Git-Junsang/Quantum-Grover/documents/reports/15_교체판_보드_콘솔.md

# 실험 15. 통신 계층 교체판 보드 콘솔

> [← 실험 14 Common500 소프트웨어 · FPGA 비교](14_Common500_SW_FPGA_비교.md) · [index](index.md) · [실험 16 세 판의 보드 Predicate500 →](16_세_판_보드_Predicate500.md)

---

| 확인한 것 | 근거의 축 |
|---|---|
| 통신 계층 교체판이 실물 보드에서 SoC 시뮬과 같은 결과를 내는가. 성능 인용에는 쓰지 않음 | 보드 콘솔 한 세션 (워크로드 하나) |

2026-09-16에 통신 계층을 교체해 생성한 비트스트림을 Arty A7-100T에 기록하고, 호스트
PC에서 UART를 통해 `bbht_console`을 제어했습니다.

| 항목 | 값 |
|---|---|
| 비트스트림 | sha256 `1b67a070…52adc61` |
| 앱 | `bbht_console.sram.hex` (UART 판, sha256 `51e1684c…2e7cf3`) |
| 적재 | Olimex ARM-USB-TINY-H JTAG로 SRAM에 |
| 호스트 | Windows 11, `bbht_cli.py --port COM6` (115200 8N1) |
| 워크로드 | M = 4, 시드 0 (SoC 시뮬과 같은 것) |

## 결과

selftest 7/7, RUN · STAT · ENUM 결과 줄 26개가 SoC 시뮬 트랜스크립트와 글자 그대로
일치합니다.

| 실행 | idx | trials | l | iters | cyc |
|---|--:|--:|--:|--:|--:|
| Normal (`BURST=0`) | 8685 | 21 | 119 | 119 | 41,310 |
| 체크포인트 첫째 | 8685 | 21 | 119 | 38 | 20,935 |
| 체크포인트 둘째 | 8685 | 21 | 119 | 38 | 17,847 |
| `ENUM` | 8685 → 2852 → 507 → 4724 | | | | 280,494 |

정책 엔진 통계(`policy_cyc` · `memo_hit` · `max_latency` 등)까지 시뮬과 같습니다.

근거는 [board_console](../../hardware_bram/models/hardware_bram_K3H3_E4_M2/vivado/vivado_bbht_grover_fpga/2026-09-17_board_console/evidence.md),
실물과 굽기·적재 묶음은
[bitstream/2026-09-17_comm_layer_rebuild](../../hardware_bram/models/hardware_bram_K3H3_E4_M2/bitstream/2026-09-17_comm_layer_rebuild/evidence.md)
입니다.

## 처음 검증된 경로

호스트 → 보드 수신 경로입니다. `read_line()`의 UART 판과 `bbht_cli.py`의 시리얼
트랜스포트는 SoC 시뮬에서 한 번도 돌지 않았습니다(스크립트 모드는 명령을 컴파일 시점
배열에서 읽습니다). 이 층에서만 나올 수 있는 문제가 실제로 하나 있었습니다.

- COM 포트를 열 때 DTR/RTS가 켜지면 SoC가 리셋됩니다. 앱이 JTAG로 올린 SRAM
  이미지뿐이라, 기본 설정으로 포트를 열면 그 뒤로 에코조차 오지 않고(`ERR HOST_TIMEOUT`)
  앱을 다시 적재해야 돌아옵니다. 한 핸들로 열어 둔 채로는 OpenOCD 종료 뒤에도 계속
  응답하고, 닫았다 다시 열면 멈추는 것으로 좁혔습니다. `SerialTransport`가 열기 전에
  둘을 내리도록 고쳤습니다.
- Windows에서 `--script` · `--log` 파일을 cp949로 열어 한글 주석에서 죽던 것을 UTF-8로
  고쳤습니다.
