Git-Junsang/Quantum-Grover/Quantum-Grover/hardware_bram/configurations/capacity3_lookahead3_pes4_singlerow_linear/vivado/vivado_bbht_grover_k3h3_e4/2026-10-08_ax7a200b_board_predicate500/evidence.md

# Stage 4 — 200T board Predicate500 (네 predicate × 500 × 두 mode, 4,000/4,000)

## 무엇인가

원격 board AX7A200B 에 이 configuration의 100T 예산 bitstream을 굽고 `bbht_console` 을 올린 뒤, 같은 원격 host에서
`software/host_fpga_develop/bbht_predicate500.py` 로 네 predicate × 500 workloads를 Restart mode · Checkpoint mode로 돌렸습니다
(2026-10-08 22:34~23:02 KST, `hardware_bram/sim/board_run.sh K3H3_E4 predicate500`). 다섯 configuration을 차례로 잰 뒤 board는 원래 설계로 되돌렸습니다.

## 확정 수치

| mode | 실행 | reference model 대비 | RTL 대비 cycle | wall-clock time sum |
|---|--:|:-:|:-:|--:|
| Restart mode | 2,000 | 2,000/2,000 | 2,000/2,000 | 621,202 µs |
| Checkpoint mode | 2,000 | 2,000/2,000 | 1,833/2,000 | 360,952 µs |

20 datasets의 FNV-1a 도 reference model과 같습니다. predicate별 표는 `result.txt` 입니다. Checkpoint mode executed iterations는
a Checkpoint-Capacity of 3 · 3-shot Lookahead 열과 맞댔습니다.

Checkpoint mode cycle 중 RTL 과 다른 실행은 대부분 ±3,279 cycles(memo table 청소 한 번)입니다. board는 네 predicate를 reset 없이
이어 돌고 RTL harness는 predicate마다 따로 돌아 청소가 일어나는 실행이 다릅니다(11장 11.5절). 합계 차이는
-8,192 cycles(-0.023%)입니다.

## 인용할 때

- board wall-clock time 축, 200T board입니다. 성능 세 축의 Board-Verified Build(100T, EQ 500)와 섞지 마십시오.
- 여섯 configuration을 맞댄 표는 [2026-10-08_board_predicate500_6models](../../../../../results/2026-10-08_board_predicate500_6models/evidence.md), RTL 은 [여섯 configuration RTL](../../../../../results/2026-10-08_predicate500_rtl_6models/evidence.md) 입니다.

## file

| file | 내용 |
|---|---|
| `predicate500.csv` | 실행 4,000 rows (reference model 대조 열 포함) |
| `result.txt` | host 도구 출력 (predicate · mode별 sum과 판정) |
| `crosscheck.txt` | RTL Predicate500 과의 cycle 대조 |
| `sha256.txt` | 굽은 bitstream과 console hex hash |
