Git-Junsang/Quantum-Grover/documents/Main_IP_Final_20260910.pptx

최종 구현 내용 · 성능 결과 · 서버 패키지 확인 위치

Main IP Final v1.3

BBHT/Grover FPGA Emulator

FINAL CONFIG

K3/H3
E4
M2

Q14 · P32 · AMP_W23/F22
Standalone FPGA + RVX SoC path

6.1401×

500-workload RTL cycle speedup vs Normal-E1

Main IP Final v1.3 | 1

## Slide 2

1. 구현한 범위

서버 패키지에서 바로 확인할 구현 단위

하나의 Main IP를 중심에 두고, 보드 단독 실행 경로와 RVX SoC 실행 경로를 분리했다.
서버에는 RTL/TB/SW/FW와 결과 파일을 같은 기준값으로 재현할 수 있게 배치했다.

Accelerator core
BBHT shot FSM
Checkpoint/policy
Grover iteration datapath
Measurement + result/status

Standalone board path
UART→APB bridge
Deterministic dataset generator
Arty A7-100T top
Host benchmark script

RVX SoC path
APB CSR control
AHB/DMA data path
Firmware benchmark
ORCA SW baseline

핵심 설계 원칙

01_RTL

02_TB

03_SW_FW

04_BUILD

05_EXPERIMENTS

07_BOARD

Main IP Final v1.3 | 2

## Slide 3

2. 기준 configuration

후속 수정 전 반드시 맞춰야 하는 값

Search scale

Q14 / N = 16,384

Parallelism

P = 32 lanes

Fixed-point

AMP_W = 23 / F22

Checkpoint

K = 3 slots

Look-ahead

H = 3 future window

Iteration datapath

E4 = 4-row/cycle

Measurement

M2 = hierarchical measurement

Board target

Arty A7-100T

Main IP Final v1.3 | 3

## Slide 4

3. 사이클 성능: 6-stage ablation

500 common workloads 기준, DUT CSR_CYCLE_COUNT 합산

Normal-E1 42.31M cycles → K3/H3-E4-M2 6.89M cycles, aggregate speedup 6.1401×

Normal-E1

42,308,335

1.0000×

baseline

K4/H4-E1

18,349,320

2.3057×

checkpoint/policy

K4/H4-E4

11,246,755

3.7618×

4-row iteration

K3/H3-E4

10,385,795

4.0737×

policy retune

K3/H3-E4-M1

8,500,620

4.9771×

measurement M1

K3/H3-E4-M2

6,890,470

6.1401×

hierarchical measurement

최종 결과

Main IP Final v1.3 | 5

## Slide 5

4. 단계별 해석

각 단계가 줄인 부분과 비용

단계별 cycle은 같은 workload 집합에서 비교해야 한다. final headline은 500 common workloads의 6-stage aggregate를 우선한다.

Stage

변경점

Cycle change(250case X, 500case)

Prev. speedup

K4/H4-E1

checkpoint/policy

42.31M → 18.35M

2.31×

K4/H4-E4

E4 datapath

18.35M → 11.25M

1.63×

K3/H3-E4

policy retune

11.25M → 10.39M

1.08×

K3/H3-E4-M1

measurement M1

10.39M → 8.50M

1.22×

K3/H3-E4-M2

measurement M2

8.50M → 6.89M

1.23×

Main IP Final v1.3 | 6

## Slide 6

5. 왜 K3/H3인가

E4 이후에는 policy/checkpoint overhead를 줄이는 쪽이 유리

K/H를 키우는 것이 항상 유리한 것이 아니라, E4로 Grover body가 짧아진 뒤에는 작은 K/H가 전체 사이클에서 더 낫다.

−69.9%

policy actions

16,266 → 4,898

−55.5%

policy cycles

76,774 → 34,184

−72.9%

policy stall

15,160 → 4,114

<- “K4/H4-E4 → K3/H3-E4 기준”

K4/H4-E4 → K3/H3-E4 직접 비교

6-case aggregate cycles: 301,404 → 288,164 (1.0459×)
physical iteration은 +4.7%였지만 policy work 감소가 total cycle을 이김.

K/H isolated E1 250-pair

K4/H4: 8,836,298 cycles
K3/H4: 8,818,101 cycles
K3/H3: 8,596,609 cycles

Main IP Final v1.3 | 7

## Slide 7

6. E4와 M2 의미

최종 Main IP에서 cycle을 줄인 datapath/measurement 변경

E4
Grover iteration을 4-row/cycle로 처리하는 datapath.
K4/H4-E1 대비 Grover body cycle을 줄인다.

Measurement single-seed anchor (target=256, result/trial/L 동일)

M2는 최종 K3/H3-E4 구성의 measurement 병목을 추가로 줄이기 위한 compile-time option이다.

M2
Measurement의 hierarchical path.
group-CDF / S_GROUP_SCAN을 활성화해 scan 비용을 줄인다.

E4 baseline

M1=0 / M2=0

11,100 cycles

E4-M1

M1=1 / M2=0

9,052 cycles

E4-M2

M1=1 / M2=1

7,045 cycles

Main IP Final v1.3 | 8

## Slide 8

7. 보드 결과와 합성 결과

서버 패키지에서 확인할 핵심 산출물

Final M2는 보드 실행 산출물과 implementation report가 같이 보존된 최종 standalone 결과다.

250-pair 기준 cycle 변화

Normal Mode | K4H4(9/2미팅전) | K3H3-E4-M2(9/11미팅전)
20,229,755 (Iteration : 14883) | 7,796,908 (Iteration : 4247) | 2,563,403 (Iteration : 4457)

Board output
K3/H3-E4-M2 clean 250 pairs
CSV + LOG 보존

Timing / resource
WNS +0.224 ns
LUT 34,399 / FF 28,847
BRAM 84.5 / DSP 128

System comparison(Real Time)
K4/H4 Normal 425,502 μs
K4/H4-E1 164,897 μs
Final M2 55,798 μs
ORCA SW 6,496,338,005 μs

Main IP Final v1.3 | 9

## Slide 9

8. 서버에서 볼 위치

코드 · 검증 · 결과 파일을 찾는 기준 경로

core / standalone / RVX adapter

standalone TB, publication TB, K/H isolated

host bench, firmware, dataset reference

standalone/Vivado, RVX, simulation scripts

board, resource, publication, K/H raw/summary

expected CSV, golden summaries

bitstream, ELF, board test 자료

SHA, file index, provenance

00_README/README_START_HERE.md · 01_RTL/core/ · 05_EXPERIMENTS/summary · 99_MANIFEST/SHA256SUMS.txt

01_RTL

02_TB

03_SW_FW

04_BUILD

05_EXPERIMENTS

06_REFERENCE_OUTPUTS

07_BOARD

99_MANIFEST

먼저 열 파일

Main IP Final v1.3 | 10
