Git-Junsang/Quantum-Grover/hardware_bram/configurations/final/vivado/vivado_bbht_grover_fpga/2026-10-07_ax7a200b_budget100t/summary.csv

model | config | build | device | vivado | clock_MHz | WNS | TNS | WHS | THS | timing_met | LUT | FF | BRAM_tile | DSP | Slices | LUT_avail | FF_avail | BRAM_avail | DSP_avail | mainip_LUT | mainip_FF | mainip_RAMB36 | mainip_RAMB18 | mainip_DSP | power_W
K3H3_E4_M2 | K3/H3-E4-M2 | ax7a200b_budget100t | xc7a200tfbg484-2 | 2026.1 | 100 | 0.052 | 0.0 | 0.03 | 0.0 | 1 | 45316 | 45210 | 116 | 132 | 15118 | 63400 | 126800 | 135 | 240 | 32234 | 28221 | 52.0 | 64.0 | 128 | 0.59
