Git-Junsang/Quantum-Grover/documents/study_references/README.md

# Quantum-Grover — 양자컴퓨터 기초이론 학습 해설서

> **중앙대학교 학부 인턴 프로젝트**
> 다중 술어 Grover 가속기를 만들기 위한 양자컴퓨팅 기초 이론 ~ 확정 설계 해설

---

## 0. 이 해설서를 읽기 전에

### 0.1 이 문서는 무엇인가요?

이 문서는 **Grover 알고리즘 FPGA 가속기 프로젝트를 처음 접하는 학부생이 양자컴퓨팅의 기초 이론부터 확정된 하드웨어 설계까지 스스로 따라갈 수 있도록** 만든 학습 해설서입니다. 단순히 공식을 나열하는 것이 아니라, **"큐비트가 무엇인지"부터 시작해 "왜 그로버 알고리즘이 $O(\sqrt{N})$ 번의 오라클 호출로 정답을 찾는지"**, 그리고 **"그 수식이 결국 어떤 회로가 되는지"** 를 처음부터 끝까지 따라갈 수 있게 설명합니다.

만들 물건은 이렇게 확정되어 있습니다. BRAM에 올린 데이터 배열 `value[i]` 중 **술어를 만족하는 인덱스**를 그로버로 찾는 **에뮬레이터 IP**입니다. 술어는 네 종류 — `value < thr_a` · `value > thr_a` · `value == thr_a` · `thr_a < value < thr_b` — 이고, 그 술어를 만족하는 칸이 몇 개인지는 데이터가 정하므로 이 IP는 처음부터 **다중 타겟**을 전제로 설계됩니다. 출력은 두 가지입니다: 조건을 만족하는 원소 **하나**를 돌려주거나, 반복 호출로 **전부 열거**하거나. 보드는 **Arty A7-100T**(`xc7a100tcsg324-1`), SoC는 **RVX**(ETRI RISC-V eXpress, `rvc_orca` RV32 코어), 큐비트는 **$n = 14$**($N = 16{,}384$)이고, 최종 구성은 보드에서 검증된 **K3/H3-E4-M2**(체크포인트 3벌 · 정책 지평 3 · 연산기 4벌 · 측정 최적화 2단)입니다. 이 숫자들의 정본은 [15.4절 설계 결정표](15_논문지도와_설계결정표.md#154-우리-프로젝트의-좌표--확정-설계-결정표)이며, 해설서 어느 장에 같은 값이 적혀 있든 어긋나면 15.4절이 이깁니다.

하드웨어를 설계하려면 먼저 알고리즘이 수학적으로 무엇을 하는지 정확히 알아야 합니다. 그래서 이 해설서는 그 수학적 모델 — 큐비트·중첩·게이트·측정·오라클·확률증폭 — 을 밑바닥부터 쌓아 올린 뒤(0~10장), 같은 개념이 메모리 지도·고정소수점 워드·FSM·버스 인터페이스로 내려앉는 과정을 따라갑니다(11~18장).

| 문서 | 위치 | 대상 | 성격 |
|---|---|---|---|
| **학습 해설서 (본 문서)** | `study_references/` | 사람·학부생 | 배경지식 + 알고리즘 해설 + 확정 설계, 읽고 배우는 **주교재** |
| 논문 해설본 | [../papers/papers_ko/](../papers/papers_ko/) | 사람·학부생 | 논문 6편의 한국어 해설, 원문 대조용 보조 자료 |
| 원문 논문·강의자료 | [../papers/](../papers/) | 모든 독자 | 원본 PDF (기초이론 3편 + FPGA·응용 논문 6편) |

### 0.2 독자에게 가정하는 것

- **알고 있다고 가정**: 복소수(크기·켤레·$e^{i\theta}$), 선형대수(벡터·행렬·행렬곱·전치), 고전 논리 게이트(AND·OR·NOT·XOR), 기초 프로그래밍, 빅오 표기법($O(n)$, $O(\log n)$).
- **처음이라고 가정하고 설명**: 큐비트·양자상태·중첩, 디랙(bra-ket) 표기법, 양자 게이트와 유니터리 행렬, 측정과 상태붕괴, 얽힘, 오라클·위상 킥백, 확률증폭, Grover·Deutsch-Jozsa 알고리즘. → 이 개념들을 **1장부터 차근차근** 설명합니다.
- **Part 5~8(11~18장)에서 추가로 가정**: FPGA 기초(LUT·FF·BRAM·DSP, RTL, 클럭). 이 프로젝트 사용자는 FPGA 경험이 있습니다. 이 배경이 없어도 1~10장(양자 이론)은 그대로 읽을 수 있고, 하드웨어 용어는 [15.7절 용어집](15_논문지도와_설계결정표.md#157-하드웨어-용어집)에 모아 두었습니다.

> 이 정도 수학 배경이 없거나 오래 잊었다면, 먼저 [부록 A. 수학 빠른 복습](A_수학_빠른복습.md) 을 보세요 — 이 해설서가 실제로 쓰는 복소수·선형대수만 추려 두었습니다. 더 깊이 원하면 3Blue1Brown의 선형대수 영상 시리즈와 복소수 기초를 권합니다. 원문 QCVC 에세이도 같은 배경을 가정합니다.

### 0.3 읽는 순서

```
처음 배우는 사람:      1장 → 2장 → ... → 9장  (순서대로)
선형대수에 익숙한 사람:   1~2장 빠르게, 3장부터 정독
그로버만 급히 볼 사람:    1·3·4·5·6.2·7장 훑고 → 9장 (모르는 개념은 앞 장 참조)
하드웨어까지 갈 사람:     9장까지 마치고 → 11 → 12 → 13 → 14 → 16 → 17 → 18
                        (FPGA 배경이 있으면 11.5·11.6절은 훑고 넘어가도 됩니다)
```

**12장을 13장 앞에 두는 것은 취향이 아닙니다.** 13장은 진폭 한 칸이 Q1.22 고정소수점이라는 것, 반올림이 어느 지점에서 일어난다는 것, 넘치면 포화한다는 것을 전부 12장의 결정으로 **전제하고** 씁니다. 12장을 건너뛰면 13장의 시프트 위치와 워드 폭이 근거 없는 숫자로 보입니다.

15장은 순서에 넣지 않았습니다. 참조용이라 11~14장을 읽은 뒤 아무 때나 펼치면 되고, 확정된 수치가 필요할 때마다 [15.4절](15_논문지도와_설계결정표.md#154-우리-프로젝트의-좌표--확정-설계-결정표)로 돌아오게 됩니다. 다만 논문을 **인용하기 전에는** 반드시 [15.6절 정오표](15_논문지도와_설계결정표.md#156-인용-시-주의--논문의-오류와-모호점)를 먼저 보세요.

각 장은 시작 부분에 **"이 장을 읽기 위한 준비"** 로 필요한 배경 지식을 링크합니다. 개념은 앞 장에서 뒤 장으로 단조롭게 쌓이도록 배치했습니다.

### 0.4 이 문서의 표기 약속

본 해설서는 이해를 돕기 위해 몇 가지 장치를 씁니다.

- **💡 비유 박스**: 추상적인 양자 개념을 일상적인 비유로 풀어줍니다.
- **🔍 계산 따라가기**: 실제 벡터·행렬 계산을 **한 줄 한 줄** 따라갑니다.
- **❓ 왜 이런가?**: 정의와 규칙의 이유·동기를 설명합니다.
- **⚠️ 흔한 오해 / 함정**: 처음 배울 때 헷갈리기 쉬운 지점을 짚습니다.
- **🔑 핵심**: 꼭 기억할 것.
- **✏️ 연습**: 스스로 확인해 볼 문제 (정답은 [10장 치트시트](10_용어정리와_치트시트.md) 또는 본문에).
- 수식은 LaTeX(`$...$`, `$$...$$`)로, 상태는 $|0\rangle$, $|\psi\rangle$ 처럼 켓(ket)으로 표기합니다.

### 0.5 이 해설서의 주제가 아닌 것

무엇을 다루지 않는지도 미리 못 박아 두겠습니다. 이 오해를 안은 채로 읽으면 뒤 장의 숫자를 전부 잘못 해석하게 됩니다.

**고전 선형 스캔과의 속도 경쟁이 아닙니다.** 그로버의 $\sqrt{N}$ 이득은 **실기 양자컴퓨터**에서 성립하는 이야기입니다. 우리가 만드는 것은 진폭 배열을 메모리에 펼쳐 놓고 흉내 내는 에뮬레이터이고, 반복 한 바퀴마다 $N$ 칸을 빠짐없이 훑어야 하므로 총비용이 $O(N\sqrt{N/M})$ 입니다 — 같은 데이터를 한 번 훑고 끝나는 고전 선형 스캔($O(N)$)보다 **느립니다.** 이 문서는 그 사실을 감추지 않습니다. 이 IP의 값어치는 속도 우위가 아니라, 양자 알고리즘의 동작을 **결정적이고 재현 가능하게 재현하고 검증하는 전용 하드웨어**라는 데 있습니다.

**정당한 비교 대상은 Qiskit AerSimulator와 NumPy 상태벡터 시뮬레이터입니다.** 같은 일(상태벡터 에뮬레이션)을 소프트웨어로 하는 물건과 견주는 것이 옳은 비교이고, [18장](18_골든모델_검증.md)의 3단 골든 모델에서 그 소프트웨어가 실제로 판정 기준 노릇을 합니다.

**최솟값 탐색은 주제가 아니라 확장입니다.** 임계값을 계단처럼 낮춰 가며 최솟값에 수렴시키는 Dürr–Høyer 루프는 하드웨어에 넣지 않고 호스트 펌웨어의 `while` 한 줄로 처리하기로 했습니다. 그래서 해설서에서도 [14.9절](14_다중정답과_최솟값탐색.md#149-확장--임계값을-낮추면-최솟값-탐색) 한 절 분량입니다.

덧붙여, 초전도·이온트랩 같은 양자 하드웨어의 물리도 범위 밖입니다 — 진폭이라는 숫자만 다루면 충분하다는 것이 [1.7절](01_큐비트와_양자상태.md#17-물리적-실체는-잊어도-된다)의 결론입니다.

---

## Part 0. 왜 양자컴퓨터인가

| 장 | 파일 | 무엇을 배우나 |
|----|---|---|
| 0 | [양자컴퓨팅 시작하기 — 튜링에서 도이치까지](00_양자컴퓨팅_시작하기.md) | 컴퓨터의 기원, 왜 양자컴퓨터인가, 고전 vs 양자, 이 프로젝트가 Grover를 다루는 이유 |

---

## Part 1. 양자컴퓨팅의 언어 (기초)

| 장 | 파일 | 무엇을 배우나 |
|----|---|---|
| 1 | [큐비트와 양자상태](01_큐비트와_양자상태.md) | 비트 vs 큐비트, 상태벡터, 계산 기저 $\|0\rangle\|1\rangle$, 진폭·중첩, 정규화 |
| 2 | [디랙 표기법과 선형대수](02_디랙표기법과_선형대수.md) | 켓·브라, 내적 $\langle\phi\|\psi\rangle$, 켤레전치(dagger), $\|+\rangle\|-\rangle$ 기저 |
| 3 | [단일 큐비트 게이트](03_단일큐비트_게이트.md) | $X\|H\|Y\|Z$ 게이트, 유니터리 행렬, 회로 표기, 게이트 합성=행렬곱 |
| 4 | [양자 측정](04_양자측정.md) | 계산 기저 측정, Born 규칙($\|\alpha\|^2$), 상태붕괴, 측정 불가 정보, 전역위상 |

---

## Part 2. 여러 큐비트와 회로

| 장 | 파일 | 무엇을 배우나 |
|----|---|---|
| 5 | [다중 큐비트와 얽힘](05_다중큐비트와_얽힘.md) | 텐서곱, $n$큐비트 상태 $2^n$차원, CNOT, 벨 상태·얽힘, 곱 상태 |
| 6 | [양자회로 모델과 범용성](06_양자회로_모델과_범용성.md) | 회로 3단계, Hadamard로 균등중첩 만들기, 병렬성, 범용 게이트·Toffoli, 회로의 순효과는 하나의 유니터리 |

---

## Part 3. 양자 알고리즘 (프로젝트 핵심)

| 장 | 파일 | 무엇을 배우나 |
|----|---|---|
| 7 | [오라클과 위상 킥백](07_오라클과_위상킥백.md) | 오라클 $U_f$, 블랙박스, 위상 킥백(phase kickback), 조건부 부호 반전 |
| 8 | [도이치-조자 알고리즘](08_도이치_조자_알고리즘.md) | Balanced vs Constant, $H^{\otimes n}$ 수학, 간섭, 한 번에 판별 |
| 9 | [**그로버 알고리즘**](09_그로버_알고리즘.md) | 확률증폭, 평균 중심 반사, 확산연산자, 기하학적 회전, 반복 횟수 $\frac{\pi}{4}\sqrt{N}$, 진폭이 실수뿐인 이유, 어느 개념이 어느 장으로 가는가 |

---

## Part 4. 참조

| 장 | 파일 | 무엇을 배우나 |
|----|---|---|
| 10 | [용어정리와 치트시트](10_용어정리와_치트시트.md) | 핵심 게이트 행렬·공식 요약, 용어집, 연습문제 정답, 원문 대조표 |
| 부록 A | [수학 빠른 복습](A_수학_빠른복습.md) | 이 해설서가 쓰는 복소수(켤레·절댓값·$e^{i\theta}$)·선형대수(벡터·행렬곱·dagger) 최소 정리 |

---

> 여기서부터(Part 5~8)가 이 프로젝트가 **실제로 만드는 물건**입니다. 여섯 편의 논문(`papers/` 2·3·4번 폴더)을 설계 질문별로 **가로질러** 읽으면서, 확정된 설계 결정을 하나씩 세워 나갑니다. 04·05·06은 이 프로젝트 지도교수 연구실(중앙대) 논문입니다.

## Part 5. 이론에서 하드웨어로 — 뼈대

| 장 | 파일 | 무엇을 배우나 |
|----|---|---|
| 11 | [상태벡터 에뮬레이터 — 메모리 지도와 자원 예산](11_상태벡터_에뮬레이터.md) | 켓 → 세 개의 배열(`amp`·`data`·`mask`), 큐비트 하나 = 메모리 두 배, 진폭을 어디에 둘 것인가, memory-bound의 두 얼굴, 병렬도 $P=32$ 와 뱅킹, 사이클 비용 모델, 에뮬레이터가 숨기는 것 |
| 12 | [진폭을 숫자로 — 고정소수점과 Q1.22](12_고정소수점과_정밀도.md) | 왜 부동소수점을 안 쓰는가, Q포맷 명명 규약, 폭을 정할 때 재는 대상이 셋이라는 것, round-half-to-even, 대칭 포화·재정규화 없음, $f_{\min}$ 공식과 그 전제, 소수부를 공식이 아니라 재서 정한 과정 |

---

## Part 6. 데이터패스 — 한 샷 안에서 벌어지는 일

| 장 | 파일 | 무엇을 배우나 |
|----|---|---|
| 13 | [오라클과 확산 — 곱셈기 없는 산술](13_오라클_확산_측정_데이터패스.md) | 한 반복 안의 FSM, 제곱근기 없이 $1/\sqrt N$ 만들기, 술어 4종이 감산기 하나를 공유하는 방법, 2의 보수 negate, $2\cdot\text{mean} - \text{amp}$ 가 회로가 되는 순간, 2패스의 필연성, 32레인 누산 순서, 곱셈기가 있는 곳과 없는 곳 |
| 14 | [다중 정답 — Born 측정과 열거](14_다중정답과_최솟값탐색.md) | 정답이 여럿이어도 오라클에는 공짜인 이유, 오라클은 조건을 판정하는 회로라는 것, 진폭 동률로 argmax가 무너지는 지점, Born 샘플링을 회로로, 그룹·행·레인 계층 측정(M1·M2), 마스크로 중복 없이 열거, 역주행 등 두 함정 |

---

## Part 7. 설계 좌표

| 장 | 파일 | 무엇을 배우나 |
|----|---|---|
| 15 | [논문 지도와 설계 결정표](15_논문지도와_설계결정표.md) | 6편 계보도, **여덟 개의 대립축**, 확정 설계 결정표(**숫자의 정본**), 플랫폼과 자원 예산, **인용 시 주의할 오류 목록**, 하드웨어 용어집 |

---

## Part 8. 샷 바깥 — 제어·시스템·검증

| 장 | 파일 | 무엇을 배우나 |
|----|---|---|
| 16 | [몇 번 돌릴지 모를 때 — BBHT 샷 루프와 체크포인트](16_반복제어와_재개캐시.md) | 왜 $M$ 을 모르는 채 시작하는가(속도가 아니라 실기 충실도), BBHT($m\leftarrow1$·$\lambda=6/5$), 평균 샷이 스무 번을 넘는 이유, 바깥 FSM과 고전 검증, **체크포인트 세 벌과 지평 3 정책**, 그 정당성, 무효화는 하드웨어가 한다 |
| 17 | [RVX SoC에 붙이기 — APB CSR · AHB DMA · UART](17_RVX_SoC_통합.md) | 가속기는 혼자 서지 않는다, RVX(`rvc_orca`·`munoc`)가 무엇인가, APB와 AHB를 같이 쓰는 이유, CSR 맵, AHB 마스터로 데이터 적재, 호스트 UART 프로토콜, 하드웨어와 펌웨어의 경계 |
| 18 | [무엇을 어떻게 증명하나 — 3단 골든 모델과 bit-exact](18_골든모델_검증.md) | 왜 검증이 설계의 일부인가, float64 → 비트정확 고정소수점 모델 → RTL의 3단 사다리, bit-exact가 성립하기 위한 조건, 9.4절 손계산이 첫 테스트 벡터, Born 샘플러와 체크포인트를 어떻게 검증하나, 잰 수치와 그 조건, 툴체인과 디렉터리 |

---

## 원문 출처

이 해설서는 프로젝트 `documents/papers/1. 양자컴퓨터 기초이론/` 의 세 자료를 학부생용으로 재구성·통합한 것입니다.

1. **Quantum Computing for the Very Curious** — Andy Matuschak & Michael Nielsen (quantum.country). 큐비트·게이트·측정·CNOT·얽힘·범용성의 기초. → 주로 1~6장.
2. **[양자컴퓨터 기초 이론] 5. 그로버 알고리즘과 도이치 알고리즘** — hgmin1159.github.io. 오라클·확률증폭·Grover·Deutsch-Jozsa 개요. → 7~9장.
3. **양자 컴퓨팅 입문 (2) - Grover's Algorithm** — infossm.github.io (Samsung SW Membership). Grover의 엄밀한 유도(위상 킥백·확산변환·기하학적 회전·반복 횟수). → 9장.

추가 참고 문헌: Sutor, R. (2019). *Dancing With Qubits*; Bernhardt, C. (2019). *Quantum Computing for Everyone*; Nielsen & Chuang, *Quantum Computation and Quantum Information*; Grover, L. K. (1996), *A fast quantum mechanical algorithm for database search*.

### Part 5~8의 원문 — 논문 6편 (`papers/` 2·3·4번 폴더)

Part 5~8은 아래 여섯 편을 설계 질문별로 가로질러 다룹니다. 각 편의 한국어 해설본은 [`../papers/papers_ko/`](../papers/papers_ko/)에 있습니다(원문 대조용).

- **[04] Developing a Grover's Emulator on Standalone FPGAs** — Choi & W. Lee (중앙대), AIMS Math. 9(11), 2024. Grover 전용 최적화 4종 + RISC-V SoC. → 11·13장(설계도).
- **[05] Precision-aware Fixed-point Emulation of Grover's** — Choi 외, W. Lee 교신 (중앙대), Quantum Inf. Process. 25:214, 2026. 절단오차 이론·$f_{\min}$ 공식. → 12장.
- **[06] Standalone FPGA-Based QAOA Emulator** — Choi 외, W. Lee (중앙대), arXiv:2502.11316, 2025. 같은 골격의 QAOA 판. → 11·13장(곱셈기 대비).
- **[07] Towards Complete and Scalable Emulation (HPRC)** — El-Araby 외 (U. Kansas), IEEE TC 72(8), 2023. 외부 DDR로 32큐비트, C2Q 초기화. → 11·12장(대조군).
- **[08] Generalized Grover's Algorithm for Multiple Phase Inversion States** — Byrnes, Forster, Tessler, PRL 120, 060501, 2018. 확산 일반화. → [11.10절](11_상태벡터_에뮬레이터.md#1110-에뮬레이터가-숨기는-것)(실기에서는 이득이지만 에뮬레이터에서는 손해가 되는 일반화) · [14.0절](14_다중정답과_최솟값탐색.md#140-기호-충돌-주의)(기호 충돌 주의).
- **[09] Quantum Minimum Searching for AUD in Wireless IoT** — Habibie 외 (INSA Lyon), IEEE IoT J. 11(12), 2024. 최솟값 탐색(DHA)의 응용 사례. → [14.9절](14_다중정답과_최솟값탐색.md#149-확장--임계값을-낮추면-최솟값-탐색) · [15장](15_논문지도와_설계결정표.md)(**확장 참고 사례**로 강등 — 남는 것은 "오라클은 조건을 판정한다"는 관점과 응용 사례 하나입니다).

여섯 편의 계보 바깥에서 설계 결정 하나를 통째로 떠받치는 논문이 한 편 더 있습니다.

- **[BBHT] Tight bounds on quantum searching** — Boyer, Brassard, Høyer, Tapp (1998). $M$ 을 모르는 채 그로버를 돌리는 표준 절차($m\leftarrow1$, $\lambda=6/5$, 실패하면 1.2배)와 성공확률 하한의 **원전**. → [16.2절](16_반복제어와_재개캐시.md#162-bbht--무작위-j와-12배-확대). 09번 논문의 Algorithm 1·2도 이 절차를 옮겨 온 것이므로, **반복 스케줄을 인용할 때는 09번이 아니라 1998년 원전을 인용하십시오.** 원문 PDF는 `papers/` 에 없습니다.

---

## 다이어그램 재생성

본문 다이어그램은 `diagrams/*.svg` 이며 소스는 `diagrams/src/*.mmd`(mermaid)입니다. 손으로 그린 SVG는 `src/` 에 대응하는 `.mmd` 가 없으며 스크립트가 건드리지 않습니다. 수정 후 재생성:

```bash
cd study_references
python3 render_diagrams.py          # src/*.mmd → diagrams/*.svg
python3 render_diagrams.py --force   # 캐시 무시 재렌더
```

---

*Last updated: 2026-09-14 · 범위: 양자컴퓨팅 기초 ~ Grover 알고리즘 ~ 다중 술어 Grover 가속기 확정 설계(Part 5~8) · 설계 기준: 보드에서 검증된 K3/H3-E4-M2 · 대상: 학부생 입문자*
