Git-Junsang/Quantum-Grover/documents/design_references/16_검증_체계.md

# 16장. 검증 체계

> [← 15장 동작 과정과 사이클 구성](15_동작_과정과_사이클_구성.md) · [index](index.md) · [17장 보드 운용 →](17_보드_운용.md)

---

검증 환경은 포트 계약 검사부터 실제 보드 시험까지 여섯 단계로 구성됩니다. 단계가
높아질수록 실행 시간과 준비 비용이 늘어나지만 실제 시스템에 더 가까운 조건을 검증합니다.

---

## 16.1 검증 단계

검증 여섯 층

| 층 | 무엇 | 도구 | 시간 |
| :-: | --- | --- | --- |
| 0 | 포트 계약 대조 | `check_ports.py` | 즉시 |
| 1 | 통신 계층·최상단 회귀 | verilator | 초~분 |
| 2 | 궤적 벤치 250쌍 / 500 워크로드 | verilator + 실제 드라이버  | 분~수십 분 |
| 3 | SoC 전체 RTL 시뮬 | Questa + 실제 RISC-V 코어  | 수 분~수 시간 |
| 4 | 합성·구현 | Vivado | 수십 분 |
| 5 | 보드 | Arty A7-100T + 호스트 UART | — |

여기에 가로지르는 축이 하나 더 있습니다. 소프트웨어 기준모델([4장](04_소프트웨어_기준모델과_정답_벡터.md))
은 RTL과 독립적으로 같은 궤적을 계산해 2층과 5층의 기준값을 제공합니다.

통신 계층이나 Main IP 를 고치면 이 순서로 올라갑니다. 3~5층을 다시 통과하기 전에는 보드
정본(기준선)을 바꾸는 논의를 하지 않습니다(인수인계 §4.2). 0~2층은 저장소 안에서 전부 돌고,
3층부터는 RVX 플랫폼과 Vivado 가 필요합니다.

---

## 16.2 0층: 포트 계약

포트 배선이 계약과 일치하는지 자동으로 확인합니다.
[`port_contract.tsv`](../../spec/port_contract.tsv)가 기준이고(2026-09-01 인수인계 docx 에서 뽑아
굳힌 것, docx 의 sha256 을 헤더에 남겼습니다. docx 는 지금 git 기록에만 있습니다),
`check_ports.py`가 wrapper 19신호 + core 61신호를 네 갈래(`stub` · `real` · `dram` · `nocheckpoint`)로
대조합니다.

이름 오타, 방향 뒤집힘, 폭 한 비트 차이, `signed` 누락, 미연결을 전부 잡습니다.

```bash
make -C hardware_bram/sim ports ports-real
```

---

## 16.3 1층: 계약의 동작

| 묶음 | 대상 | 무엇을 |
| --- | --- | --- |
| T1~T9  | [`tb_bbht_rvx.v`](../../hardware_bram/testbench/tb_bbht_rvx.v) | CSR 읽기·쓰기, DMA 적재, 결과 FIFO, start 거절 조건 |
| D1~D11 | [`tb_driver.cpp`](../../hardware_bram/testbench/tb_driver.cpp) | 실제 드라이버 C 코드와 RTL을 같이 돌려 둘의 해석이 같은지 |
| H1~H15 | [`tb_bbht_bram_top.v`](../../hardware_bram/testbench/tb_bbht_bram_top.v) | 최상단에 APB로 호스트 순서를 흉내 내고 Q14 전체 적재, NORMAL/CKPT 궤적 비교, 열거까지 |

`CORE=stub`이면 Main IP 자리에 자리 채우개를 넣어 통신 계층만 보고, `CORE=real`이면
어댑터를 거쳐 실제 Main IP에 연결합니다.

두 통신 계층 구현(보드 정본과 현재 버전)이 같은 테스트벤치에서 T1~T9 · D1~D11을 모두
통과했고, D5의 단일 탐색 사이클이 63,963으로 같았습니다.

H 묶음이 술어 네 개를 전부 씁니다: H5 `LT256`, C4 `GT16128`, H11 `RANGE 1000~1300`,
`CKPT_ENUM LT4`. 보드에서는 2026-10-04 에 네 술어를 500 워크로드씩 돌렸습니다
([실험 16](../reports/16_세_판_보드_Predicate500.md)). 이 층은 그보다 먼저, 그리고 열거까지 네 술어를 보는 자리입니다.

검증 범위의 한계: 워크로드 수가 적어 탐색 궤적의 통계적 정합성이나 정책 엔진의 소유권
결함처럼 특정 조합에서만 발생하는 문제는 확인하기 어렵습니다.

---

## 16.4 2층: 궤적 벤치

같은 워크로드를 수백 개 연달아 돌려 궤적과 사이클을 통째로 비교합니다. 자극은 실제
드라이버(`bbht_grover_driver.c`)를 그대로 컴파일해 넣으므로 보드 앱이 하는 순서와
같습니다.

| 벤치 | 워크로드 | 결과 |
| --- | --- | --- |
| [bench250](../../hardware_bram/models/hardware_bram_K3H3_E4_M2/results/2026-09-10_bench250_final_core/evidence.md) | M = 1/4/16/64/256 × 시드 50 | 궤적 250/250, 사이클 230/250 |
| [bench500](../../hardware_bram/models/hardware_bram_K3H3_E4_M2/results/2026-09-10_bench500_final_core/evidence.md) | 같은 축 × 시드 100 | 보드 M2와 5축500/500, 사이클 합 오차 0 |

`bench500`은 500개 워크로드를 한 프로세스에서 리셋 없이 연속 실행합니다. 보드 앱이 타겟수 바깥
루프 · 시드 안쪽 루프로 도는 순서를 그대로 맞춘 것이고, 이것이 6단계 ablation 캠페인
(워크로드마다 새로 시작)과의 유일한 실질 차이입니다. 그 차이가 낳는 것이
[11장 11.5절](11_체크포인트와_정책_엔진.md)의 3,279 사이클입니다.

### 이 층이 지키는 궤적 불변식

같은 시드에서 Normal과 체크포인트가 `trial_count` · `L_BBHT`를 같게 내야 합니다.
체크포인트는 진폭을 어떻게 계산하느냐만 바꾸지 탐색 궤적을 바꾸면 안 되기 때문입니다.
500/500 통과했고 `plan_fifo_mismatch`는 0입니다.

검증 범위의 한계: 테스트벤치가 통신 계층에 직접 접근하므로 실제 CPU와 NoC는 포함되지
않습니다.

---

## 16.5 3층: SoC 전체 RTL 시뮬

RVX 플랫폼 `bbht_grover_upgrade` 전체(ORCA RISC-V 코어 · micro NoC · APB/AHB NI · 우리
통신 계층 · Main IP)를 Questa로 실행합니다. 이 단계부터 실제 CPU가 NoC를 거쳐 가속기에
접근합니다.

### ① 벤치 앱

보드에 구운 것과 sha256이 같은 `bbht_paper_bench.elf`를 그대로 돌려 261쌍을 냈습니다.
verilator `bench500`과 5축 전부 일치하고, 보드 M2와도 `cycle_count`까지 261/261
같습니다([soc_rtl_paper_bench](../../hardware_bram/models/hardware_bram_K3H3_E4_M2/results/2026-09-16_soc_rtl_paper_bench/evidence.md)).

`CYCLE_COUNT`는 Main IP가 가속기 클럭으로 세는 값이라, 이것이 같다는 것은 통신 계층이
탐색의 시작과 끝을 테스트벤치와 똑같은 시점에 잡는다는 뜻입니다.

### ② 콘솔 명령 왕복

`bbht_console` 스크립트 21줄을 SoC 위에서 실행하고, 응답을 호스트 CLI의 재생
트랜스포트(`bbht_cli.py --port replay:`)에 입력해 파싱한 뒤 기준값과 대조했습니다.
어긋남 0건입니다([soc_rtl_console](../../hardware_bram/models/hardware_bram_K3H3_E4_M2/results/2026-09-16_soc_rtl_console/evidence.md)).

| 검사 | 결과  |
| --- | ----- |
| 명령 21줄의 에코 순서와 종결자 | 21/21 |
| `ID` 응답 7값 대 CSR 정본 | 7/7 |
| `RUN`/`STAT` 3회 대 같은 순서 verilator | 60/60 |
| `ENUM` 순서와 종료 사이클 | 일치  |

기준값은 [`tb_console_seq.cpp`](../../hardware_bram/testbench/tb_console_seq.cpp)가
같은 순서로 동일한 RTL에 접근해 생성합니다(`make console-seq`). 대조기는
[`soc_console_check.py`](../../hardware_bram/sim/soc_console_check.py)입니다.

이 단계의 주의 사항은 [2장 2.3절](02_개발_환경과_툴체인.md)에 정리했습니다. 스크립트 모드가
빌드에 들어갔는지 로그로 확인해야 합니다.

검증 범위의 한계: 물리 UART는 포함되지 않습니다. 시뮬레이션의 printf 모듈이 115200 baud로 받아 해독하므로
프레이밍은 돌았지만 FTDI · 보율 오차 · 핀맵은 보드에서만 봅니다. 그리고 호스트 → 보드
방향 바이트가 여기서는 한 번도 돌지 않습니다: 스크립트 모드는 명령을 컴파일 시점
배열에서 읽기 때문입니다.

---

## 16.6 4층: 합성과 구현

무엇을 읽을 수 있고 없는지는 [19장](19_합성_구현_비트스트림.md)에 있습니다. 요지만
적으면, 이 층에서 읽을 수 있는 것은 "통신 계층을 바꾸고도 같은 칩에 같은 여유로
들어간다" 까지입니다. 성능 수치를 여기서 인용하면 안 됩니다: 이 묶음에는 실행 결과가
없습니다.

---

## 16.7 5층: 보드

보드 실측 실험 전체([실험 보고서 index 「보드 실측 묶음」](../reports/index.md#보드-실측-묶음))가 이 층입니다.

---

## 16.8 자동 정합성 검사

사람이 두 곳을 따로 고치다 어긋나는 것을 막는 장치가 셋 있습니다.

| 검사 | 무엇을 | 명령 |
| --- | --- | --- |
| CSR 정본  | JSON 하나에서 헤더 넷을 생성하고, 생성 대상이 아닌 두 곳까지 대조. 반대로 RTL 안에 CSR 값을 다시 박는 것도 막음 | `python3 spec/gen_csr.py --check` |
| 포트 계약 | wrapper 19 + core 61을 세 갈래로 대조 | `make -C hardware_bram/sim ports ports-real` |
| 문서 | 죽은 링크 · 없는 앵커 · 없는 그림 · 고아 그림 · 렌더 안 된`.mmd` · 되살아난 폐기 스펙 · 본문 mermaid fence | `python3 documents/check_docs.py` |

문서 검사기로 확인할 수 없는 다음 항목은 별도로 검토해야 합니다.

- 인용한 주장이 대상 절에 실제로 있는가
- 뒤 장에서 정의되는 용어를 앞 장이 설명 없이 쓰지 않는가
- 폐기된 주장이 표현만 바꿔 살아 있지 않은가
- 실측 수치에 조건이 붙어 있는가

---

## 16.9 네 술어와 다른 두 판

2026-09-25 까지 보드에서 실측 규모로 돈 술어는 `EQ` 하나였습니다. 네 술어 × 500 워크로드(Predicate500,
[18장](18_Predicate500_자동_테스트.md))를 세 판(최종 구성 · nocheckpoint · DRAM)의 RTL 과 SoC RTL 시뮬에 걸어 SW 기준모델과
맞댔습니다. 비교 축은 `rc` · `result_index` · 술어 검증 · `trial_count` · `L_BBHT` ·
`actual_iter` 여섯입니다.

| 트리 · 층 | 결과 | 근거 |
|---|---|---|
| 체크포인트 판 RTL (Normal + CKPT) | 4,000/4,000. EQ 1,000 실행은 기존 bench500 과 사이클까지 같음 | [predicate500_rtl](../../hardware_bram/models/hardware_bram_K3H3_E4_M2/results/2026-09-25_predicate500_rtl/evidence.md) |
| 체크포인트 판 SoC RTL 시뮬 | 콘솔 16/16, 보드가 만든 데이터셋 해시 4/4. 사이클 15/16 같고 1건은 리셋 뒤 memo 청소 +3,279 | [soc_rtl_predicate500](../../hardware_bram/models/hardware_bram_K3H3_E4_M2/results/2026-09-25_soc_rtl_predicate500/evidence.md) |
| 체크포인트 없는 판 RTL | NORMAL 2,000/2,000. 체크포인트 판(M1=M2=0) NORMAL 과 사이클 · STATUS 까지 2,000/2,000 | [20장](20_체크포인트_없는_BRAM_판.md) |
| 체크포인트 없는 판 SoC RTL 시뮬 | 16/16, 해시 8/8, 사이클 16/16 | 같은 장 |
| DRAM 갈래 RTL + AXI 모델 | 2,000/2,000 (기본 지연 · 백프레셔 두 벌), 프로토콜 위반 0 | [21장](21_DRAM_갈래.md) |
| DRAM 갈래 SoC RTL 시뮬 (NoC · DDR 모델) | 16/16, 해시 8/8. 사이클은 AXI 모델의 약 1.4배 | 같은 장 |
| 세 판 보드 (2026-10-04) | 체크포인트 판 4,000 · 체크포인트 없는 판 2,000 · DRAM 갈래 2,000 이 네 축 전부 일치 | [실험 16](../reports/16_세_판_보드_Predicate500.md) |

펌웨어의 데이터셋 생성기를 호스트 gcc 로 컴파일해 SW 생성기와 20개 데이터셋의 해시 · 정답
수를 맞대는 검사도 있습니다(`make -C hardware_bram/sim console-gen`).

---

## 16.10 권장 검증 순서

```bash
# 0~1층 (몇 초)
make -C hardware_bram/sim ports lint regress driver

# 1층 전체: 어댑터 + Main IP까지 (몇 분)
make -C hardware_bram/sim real
make -C hardware_bram/sim top

# 2층 (20분쯤)
make -C hardware_bram/sim bench250

# 3층: RVX 플랫폼이 필요합니다
source /opt/rvx/rvx_setup.sh
hardware_bram/models/hardware_bram_K3H3_E4_M2/rvx/install_to_platform.sh
cd $RVX_MINI_HOME/platform/bbht_grover_upgrade && make syn && make sim_rtl

# 정합성 검사
python3 spec/gen_csr.py --check
python3 documents/check_docs.py
```

6단계 ablation과 K/H 단독 실험은 태그에서 꺼내 돌립니다
([2장 2.2절](02_개발_환경과_툴체인.md)).

---

## 16.11 남은 검증 항목

교체판의 실경과 시간, 500 워크로드 규모의 보드 실측, 보드에서의 `LT` · `GT` · `RANGE`, 체크포인트
없는 판과 DRAM 갈래의 보드 실행은 2026-10-04 묶음([실험 16](../reports/16_세_판_보드_Predicate500.md))으로 채웠습니다.

| 무엇 | 왜 남았나 |
|---|---|
| 2026-10-04 체크포인트 사이클 중 3,279 가 아닌 차이 | 청소가 다른 대기와 겹친 것으로 보이나 하나씩 확인하지 않았습니다 |
| SoC 경로의 M = 16 나머지 39시드와 M = 64 · 256 | 시뮬 시간 제한. 같은 구성의 verilator `bench500` 은 500/500 통과했습니다 |
| 3,279 사이클 차이 473건 전부의 재현 | 한 워크로드로 원인을 확인했습니다. 나머지 21건이 제각각인 이유도 미확인입니다 |
| 두 빌드의 비트스트림 해시 비교 | Vivado 판이 달라 원리상 불가능합니다 |
| SPI 플래시 부팅 | 보드 RESET 이나 포트 재열기 뒤에는 앱을 다시 적재해야 합니다 |
| ORCA ① naive 의 2,000개 실측 | 끝까지 돌리면 수년이 걸립니다. 단가 추정으로 대신하고 두 워크로드로 식을 확인했습니다([실험 19 「검증」](../reports/19_ORCA_서버_SW_기준선.md#검증)) |

Predicate500 바깥의 조건을 보드에서 볼 때는 콘솔 명령만 있으면 됩니다. 예를 들어
`GEN PRED=RANGE TARGETS=16` 뒤에 `LOAD` 와 `RUN` 을 치면 비트스트림이나 앱을 다시 올리지
않아도 됩니다.
