Git-Junsang/Quantum-Grover/documents/reports/01_골든모델_캠페인.md

# 실험 01. 골든 모델 캠페인: 기능 정합성

> [← index](index.md) · [실험 02 진폭 정밀도: Q14 와 소수부 22비트 →](02_진폭_정밀도.md)

---

| 정한 것 | 근거의 축 |
|---|---|
| 패딩 게이트, 술어 비교기 하나, 짝맞춤 불변식으로 검증 | Python 골든 모델 671,600회 |

2026-08 에 당시 RTL(v0.7g, Q14/P32/DATA16/Q1.22) 규칙을 옮긴 Python 골든 모델로 돌린
캠페인입니다. FPGA 실측이 아니고, 전체 RTL 을 671,600회 돌렸다는 뜻도 아닙니다. 체크포인트는
슬롯 하나짜리 옛 구조(`BBHT_BURST`)였습니다.

| 축 | 값 |
|---|---|
| 프로파일 | Q14 (당시 확장 후보 Q16 도 함께. Q16 은 뒤에 폐기) |
| `DATA_COUNT` | N 의 25 · 50 · 75 · 100% |
| M | 0, 1, 2의 거듭제곱, D/N 의 25 · 50 · 75 · 90 · 100% |
| 술어 | EQ · GT · LT · RANGE |
| 패딩 | SAFE, POISON (패딩 자리에 조건을 만족하는 값을 일부러 넣음) |
| 타겟 배치 | HEAD, BANK_STRIDED, RANDOM |
| 탐색 | Manual(최적 j 한 번), BBHT Normal, BBHT Burst |
| 시드 반복 | Manual 30, BBHT 100 |
| 규모 | 8,760 조건 · 671,600 실행 · BBHT attempt 6,397,040 |

| 항목 | 결과 |
|---|---:|
| 타겟 마스크 오류 (요청 M 대 popcount) | 0 / 671,600 |
| 패딩 오판정 | 0 / 671,600 |
| SAFE / POISON 불일치 | 0 / 287,040쌍 |
| 네 술어 불일치 (같은 마스크를 네 경로로 만든 비교) | 0 / 503,700 |
| Normal / Burst 결과 · 종료 · 진폭 해시 불일치 | 0 / 292,000쌍 |
| M = 0 정상 비성공 | 12,880 / 12,880 |
| M > 0 BBHT 최종 성공 | 572,800 / 572,800 |
| M > 0 Manual 1회 성공 | 84,884 / 85,920 (98.79%) |

이 캠페인에서 굳은 것은 셋입니다.

- 패딩 보호는 특정 sentinel 값에 기대지 않고 `index < DATA_COUNT` 게이트로 합니다. POISON 이
  SAFE 와 모두 같았습니다.
- 네 술어는 같은 비교기 하나로 오라클과 재검증에 씁니다. 같은 마스크면 결과 · 진폭 · 반복이 모두
  같았습니다([9장 9.2절](../design_references/09_연산_경로와_E4.md#92-산술-조각)).
- 체크포인트의 정합성은 짝맞춤 불변식으로 봅니다. 같은 시드에서 Normal 과 체크포인트는 `j` 순서,
  논리 반복, 결과가 같고 물리 반복만 줄어야 합니다. 최종 인덱스만으로 PASS 를 선언하지 않습니다.
  BBHT 가 후보를 술어로 자가 검증하므로 진폭이 깨져도 답은 맞을 수 있고, 실제로 [실험 10](10_다중엔진과_PASS2_융합.md)의 공유
  슬롯 실험이 그랬습니다.

Manual 의 비성공 1,036회는 모두 확률적 1회 측정입니다. BBHT 100% 는 한 번의 `j` 가 늘 성공했다는
뜻이 아니라 재시도 뒤의 최종 성공률입니다. M = 0 에서 BBHT 가 예산까지 도는 것(Q14 평균 attempt
32.32, 논리 반복 614.53)은 오류가 아니라 M 을 모르는 탐색의 비용입니다.

같은 무렵 전달 RTL 8케이스(Normal / Burst × `j` = 1 · 4 · 8 · 6)를 골든 모델이 인덱스 · Born 전체
가중치(`2^44`) · `L_BBHT` · 물리 반복까지 그대로 재현했습니다. 이 8케이스는 지금도 유효한
bit-exact 회귀 기준입니다.
