Git-Junsang/Quantum-Grover/documents/reports/04_열거_방식_비교.md

# 실험 04. 열거 두 방식 비교

> [← 실험 03 난수 시드 커버리지](03_난수_시드_커버리지.md) · [index](index.md) · [실험 05 체크포인트 정책 알고리즘 선정 →](05_체크포인트_정책_선정.md)

---

| 정한 것 | 근거의 축 |
|---|---|
| 열거는 found-mask 방식, Main IP 안 | 골든 모델 두 방식 대조 |

열거에서 이미 찾은 타겟을 빼는 방식을 둘 두고 골든 모델로 나란히 돌렸습니다
([3장 3.5절](../design_references/03_Grover와_BBHT_알고리즘.md#35-열거-정답을-전부-찾기)).
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
