Git-Junsang/Quantum-Grover/software/orca_grover_result/2026-10-11_predicate500/host_repeats.csv

model | repeat | total_us | total_cycles
normal | 1 | 551665 | 2910263200
normal | 2 | 554544 | 2924251460
normal | 3 | 551989 | 2911514044
normal | 4 | 552540 | 2914056648
normal | 5 | 552470 | 2913953211
normal | 6 | 559398 | 2949490807
normal | 7 | 555293 | 2928665701
normal | 8 | 553564 | 2919265154
normal | 9 | 556049 | 2931739235
normal | 10 | 552039 | 2911484479
k3h3 | 1 | 296362 | 1560657272
k3h3 | 2 | 296742 | 1562405594
k3h3 | 3 | 296042 | 1559299802
k3h3 | 4 | 298042 | 1569446321
k3h3 | 5 | 296099 | 1559398710
k3h3 | 6 | 296505 | 1561750434
k3h3 | 7 | 296871 | 1563054990
k3h3 | 8 | 296564 | 1561611728
k3h3 | 9 | 296344 | 1560827416
k3h3 | 10 | 297414 | 1566226126
