Git-Junsang/Quantum-Grover/hardware_bram/configurations/capacity3_lookahead3_pes4_dualrow_linear/vivado/vivado_bbht_grover_k3h3_e4_m1/2026-10-08_ax7a200b_board_500run/summary.csv

model | config | mode | n | total_actual_iter | total_cycles | total_elapsed_us | bench500_logic_match | bench500_cycle_match
K3H3_E4_M1 | K3/H3-E4-M1 | normal | 500 | 31424 | 13429380 | 136532 | 500/500 | 500/500
K3H3_E4_M1 | K3/H3-E4-M1 | checkpoint | 500 | 9582 | 6933385 | 71551 | 500/500 | 500/500
