Git-Junsang/Quantum-Grover/hardware_bram/models/hardware_bram_K4H4_E4/vivado/vivado_bbht_grover_k4h4_e4/2026-10-08_ax7a200b_board_500run/summary.csv

model | config | mode | n | total_actual_iter | total_cycles | total_elapsed_us | bench500_logic_match | bench500_cycle_match
K4H4_E4 | K4/H4-E4 | normal | 500 | 31424 | 15324548 | 155476 | 500/500 | 500/500
K4H4_E4 | K4/H4-E4 | checkpoint | 500 | 9058 | 9161217 | 93841 | 500/500 | 500/500
