Git-Junsang/Quantum-Grover/Quantum-Grover/hardware_bram/configurations/final_200mhz/vivado/vivado_bbht_grover_200mhz/2026-10-13_ax7a200b_board_500run/summary.csv

model | config | mode | n | total_actual_iter | total_cycles | total_elapsed_us | rtl_logic_match | rtl_cycle_match
K3H3_E4_M2_200MHz | K3/H3-E4-M2 200MHz | normal | 500 | 31424 | 12372608 | 64103 | 500/500 | 500/500
K3H3_E4_M2_200MHz | K3/H3-E4-M2 200MHz | checkpoint | 500 | 9582 | 5868798 | 31576 | 500/500 | 500/500
