Git-Junsang/Quantum-Grover/software/golden_data/2026-09-25_predicate500/predicate500_datasets.csv

predicate | threshold_a | threshold_b | target_count | bg_seed | pos_seed | gen_command | dataset_fnv1a | dataset_sha256 | first_targets
LT | -16384 | 0 | 1 | 0x5eed1234 | 0x17a02026 | GEN PRED=LT A=-16384 TARGETS=1 SEED=0x5EED1234 POS=0x17A02026 | 0xdf60e448 | cc83bc494f96de3a4d0f08c892c2762182a463ae297c6d0f8c203cf96e8e6621 | 6004
LT | -16384 | 0 | 4 | 0x5eed1234 | 0x17a02026 | GEN PRED=LT A=-16384 TARGETS=4 SEED=0x5EED1234 POS=0x17A02026 | 0x6015d0aa | 6b9fb3c750de90e9214a178ecef39a6904604b46e41c53bf5ad3902fa4a34689 | 2687 6004 13764 14622
LT | -16384 | 0 | 16 | 0x5eed1234 | 0x17a02026 | GEN PRED=LT A=-16384 TARGETS=16 SEED=0x5EED1234 POS=0x17A02026 | 0xcdc69ebc | a9d377f95619c04d6424838e711b404d1198d35307ffc4f2ac966ddfe53b6a0c | 438 2687 2815 2828 5470 5518 6004 6463
LT | -16384 | 0 | 64 | 0x5eed1234 | 0x17a02026 | GEN PRED=LT A=-16384 TARGETS=64 SEED=0x5EED1234 POS=0x17A02026 | 0x8e060871 | 06b3e4d59fb9c8e603b5f14202a7d96546b91614270544746f98cb187e209078 | 187 438 1089 1173 1951 1985 2162 2687
LT | -16384 | 0 | 256 | 0x5eed1234 | 0x17a02026 | GEN PRED=LT A=-16384 TARGETS=256 SEED=0x5EED1234 POS=0x17A02026 | 0xa569173a | 11cd53a4c6126a03625913e119dcebe50e2f68e1c18e83462909f8dac45dd254 | 17 75 187 329 438 476 483 534
GT | 16383 | 0 | 1 | 0x5eed1234 | 0x67a02026 | GEN PRED=GT A=16383 TARGETS=1 SEED=0x5EED1234 POS=0x67A02026 | 0x57f636a0 | 062e3020cb60ae9f20a869d1a084b2e24325cb87c8a227ee1da9d992d7f3e3cc | 12148
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
RANGE | -4096 | 4096 | 256 | 0x5eed1234 | 0x3a4e2026 | GEN PRED=RANGE A=-4096 B=4096 TARGETS=256 SEED=0x5EED1234 POS=0x3A4E2026 | 0x0d48036a | c7ffaed3822691194faf0d6ca400e1fbac196b87deed6f36ba9cf519c023671b | 114 160 239 318 480 533 561 591
