Git-Junsang/Quantum-Grover/hardware_bram/configurations/capacity0_pes1_singlerow_linear/vivado/vivado_bbht_grover_normal_e1/2026-10-08_arty100t_build/summary.csv

model | config | build | device | vivado | clock_MHz | WNS | TNS | WHS | THS | timing_met | LUT | FF | BRAM_tile | DSP | Slices | LUT_avail | FF_avail | BRAM_avail | DSP_avail | mainip_LUT | mainip_FF | mainip_RAMB36 | mainip_RAMB18 | mainip_DSP | power_W
Normal_E1 | Normal-E1 | arty100t_build | xc7a100tcsg324-1 | 2026.1 | 100 | 0.094 | 0.0 | 0.021 | 0.0 | 1 | 20185 | 25564 | 66 | 68 | 10187 | 63400 | 126800 | 135 | 240 | 8601 | 8631 | 2.0 | 64.0 | 64 | 0.427
