Git-Junsang/Quantum-Grover/hardware_bram/configurations/capacity3_lookahead3_pes1_singlerow_linear/vivado/vivado_bbht_grover_k3h3_e1/2026-10-07_arty100t_build/summary.csv

model | config | build | device | vivado | clock_MHz | WNS | TNS | WHS | THS | timing_met | LUT | FF | BRAM_tile | DSP | Slices | LUT_avail | FF_avail | BRAM_avail | DSP_avail | mainip_LUT | mainip_FF | mainip_RAMB36 | mainip_RAMB18 | mainip_DSP | power_W
K3H3_E1 | K3/H3-E1 | arty100t_build | xc7a100tcsg324-1 | 2026.1 | 100 | 0.267 | 0.0 | 0.01 | 0.0 | 1 | 25049 | 30339 | 87 | 68 | 11838 | 63400 | 126800 | 135 | 240 | 13404 | 13398 | 39.0 | 32.0 | 64 | 0.436
