Git-Junsang/Quantum-Grover/Quantum-Grover/hardware_bram/configurations/capacity3_lookahead3_pes4_dualrow_linear/vivado/vivado_bbht_grover_k3h3_e4_m1/2026-10-07_arty100t_build/summary.csv

model | config | build | device | vivado | clock_MHz | WNS | TNS | WHS | THS | timing_met | LUT | FF | BRAM_tile | DSP | Slices | LUT_avail | FF_avail | BRAM_avail | DSP_avail | mainip_LUT | mainip_FF | mainip_RAMB36 | mainip_RAMB18 | mainip_DSP | power_W
K3H3_E4_M1 | K3/H3-E4-M1 | arty100t_build | xc7a100tcsg324-1 | 2026.1 | 100 | 0.056 | 0.0 | 0.016 | 0.0 | 1 | 45347 | 45167 | 116 | 132 | 15029 | 63400 | 126800 | 135 | 240 | 32419 | 28178 | 52.0 | 64.0 | 128 | 0.519
