Git-Junsang/Quantum-Grover/Quantum-Grover/hardware_bram/configurations/capacity4_lookahead4_pes1_singlerow_linear/vivado/vivado_bbht_grover_k4h4_e1/2026-10-07_arty100t_build/build_info.txt

빌드 일시   2026-10-07 22:38~22:50 (KST)
플랫폼      bbht_grover_k4h4_e1
타깃        arty-100t / xc7a100tcsg324-1
구조        K4/H4-E1 (어댑터 기본값. CHECKPOINT_ENABLE=1 CKPT_K=4 POLICY_H_FUTURE=4 INTRA_ENGINES=1 MEAS_M1_ENABLE=0 MEAS_M2_ENABLE=0)
클럭 목표   가속기 100 MHz / 시스템 50 MHz
Vivado      v2026.1
RVX         /opt/rvx (로컬 전체 설치)
작업방      $RVX_MINI_HOME/platform/bbht_grover_k4h4_e1/imp_arty-100t_2026-10-07
소스        저장소 hardware_bram/src/ (커밋 6db279e 시점. f1d3767 은 설치 스크립트만 바꿔 src 가 같음)
            user/rtl 파일 중 저장소 원본과 대조한 15개 일치
절차        make imp_fpga TARGET_IMP_CLASS=arty-100t -> make imp (set_param general.maxThreads 2)
굽기        하지 않음 (이 서버에 100T 보드가 없음)
