Git-Junsang/Quantum-Grover/hardware_bram/configurations/capacity4_lookahead4_pes4_singlerow_linear/vivado/vivado_bbht_grover_k4h4_e4/2026-10-07_arty100t_build/summary.csv

model | config | build | device | vivado | clock_MHz | WNS | TNS | WHS | THS | timing_met | LUT | FF | BRAM_tile | DSP | Slices | LUT_avail | FF_avail | BRAM_avail | DSP_avail | mainip_LUT | mainip_FF | mainip_RAMB36 | mainip_RAMB18 | mainip_DSP | power_W
K4H4_E4 | K4/H4-E4 | arty100t_build | xc7a100tcsg324-1 | 2026.1 | 100 | 0.193 | 0.0 | 0.008 | 0.0 | 1 | 42495 | 42809 | 115 | 68 | 15071 | 63400 | 126800 | 135 | 240 | 29080 | 25820 | 51.0 | 64.0 | 64 | 0.489
