Git-Junsang/Quantum-Grover/software/testbench_data/2026-09-08_common500/2026-09-08_common500.md

# 2026-09-08 Common500 입력

2026-09-08 Board-Verified Build 500 runs와 같은 입력입니다. `EQ`(12345) 5 datasets(1 · 4 · 16 · 64 · 256 solutions)와 공식 seed roster
100쌍입니다.

| file | 쓰는 곳 |
|---|---|
| `datasets/dataset_target_{1,4,16,64,256}.bin` | RTL bench250/500 자극(`reference_model_develop/tb_stimulus/dump_bench_workload.py`), SoC simulation 대조(`hardware_bram/sim/soc_console_check.py`), C++ · Python benchmark, Common500 비교 실험 |
| `official_board_seed_roster.h` | 위와 같은 곳, Predicate500 자극 · expected result 생성기, ORCA app의 workload header |

dataset 다섯 개는 board benchmark app의 `hardware_bram/firmware/bbht_paper_bench/tools/reference_dataset/` 과 sha256 이 같습니다.
