Git-Junsang/Quantum-Grover/Quantum-Grover/software/orca_grover_result/2026-10-11_predicate500/2026-10-11_predicate500.md

# software baseline — ORCA board · server · FPGA, Predicate500 2,000개

## 무엇인가

accelerator를 쓰지 않는 같은 C code(`software/orca_grover_develop/`, model ① naive · ② 최적화 + a Checkpoint-Capacity of 3 and 3-shot Lookahead · ③ 최적화 Restart mode)를
두 곳에서 돌려 FPGA accelerator와 workload마다 맞댄 묶음입니다.

1. **ORCA board**: 200T board(AX7A200B)의 ORCA core(RV32IM, 50 MHz). 2026-10-11 benchmark.
2. **server**: 같은 source를 이 server의 x86 core 하나에서. RVX header 셋만 바꿔 끼웠습니다. 2026-10-11~12 benchmark.
3. **FPGA**: 같은 board의 final configuration accelerator, 2026-10-08 benchmark
   ([ax7a200b_board_predicate500](../../../hardware_bram/configurations/final/vivado/vivado_bbht_grover_fpga/2026-10-08_ax7a200b_board_predicate500/evidence.md)).
   ③ · ①은 FPGA `normal` mode, ②는 `ckpt` mode와 짝입니다.

workload는 셋 모두 네 predicate(LT · GT · EQ · RANGE) × 다섯 가지 number of solutions(1 · 4 · 16 · 64 · 256) × 100 seeds = 2,000개이고
seed가 같습니다. integer 연산만 쓰므로 결과 index · shot 수 · requested iterations · executed iterations가 세 곳에서 같아야 하고, 실제로
같습니다(verification 절).

## 확정 수치

네 predicate 2,000개의 sum입니다. 시간은 search 시작부터 결과까지(아래 조건 절).

| 실행 환경 | model | executed iterations | 시간 (µs) | cycle | cycle 출처 |
|---|---|--:|--:|--:|---|
| ORCA board | ③ 최적화 Restart mode | 125,106 | 9,512,428,962 (2시간 38분) | 475,621,448,100 | µs × 50 환산 |
| ORCA board | ② 최적화 + a Checkpoint-Capacity of 3 and 3-shot Lookahead | 37,659 | 3,511,780,574 (58.5분) | 175,589,028,700 | µs × 50 환산 |
| ORCA board | ① naive | 125,106 | **추정** 144,453,615,873,017 (약 4.58년) | 7,222,680,793,650,850 | µs × 50 환산 |
| server | ③ 최적화 Restart mode | 125,106 | 551,684 | 2,911,588,241 | perf core cycle benchmark |
| server | ② 최적화 + a Checkpoint-Capacity of 3 and 3-shot Lookahead | 37,659 | 296,748 | 1,565,215,866 | perf core cycle benchmark |
| server | ① naive | 125,106 | 12,802,056,514 (3시간 33분) | 67,272,196,979,632 | perf core cycle benchmark |
| FPGA | final configuration Restart mode | 125,106 | 478,949 (`wall_us`) | 46,886,677 | accelerator `cycle_count` (100 MHz) |
| FPGA | final configuration Checkpoint mode | 37,659 | 221,021 (`wall_us`) | 21,083,867 | accelerator `cycle_count` (100 MHz) |

server ③ · ②는 10번 돌린 실행의 workload별 median의 sum입니다. 10번의 합계는 ③ 551,665~559,398 µs,
② 296,042~298,042 µs였습니다(`host_repeats.csv`). server cycle을 시간으로 나누면 5.26~5.28 GHz로,
P-core 최대 clock(5.3 GHz)과 맞습니다.

### speedup — 시간 축

같은 mode끼리 맞댄 값입니다.

| 비교 | 전체 | 1 solution | 4 solutions | 16 solutions | 64 solutions | 256 solutions |
|---|--:|--:|--:|--:|--:|--:|
| ORCA ③ ÷ FPGA Restart mode | 19,861 | 21,708 | 20,080 | 18,089 | 15,494 | 12,227 |
| ORCA ② ÷ FPGA Checkpoint mode | 15,889 | 19,330 | 16,357 | 13,304 | 10,434 | 8,103 |
| server ③ ÷ FPGA Restart mode | 1.152 | 1.247 | 1.162 | 1.060 | 0.928 | 0.769 |
| server ② ÷ FPGA Checkpoint mode | 1.343 | 1.531 | 1.414 | 1.216 | 0.995 | 0.794 |

| 같은 환경 안에서 | ORCA board | server | FPGA |
|---|--:|--:|--:|
| Restart mode ÷ Checkpoint mode (ORCA · server는 ③ ÷ ②) | 2.709 | 1.859 | 2.167 |
| naive ÷ 최적화 (① ÷ ③) | 15,186 (추정 ÷ benchmark) | 23,205 | — |

| 같은 code, ORCA ÷ server | ③ | ② | ① |
|---|--:|--:|--:|
| 시간 speedup | 17,243 | 11,834 | 11,284 (추정 ÷ benchmark) |

### speedup — cycle 축

| 비교 | speedup |
|---|--:|
| ORCA ③ cycle ÷ FPGA Restart mode cycle | 10,144 |
| ORCA ② cycle ÷ FPGA Checkpoint mode cycle | 8,328 |
| server ③ cycle ÷ FPGA Restart mode cycle | 62.1 |
| server ② cycle ÷ FPGA Checkpoint mode cycle | 74.2 |

cycle 한 번의 길이가 셋 모두 다릅니다(ORCA 20 ns, accelerator 10 ns, server 약 0.19 ns). cycle speedup은
"같은 일에 든 clock 수"로만 읽으십시오.

## 조건

| 항목 | ORCA board | server | FPGA (2026-10-08) |
|---|---|---|---|
| hardware | AX7A200B `xc7a200tfbg484-2`, 100T 예산 implementation | Intel Core i5-14600K, P-core 하나에 고정 (③ · ② cpu 4, ① cpu 6) | 같은 board |
| clock | ORCA 50 MHz | benchmark 5.26~5.28 GHz (turbo) | accelerator 100 MHz, ORCA 50 MHz |
| compile | RVX release, `riscv64-unknown-elf-gcc -O2 -march=rv32im` | `gcc 13.3.0 -O2` (x86-64 기본, `-march` 없음). 나머지 code 생성 option은 RVX와 같음 | — |
| RVX platform | ③ `bbht_grover_upgrade` (final configuration bitstream, SRAM 128 KB, accelerator 미사용) · ② ① `orca_sw` (accelerator 없음, SRAM 256 KB) | — | `bbht_grover_upgrade` |
| 시간 구간 | `bbht_search()` 호출 앞뒤, RVX 실시간 clock(1 MHz) | 같은 구간, `CLOCK_MONOTONIC_RAW` µs | `wall_us`: 같은 board 실시간 clock으로 `COMMAND` 직전 ~ DONE |
| cycle | 시간 × 50 (환산) | 같은 구간의 user space core cycle (perf_event) | accelerator `cycle_count` |
| oracle | 미리 만든 solution 목록. 준비 시간 제외 | 같음 | iteration마다 data 16,384개 비교 |
| benchmark 횟수 | 1회 | ③ · ② 10회 (median), ① 1회 | 1회 |

- `orca_sw` platform 정의는 `software/orca_grover_develop/rvx/orca_sw.xml` 입니다. 200T implementation은 WNS +6.688 ns · WHS +0.042 ns,
  100T 예산으로 Available이 100T와 같고, 64 BRAM tiles를 씁니다. bitstream은 저장소에 두지 않고 hash만
  `sha256.txt` 에 남겼습니다.
- ③은 accelerator가 들어 있는 final configuration bitstream에서, ② · ①은 `orca_sw` 에서 쟀습니다. ② · ①은 정적 memory가
  128 KB를 넘기 때문입니다. 두 platform에서 ③의 SMOKE · CALIBRATE 시간이 같아 platform 차이는 시간에 영향이 없습니다(verification 절).
- server 실행 file의 머리줄 `SW_TIMING_SOURCE,RVX_REAL_CLOCK` · `SW_TIMING_CORE_CLK_HZ,50000000` 은 `main.c` 의
  고정 문자열이라 server에서도 그대로 찍힙니다. server 조건은 이 표가 source of truth입니다.

## verification

`validation.txt` 기준입니다.

- **BBHT trajectory**: ORCA ③ · ②, server ①, server ③ · ② 각 10회가 모두 FPGA와 seed_j · seed_meas · result_index ·
  trial_count · L_BBHT · actual_iter에서 2,000/2,000 같습니다. ②의 executed iterations 37,659는 FPGA Checkpoint mode의
  executed iterations와 workload마다 같습니다.
- **platform 사이**: 같은 model이면 ORCA와 server의 시간 열을 뺀 모든 열(종료 사유, saturation 수 포함)이 2,000/2,000
  같습니다. server ①은 ORCA ③과 BBHT trajectory가 같습니다(①도 Restart mode).
- **platform 차이 없음**: ③을 final configuration bitstream과 `orca_sw` bitstream에서 각각 돌린 값입니다.
  SMOKE 762,498 µs = 762,498 µs, CALIBRATE iteration 20회 1,283,366 µs = 1,283,366 µs, measurement 1회 54,178 µs 대 54,177 µs(1 µs tick 차이).
- **① 추정식**: 추정 = requested iterations × iteration 1회 시간 + shot 수 × measurement 1회 시간. ORCA 단가는 iteration 1,154,636,860.5 µs,
  measurement 55,027 µs입니다(`orca/naive_calib.log`). ORCA SUBSET 두 workload(GT · RANGE, 256 solutions, seed 0)를 끝까지
  돌린 benchmark와 +0.0029% 차이, server ① FULL benchmark와 server 단가 추정은 +0.81% 차이입니다.
- board · server 실행 모두 `SW_SUMMARY,pass=2000,total=2000` 입니다.

## 인용할 때

- **성능 세 축의 Board-Verified Build와 섞지 마십시오.** Board-Verified Build는 2026-09-07 build · 100T board · EQ 500입니다
  ([1장 1.5절](../../../documents/design_references/01_project_overview.md#15-성능-지표와-인용-기준)). 이 묶음은 200T board ·
  네 predicate 2,000개라 1.5절의 ORCA 116,426×와 speedup을 맞대지 않습니다. 그 116,426×는 옛 baseline
  (`orca_sw_baseline`, iteration 1회에 array를 두 번 훑음, EQ 500, checkpoint 없음) 대 final configuration의 Checkpoint mode이고, 이 묶음은 같은
  mode끼리 맞댄 값입니다.
- **ORCA ÷ FPGA의 만 단위 speedup은 algorithm 우위가 아닙니다.** 16,384 states의 state vector를 32-bit core 하나로 훑는 것과
  32 lanes로 훑는 것의 차이에 clock 2×가 곱해진 값이고, oracle 준비가 software 쪽에서 빠져 software가 조금 유리합니다.
- **server 한 core는 FPGA와 시간이 비슷합니다.** 전체로 ③은 FPGA Restart mode의 1.15×, ②는 FPGA Checkpoint mode의 1.34×이고,
  64 · 256 solutions에서는 server가 FPGA wall-clock time보다 빠릅니다. clock이 약 53× 높은 범용 core라는 점과 같이 적으십시오.
  가속 주장을 할 때는 이 비교를 빼지 마십시오.
- **server 시간은 code 배치에 ±15~20% 흔들립니다.** 시간용과 cycle용 실행 file을 따로 build했을 때(그 차이는
  `main.c` 가 넣는 header뿐) 같은 계산이 ③ 0.644 / 0.553 초, ② 0.242 / 0.297 초로 달랐습니다. 이 묶음의 값은
  시간과 cycle을 한 실행 file · 한 실행에서 같이 잰 것입니다.
- **ORCA ①은 추정값입니다.** benchmark와 같은 열에 둘 때는 추정임을 표시하십시오.
- cycle 축과 시간 축을 섞어 speedup을 만들지 마십시오. 고전 선형 scan과는 비교하지 않습니다.

## file

| file | 내용 |
|---|---|
| `summary.csv` | 실행 환경 × model × 묶음(전체, number of solutions별)의 shot 수 · requested iterations · executed iterations · 시간 · cycle sum |
| `per_run.csv` | 2,000 workloads마다 BBHT trajectory와 여덟 실행의 시간 · cycle (server ③ · ②는 10회 median, ORCA ①은 추정) |
| `host_repeats.csv` | server ③ · ② 10회 각각의 합계 |
| `validation.txt` | 형식 · BBHT trajectory · platform 사이 대조와 ① 추정식 확인 |
| `sha256.txt` | bitstream 두 개, benchmark마다 올린 app hex, source |
| `orca/` | board UART 원본. `normal_full` · `k3h3_full` · `naive_calib` · `naive_subset`, platform 대조용 `normal_smoke(_m2)` · `normal_calib(_m2)` · `k3h3_smoke` |
| `host/` | server 실행 원본. `normal_full_1..10` · `k3h3_full_1..10` · `naive_full` · `naive_calib_1..3` |

## 다시 재는 법

```bash
# 비교표 다시 만들기 (이 폴더에서)
python3 ../../../software/orca_grover_develop/tools/compare.py \
  --fpga ../../configurations/final/vivado/vivado_bbht_grover_fpga/2026-10-08_ax7a200b_board_predicate500/predicate500.csv \
  --out . --orca-normal orca/normal_full.log --orca-k3h3 orca/k3h3_full.log \
  --orca-naive-calib orca/naive_calib.log --orca-naive-subset orca/naive_subset.log \
  --host-normal host/normal_full_{1..10}.log --host-k3h3 host/k3h3_full_{1..10}.log \
  --host-naive host/naive_full.log --host-naive-calib host/naive_calib_{1..3}.log

# 서버 (예: ③ FULL)
software/orca_grover_develop/host_build/build_host.sh orca_bbht_opt_normal normal_full PROFILE=1
taskset -c 4 /tmp/orca_host_bin/normal_full > normal_full_1.log

# ORCA 보드: 플랫폼 설치 · 200T 구현 · 앱 빌드 · 측정 (자세한 순서는 각 스크립트 머리말)
#   rvx/orca_sw.xml 을 $RVX_MINI_HOME/platform/orca_sw/ 에 두고 /fpga-syn-rvx start orca_sw --budget-100t
software/orca_grover_develop/tools/build_app.sh <imp폴더> orca_bbht_opt_k3h3 PROFILE=1
software/orca_grover_develop/tools/board_run.sh start k3h3_full <bit> <imp폴더> orca_bbht_opt_k3h3 10800
software/orca_grover_develop/tools/board_run.sh fetch k3h3_full
.claude/skills/fpga-flash/scripts/sdsl_fpga.sh restore --pcie      # 끝나면 반드시
```

board 점유 시간은 ③ FULL 2시간 39분, ② FULL 59분, ① CALIBRATE 39분, ① SUBSET(두 workload) 58분이었습니다.
