Git-Junsang/Quantum-Grover/Quantum-Grover/hardware_bram/configurations/final/results/2026-09-09_repro_package_v1.0/not_bundled.md

# Excluded / not bundled

- Full 711-file Final Master evidence archive: preservation material, not needed for routine reproduction; current source, scripts, expected tables, reports, board references, firmware and ORCA sources are extracted here.
- 2,500 frozen publication simulation logs and K/H individual frozen logs: regenerated by the runner.
- Historical K4/H8, K4/H6, old Main-IP freezes and old timing-fix branches: belong in Final Master Archive, not this execution package.
- Third-party PDFs and third-party Quantum-Grover source: not needed to run the reproduction.
- ETRI/RVX framework source: external dependency, not redistributed here.
- Vivado `.jou`, `.log`, `.dcp` generated artifacts: regenerated by R4/R5.
