Git-Junsang/Quantum-Grover/hardware_bram/models/hardware_bram_K3H3_E4_M2/vivado/vivado_bbht_grover_fpga/2026-09-08_orca_1core_baseline/validation.txt

ROWS=500
MALFORMED=0
PARSE_BAD=0
UNIQUE_KEYS=500
DUPLICATE_KEYS=0
EXPECTED_ROWS=500
SEMANTIC_BAD=0
SUCCESS_BAD=0
TIMER_BAD=0
M2_ROWS=500
PAIRED_ROWS=500
PAIR_SEMANTIC_BAD=0
