Git-Junsang/Quantum-Grover/hardware_bram/results/2026-10-08_board_predicate500_6models/evidence.md

# 여섯 모델 200T 보드 Predicate500 — 네 술어 × 500 × 두 모드, 기준모델과 24,000/24,000

## 무엇인가

6단계 ablation 의 여섯 빌드를 원격 보드 AX7A200B 한 장에 차례로 굽고, `bbht_console` 과 호스트 도구
`software/host_fpga_develop/bbht_predicate500.py` 로 네 술어(LT · GT · EQ · RANGE) × 500 워크로드를 Normal · 체크포인트로
돌렸습니다(2026-10-08, 최종 모델 19:16~19:45, 나머지 다섯 21:10~23:30 KST). EQ 만 잰
[2026-10-08_board500_6models](../2026-10-08_board500_6models/evidence.md) 를 네 술어로 넓힌 것입니다.

## 확정 수치

| 모델 | 기준모델 대비 | Normal 사이클 (RTL 대비) | 체크포인트 사이클 (RTL 대비) | Normal 실경과 합 (us) | 체크포인트 실경과 합 (us) |
|---|:-:|:-:|:-:|--:|--:|
| `K4H4_E1` | 4,000/4,000 | 2,000/2,000 | 1,842/2,000 | 1,695,140 | 655,650 |
| `K3H3_E1` | 4,000/4,000 | 2,000/2,000 | 1,853/2,000 | 1,695,152 | 658,677 |
| `K4H4_E4` | 4,000/4,000 | 2,000/2,000 | 1,828/2,000 | 621,189 | 375,555 |
| `K3H3_E4` | 4,000/4,000 | 2,000/2,000 | 1,833/2,000 | 621,202 | 360,952 |
| `K3H3_E4_M1` | 4,000/4,000 | 2,000/2,000 | 1,832/2,000 | 545,998 | 286,397 |
| `K3H3_E4_M2` | 4,000/4,000 | 2,000/2,000 | 1,831/2,000 | 478,949 | 221,021 |

- **여섯 모델 모두 결과 인덱스 · 궤적 · 물리 반복 · 술어 판정이 기준모델과 실행마다 같습니다**(합 24,000/24,000).
  K4/H4 모델의 체크포인트 물리 반복은 기준모델의 K4/H4 정책으로 낸 열과 맞댔습니다.
- **Normal 사이클은 여섯 모두 RTL 과 2,000/2,000 같습니다.**
- 체크포인트 사이클은 1,828~1,853/2,000 이 RTL 과 같습니다. 어긋난 실행의 대부분은 memo 청소 한 번의 값만큼으로,
  K3/H3 은 ±3,279, **K4/H4 는 ±4,372 사이클**입니다. 보드는 네 술어를 리셋 없이 이어 돌고 RTL 하네스는 술어마다
  따로 돌아 청소가 일어나는 실행이 다른 것이고, 합계 차이는 모델마다 0.1% 미만입니다.

## 6단계 사다리 — 네 술어 합, 보드 실경과 시간 축

| 단계 | 빌드 · 모드 | 실경과 (us) | Normal-E1 대비 | 직전 단계 대비 |
|---|---|---:|---:|---:|
| Normal-E1 | `K4H4_E1` mode0 | 1,695,140 | 1.000x | — |
| K4/H4-E1 | `K4H4_E1` mode1 | 655,650 | 2.585x | -61.32% |
| K4/H4-E4 | `K4H4_E4` mode1 | 375,555 | 4.514x | -42.72% |
| K3/H3-E4 | `K3H3_E4` mode1 | 360,952 | 4.696x | -3.89% |
| K3/H3-E4-M1 | `K3H3_E4_M1` mode1 | 286,397 | 5.919x | -20.66% |
| K3/H3-E4-M2 | `K3H3_E4_M2` mode1 | 221,021 | 7.670x | -22.83% |

술어별로 보면 Normal-E1 대비 최종 구성의 배수는 술어가 바뀌어도 거의 같습니다.

| 술어 | Normal-E1 (us) | K3/H3-E4-M2 (us) | 배수 |
|---|---:|---:|---:|
| LT | 419,836 | 55,292 | 7.593x |
| GT | 443,960 | 57,055 | 7.781x |
| EQ | 425,622 | 55,919 | 7.611x |
| RANGE | 405,722 | 52,755 | 7.691x |

## 읽는 법

- EQ 한 술어의 사다리([board500_6models](../2026-10-08_board500_6models/evidence.md), 7.659x)와 네 술어 합의 사다리가
  같은 모양입니다. 구현 방식별 이득이 특정 술어에 기대지 않는다는 근거입니다.
- 최종 모델의 네 술어 합은 100T 보드의 2026-10-04 측정(Normal 478,975 · 체크포인트 221,032 us)과 거의 같고,
  Normal-E4 (`K4H4_E4` · `K3H3_E4` mode0, 621,189 · 621,202 us)는 100T 보드의 2026-10-04 체크포인트 없는 판(621,210 us)과 거의 같습니다.

## 인용할 때

- **보드 실경과 시간 축, 200T 보드**입니다. 성능 세 축의 정본(2026-09-07 빌드, 100T, EQ 500)과 섞어 배수를 만들지 마십시오.
- 합계를 인용할 때는 네 술어 2,000 실행의 합인지, EQ 500 의 합인지 함께 적으십시오.
- RTL 은 [2026-10-08_predicate500_rtl_6models](../2026-10-08_predicate500_rtl_6models/evidence.md) 입니다.

## 파일

| 파일 | 내용 |
|---|---|
| `summary.csv` | 모델 × 술어 × 모드: 기준모델 일치 · RTL 사이클 일치 · 사이클 합 · 실경과 합 |

실행별 원본은 각 모델의 `vivado/vivado_<프로젝트>/2026-10-08_ax7a200b_board_predicate500/` 에 있습니다.
