Git-Junsang/Quantum-Grover/hardware_bram/results/2026-10-08_board500_6models/evidence.md

# 여섯 모델 200T 보드 500런 — 같은 보드에서 구현 방식별 실경과 시간

## 무엇인가

6단계 ablation 의 여섯 빌드(현행 `hardware_bram/src/` 에 모델 어댑터만 달리 물림)를 원격 보드
AX7A200B 한 장에 2026-10-08 18:28~18:49 KST 에 차례로 굽고, 같은 앱 `bbht_paper_bench` 로 같은 500 워크로드
(M = 1/4/16/64/256 × 시드 100, EQ)를 Normal · 체크포인트 두 모드로 잰 결과입니다. 비트스트림은 200T 에서
100T 자원 예산을 걸어 구현했습니다([2026-10-07_impl_6models](../2026-10-07_impl_6models/evidence.md)).

**여섯 모델 모두 보드와 RTL bench500 이 논리 넷과 사이클까지 1,000/1,000 같습니다**
([2026-10-07_bench500_6models](../2026-10-07_bench500_6models/evidence.md)). 앱 자체 판정도 여섯 모두 PASS 입니다.

## 확정 수치 — 빌드별

| 모델 | mode0 사이클 | mode0 실경과 (us) | mode1 사이클 | mode1 실경과 (us) | Normal-E1 대비 (mode1) |
|---|---:|---:|---:|---:|---:|
| `K4H4_E1` | 42,308,335 | 425,322 | 16,249,048 | 164,725 | 2.582x |
| `K3H3_E1` | 42,308,335 | 425,310 | 16,386,112 | 166,103 | 2.561x |
| `K4H4_E4` | 15,324,548 | 155,476 | 9,161,217 | 93,841 | 4.532x |
| `K3H3_E4` | 15,324,548 | 155,483 | 8,812,672 | 90,350 | 4.707x |
| `K3H3_E4_M1` | 13,429,380 | 136,532 | 6,933,385 | 71,551 | 5.944x |
| `K3H3_E4_M2` | 11,785,382 | 120,077 | 5,328,877 | 55,529 | 7.659x |

## 6단계 사다리 — 보드 실경과 시간 축

| 단계 | 빌드 · 모드 | 실경과 (us) | Normal-E1 대비 | 직전 단계 대비 |
|---|---|---:|---:|---:|
| Normal-E1 | `K4H4_E1` mode0 | 425,322 | 1.000x | — |
| K4/H4-E1 | `K4H4_E1` mode1 | 164,725 | 2.582x | -61.27% |
| K4/H4-E4 | `K4H4_E4` mode1 | 93,841 | 4.532x | -43.03% |
| K3/H3-E4 | `K3H3_E4` mode1 | 90,350 | 4.707x | -3.72% |
| K3/H3-E4-M1 | `K3H3_E4_M1` mode1 | 71,551 | 5.944x | -20.81% |
| K3/H3-E4-M2 | `K3H3_E4_M2` mode1 | 55,529 | 7.659x | -22.39% |

Normal-E1 은 6단계 ablation 과 같게 `K4H4_E1` 빌드의 mode0 입니다. 체크포인트 하드웨어를 뺀 `Normal_E1` 빌드는
자원 근거로만 썼고 보드에서 돌리지 않았습니다. 그 빌드는 bench500 에서 물리 반복 · 샷마다 2사이클씩,
합계 0.18% 빠릅니다([Normal_E1 bench500](../../models/hardware_bram_Normal_E1/results/2026-10-08_bench500/evidence.md)).

## 읽는 법

- 같은 보드 · 같은 앱 · 같은 워크로드라 **구현 방식만 다른 비교**입니다. 논문의 "동일 하드웨어에서 구현
  방식별 비교" 가 이 표입니다.
- 200T 의 Normal-E1 → K3/H3-E4-M2 배수는 100T 정본(425,502 → 55,798 us, 7.626x)과 거의 같습니다. 같은
  사이클에 실행마다 붙는 고정 시간만 조금 다릅니다.
- E1 에서는 K3/H3 가 K4/H4 보다 조금 느립니다. bench500 사이클도 같은 방향이라 측정 오차가 아닙니다.
  K/H 축소의 이득은 E4 에서 나옵니다.
- 최종 모델은 세 번 쟀습니다(18:28, 18:47, 18:49). 사이클은 세 번 모두 bench500 과 같고, 실경과는
  체크포인트 55,535 · 55,531 · 55,529 us, Normal 120,083 · 120,074 · 120,077 us 로 6 us 안입니다.
  이 표의 M2 는 18:49 측정입니다.

## 인용할 때

- **보드 실경과 시간 축, 200T 보드**입니다. 성능 세 축의 정본(2026-09-07 빌드, 100T)과 섞어 배수를 만들지
  마십시오. 이 묶음은 2026-10-04 묶음처럼 같은 보드 위 판 사이 비교의 인용처입니다.
- RTL 사이클 축은 bench500 묶음, 자원은 impl 묶음(Arty 100T)에서 인용합니다.
- ORCA 1코어 대비 배수는 아직 200T 에서 재지 않았습니다.

## 파일

| 파일 | 내용 |
|---|---|
| `summary.csv` | 모델 × 모드 총계 (사이클 · 실경과 · bench500 일치) |
| `by_target.csv` | 모델 × 모드 × 타겟 수 |

실행별 원본과 UART 로그는 각 모델의 `vivado/vivado_<프로젝트>/2026-10-08_ax7a200b_board_500run/` 에 있습니다.
