Git-Junsang/Quantum-Grover/_workspace/2026-10-29-001-c0b0/.artifacts/18_reference_model_verification/02_diagnosis.md

# 18_reference_model_verification.md 진단

## 장르·레지스터와 보존 조건

학부생용 기술 해설서(report). 본문은 친근한 존댓말(합니다/입니다, 일부 해요체 설명), 수식 풀이·표·요약은 압축형입니다. 문장 격식을 올리지 않습니다. 영어 용어와 영어 토큰은 번역·삭제·교체·대소문자 변경하지 않습니다. glossary 기준은 `documents/design_references/22_appendix_glossary_and_retired_specs.md` §22.2입니다. 수치·수식·code·제목·link·직접 인용·기존 콜아웃/이모지·문단 구조는 보존합니다. 실제 주장, 부정/긍정, 인과, 조건, 확신도도 보존합니다. 보고서용 서식 축약·영어 순화 규칙은 적용하지 않습니다. 본문에 사실을 추가하거나 현행 설계와 대조해 기술 내용을 고치지 않습니다.

## 정량 근거

입력의 정량 블록을 확인했습니다. risk_band는 low이고, 장문 파일의 heavy 권고는 문서 길이에서 나옵니다. 영어 기술 term 반복은 장르상 필수이므로 lexical_diversity의 낮은 값만으로 수정하지 않습니다. 아래 수치는 탐지 보조이며 개별 문맥과 함께 판단합니다.

## 겨냥 순서의 지배 패턴

1. **D-14·D-5 — 시험·설계를 사람처럼 서술하는 표현**: "규칙이 여기서 처음 일합니다", "종료 규칙이 일해야", "FSM이 매달리지 않고", "이 발판 위", "circuit은 … 조용히 틀립니다", "끝까지 정직하게 계산" 등이 직접적인 동작 설명을 흐립니다. 조건과 보장 수준을 보존하고 구체적인 서술로 정리합니다.

2. **A-18·A-7 — 장문·have 직역**: 정량 relative_clause_nesting=7, have_make_literal_count=1. 도입의 두 근거, 18.2절 ladder, 18.4절 예제, 18.7절 checkpoint 경로, 18.8절 비교 조건의 문장을 검토합니다. "오류를 갖고" 등 소유 직역과 여러 층의 수식을 겹친 문장만 국소 수정합니다.

3. **D-8·C-8 — 핵심 강조·부정 대구의 반복**: "이 목록에서 얻을 교훈은 목록 그 자체가 아니라 태도", "주는 것은 속도가 아니라", "묻는 것은", "근사적으로 같은 정도가 아니라" 등이 반복됩니다. equivalence와 distribution, algorithm과 circuit, bit-exact와 오차 허용 구분처럼 기술적으로 필요한 대조는 반드시 보존합니다.

4. **D-2·F-1 — 과한 중요성·평가 표현**: "공짜가 아닙니다", "영원히 일치하지 않고", "이보다 좋은 출발점은 없습니다", "실행된 적 없는 code가 옳을 probability는 낮습니다" 등 단정·평가의 수사만 줄입니다. 원문 사실이나 기준을 새로 해석하지 않습니다.

5. **J-2·J-3·C-11 — 대시·따옴표·쉼표로 끊긴 설명**: 연속된 대시 부연과 수사형 따옴표를 확인합니다. 표·목록의 교육적 구조와 기존 콜아웃·강조를 보존하고 산문에서 불필요한 쉼표·감싸는 표현만 정리합니다.

## 비적용·잔존 처리

교육적 질문·표·연습문제·단계 목록·기존 비유는 그 자체로 결함이 아닙니다. 자연스러운 문장은 그대로 두고 확인된 구간만 보수적으로 다듬습니다. 수치/기술 주장에 의문이 있어도 이번 윤문에서는 보존합니다.
