Git-Junsang/Quantum-Grover/Quantum-Grover/hardware_bram/results/2026-10-29_engine_sweep/evidence.md

# iteration engines × square engines sweep과 200T resource 판정

기록일: 2026-10-29, Asia/Seoul. 실험 보고서는 [실험 38](../../../documents/reports/38_iteration_square_engine_sweep_200t.md)입니다.

측정 축은 **Normal(Restart) mode의 RTL cycle**입니다. Checkpoint mode의 checkpoint 재사용과 policy stall이 들어가지 않으므로,
Checkpoint mode 총 cycle(예: 실험 26의 Triple-Row Build 4,566,996 cycles)과 비교하는 값이 아닙니다. 200T 판정은
synthesis 결과가 아니라 기존 build의 모듈 단가와 RTL memory 구조로 낸 대략 계산입니다. timing은 판정에 들어가지 않습니다.

## 층화 표본 확인

[`subset_check/`](subset_check/comparison.json)에서 `BENCH_PER_M=4`(target count 1 · 4 · 16 · 64 · 256마다 seed 0~3,
20 workloads)로 iteration engines 4 / square engines 2와 20 / 11 두 구성을 실행했습니다. 정책 설정은 두 구성 모두
[실험 37](../2026-10-29_generalized_e20_m11/evidence.md)의 full Common500 실행과 같습니다.

| 구성 | 같은 20 workloads의 행 일치 | shot당 cycle로 낸 Common500 Normal 합계 | 실측 500 workloads | 차이 |
|---|---|---:|---:|---:|
| iteration 4 · square 2 | Normal 20/20, Checkpoint 20/20 byte 동일 | 11,790,834 | 11,785,382 | +0.046% |
| iteration 20 · square 11 | Normal 20/20, Checkpoint 20/20 byte 동일 | 3,070,602 | 3,065,150 | +0.178% |

workload를 건너뛰어도 남은 workload의 결과와 cycle은 바뀌지 않습니다. 기존 `BENCH_LIMIT` 경로는 수정 뒤에도 iteration
engines 4 / square engines 2의 2 workloads가 500 workloads 실행의 첫 4행과 같았습니다.
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
