Git-Junsang/Quantum-Grover/hardware_bram/results/2026-10-26_kh_sweep_method1/kh_heatmap.png

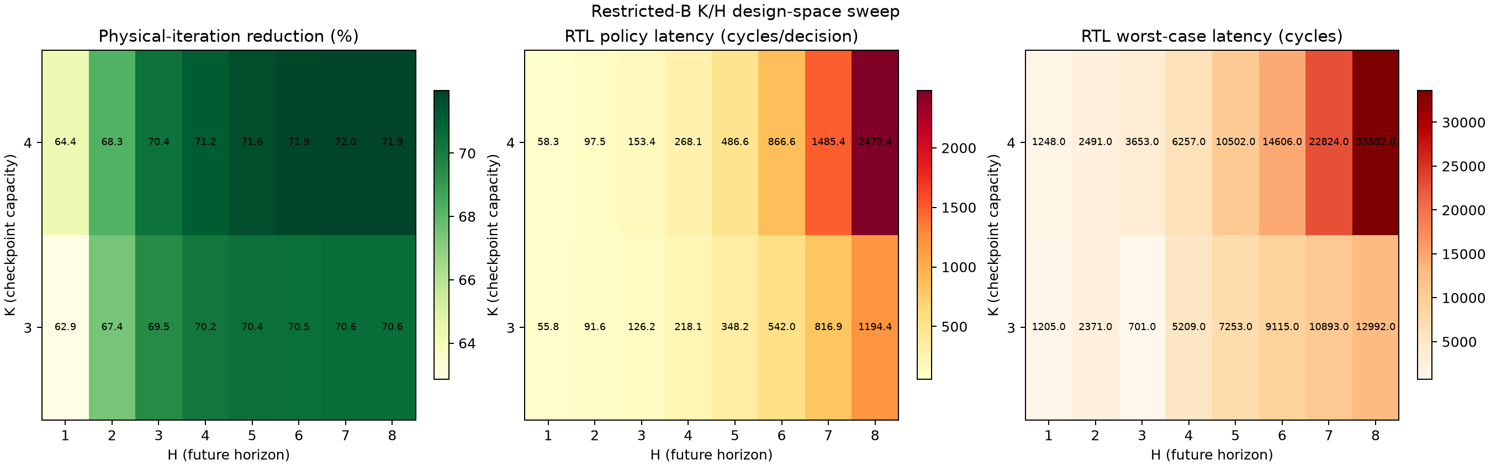
hardware_bram/results/2026-10-26_kh_sweep_method1/kh_heatmap.png
