Git-Junsang/Quantum-Grover/hardware_bram/results/2026-10-27_200t_kh_smoke/heatmap_e4_b4_p6.png

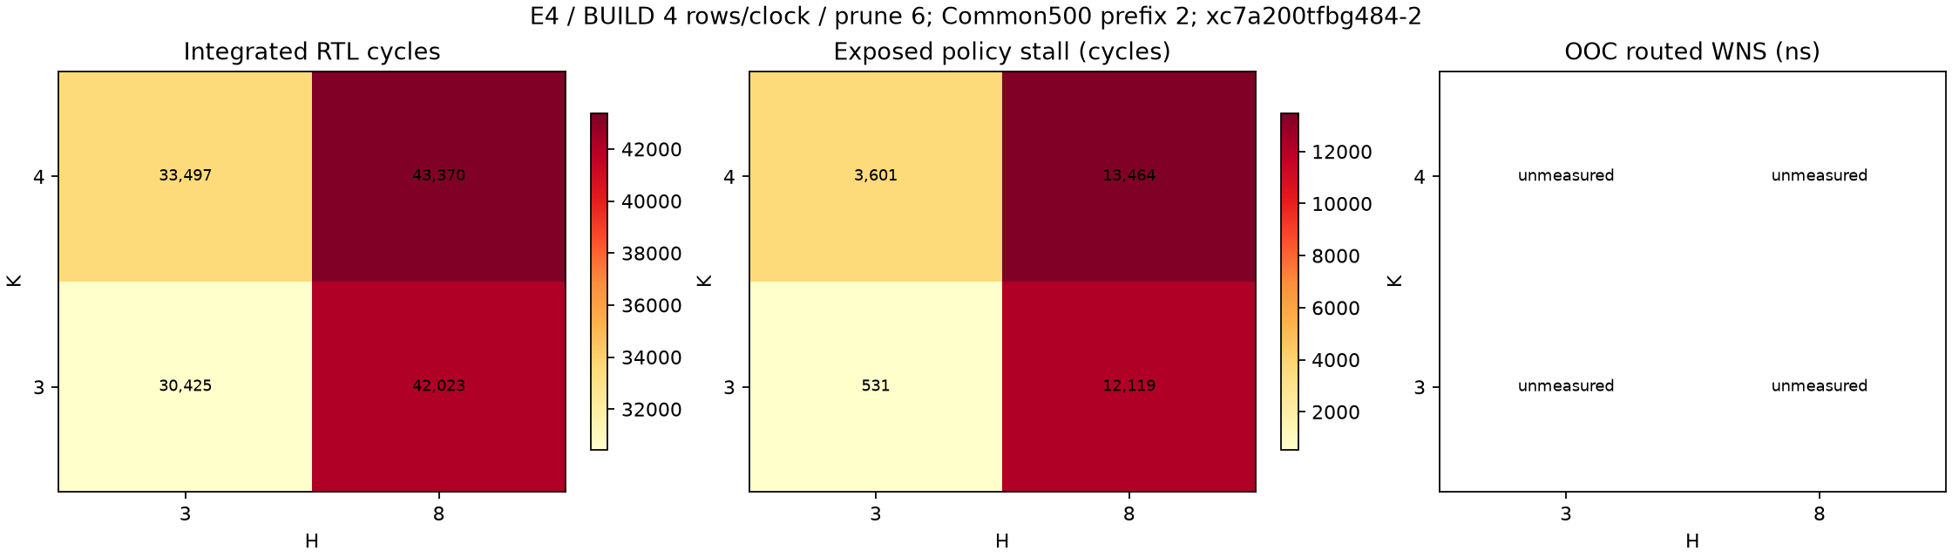
hardware_bram/results/2026-10-27_200t_kh_smoke/heatmap_e4_b4_p6.png
