Git-Junsang/Quantum-Grover/hardware_bram/results/2026-10-27_policy_unpipeline_v3/heatmap_e4_b3_p6.png

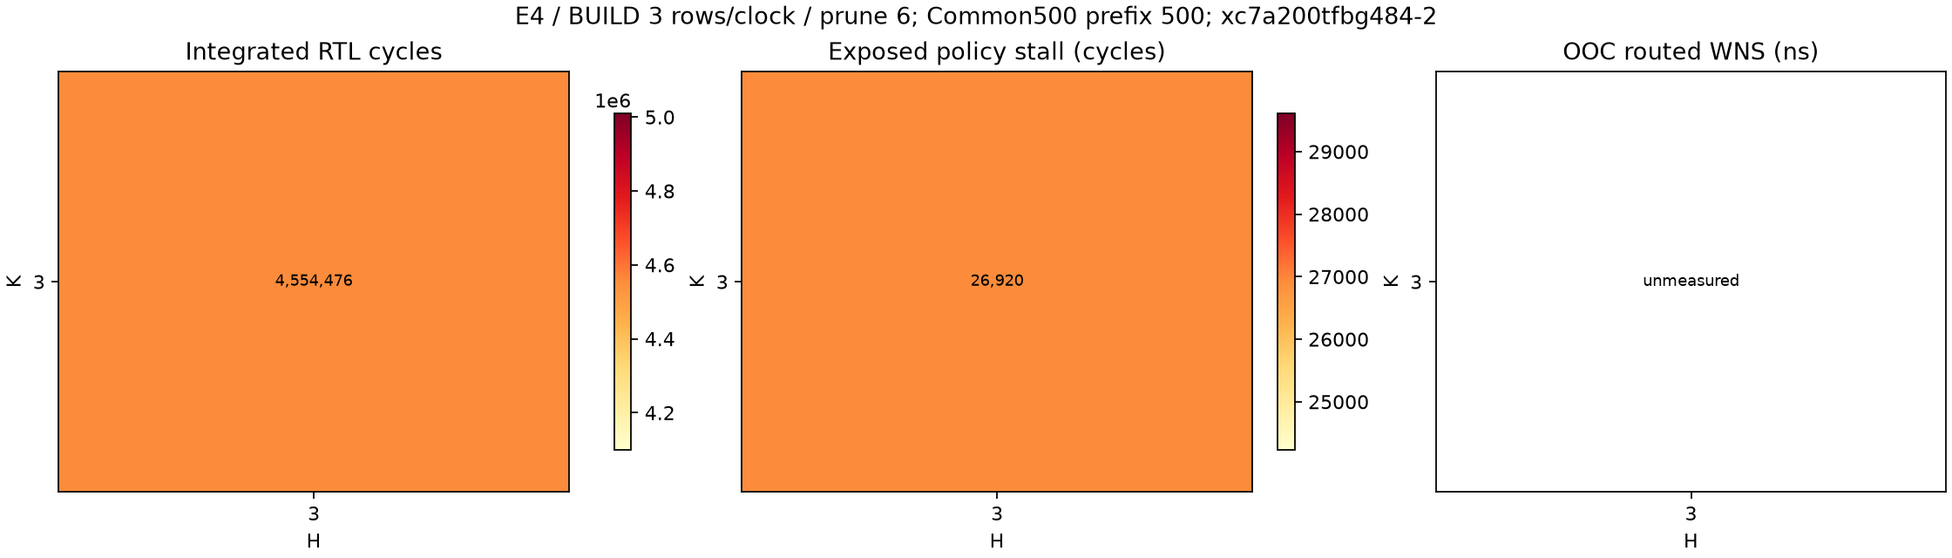
hardware_bram/results/2026-10-27_policy_unpipeline_v3/heatmap_e4_b3_p6.png
