Git-Junsang/Quantum-Grover/hardware_bram/results/2026-10-28_policy_unpipeline_timingfix/heatmap_e4_b3_p6.png

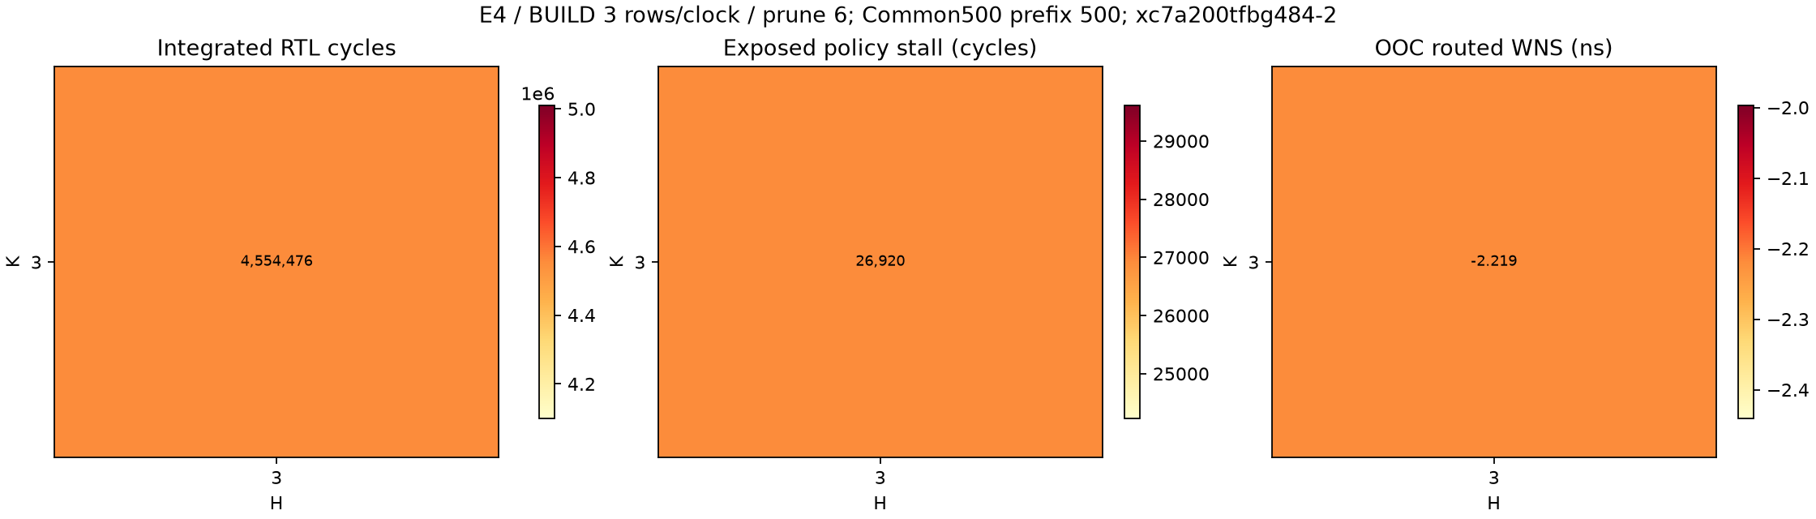
hardware_bram/results/2026-10-28_policy_unpipeline_timingfix/heatmap_e4_b3_p6.png
