Git-Junsang/Quantum-Grover/hardware_bram/results/2026-10-29_checkpoint_sweep/workloads100/e7m4/anchor_kh.png

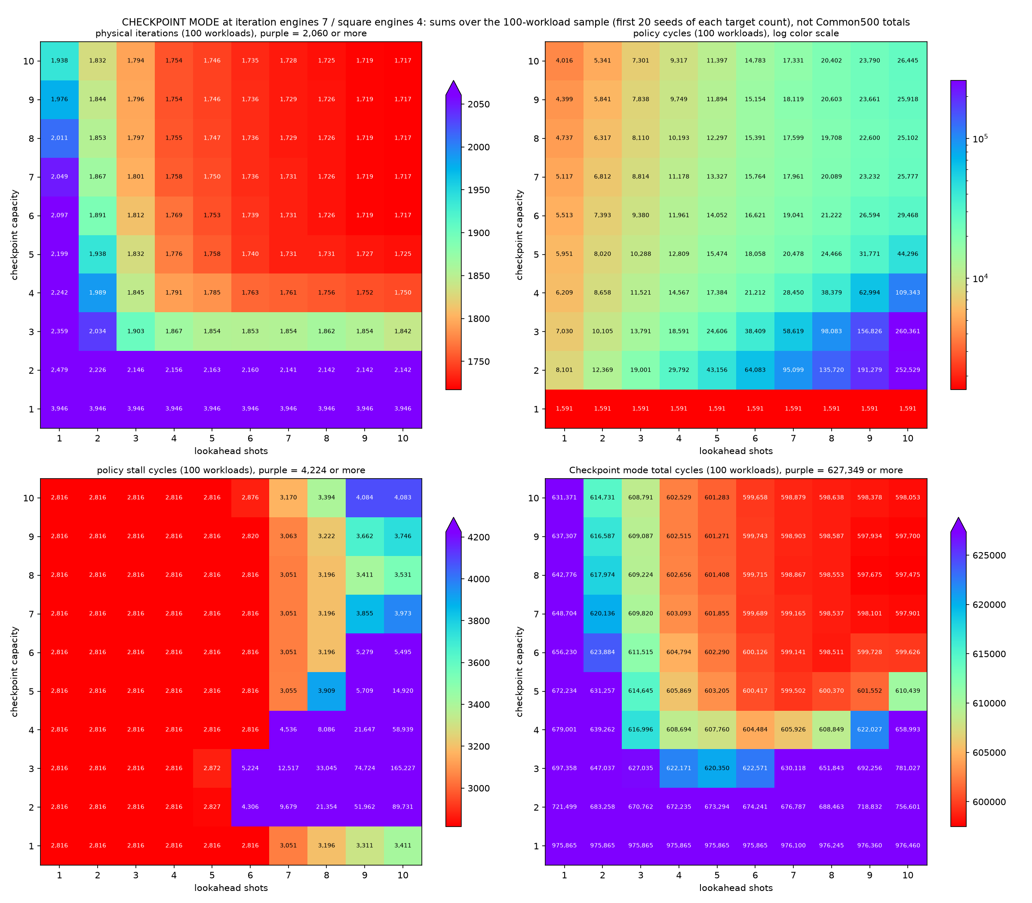
hardware_bram/results/2026-10-29_checkpoint_sweep/workloads100/e7m4/anchor_kh.png
