Git-Junsang/Quantum-Grover/hardware_bram/results/2026-10-29_engine_sweep/normal_mode_heatmap.png

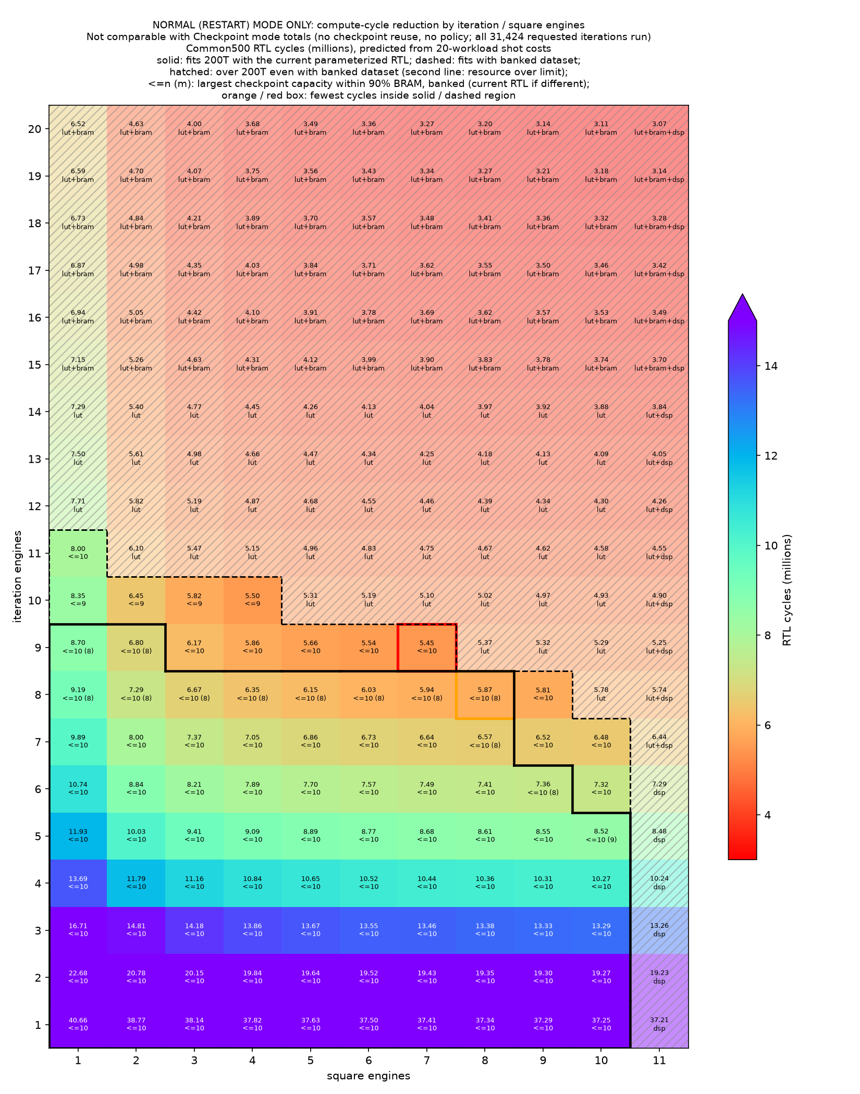
hardware_bram/results/2026-10-29_engine_sweep/normal_mode_heatmap.png
