Git-Junsang/Quantum-Grover/hardware_bram/results/2026-10-29_generalized_common500/kh40_final/policy_bottlenecks.png

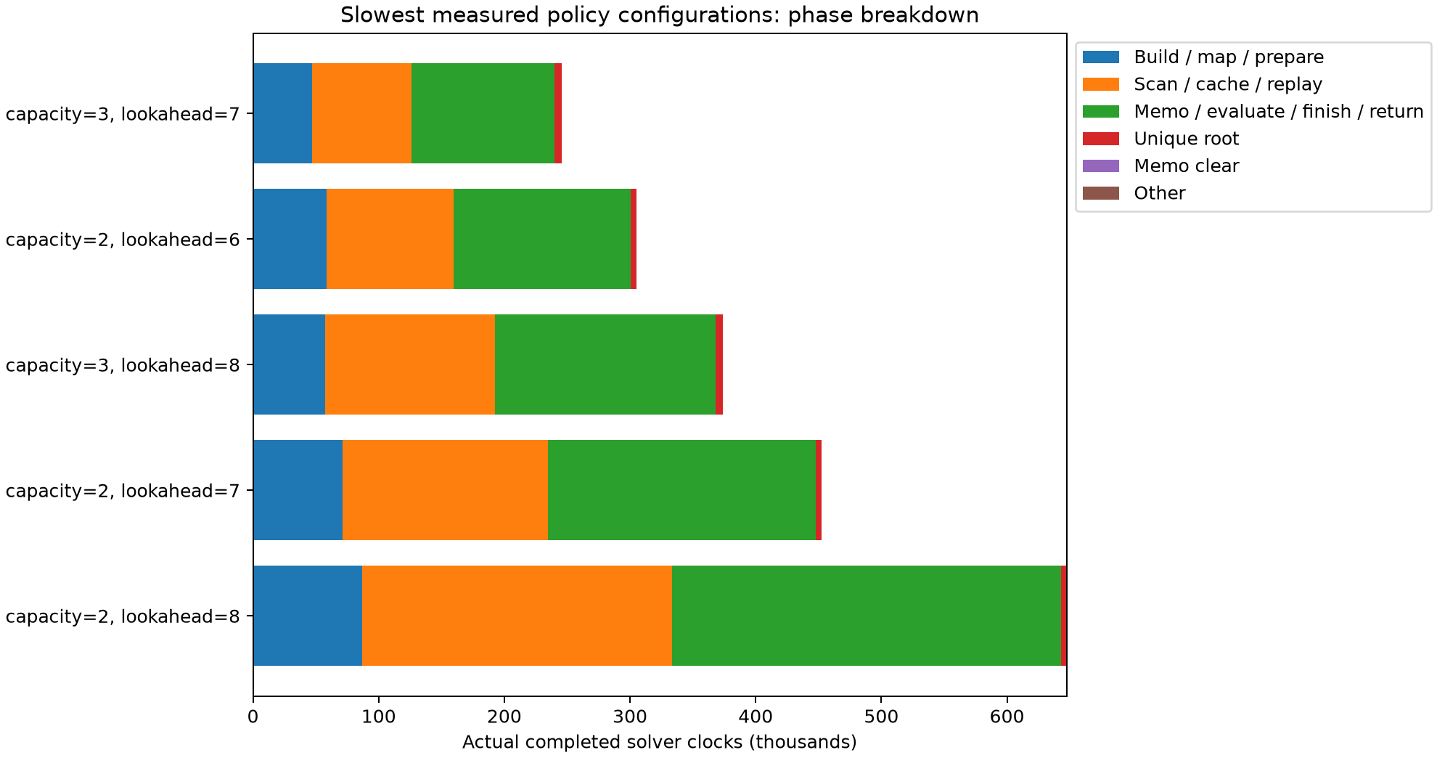
hardware_bram/results/2026-10-29_generalized_common500/kh40_final/policy_bottlenecks.png
