Git-Junsang/Quantum-Grover/hardware_bram/results/2026-10-29_policy_cache_capacity/candidate_cache_heatmap.png

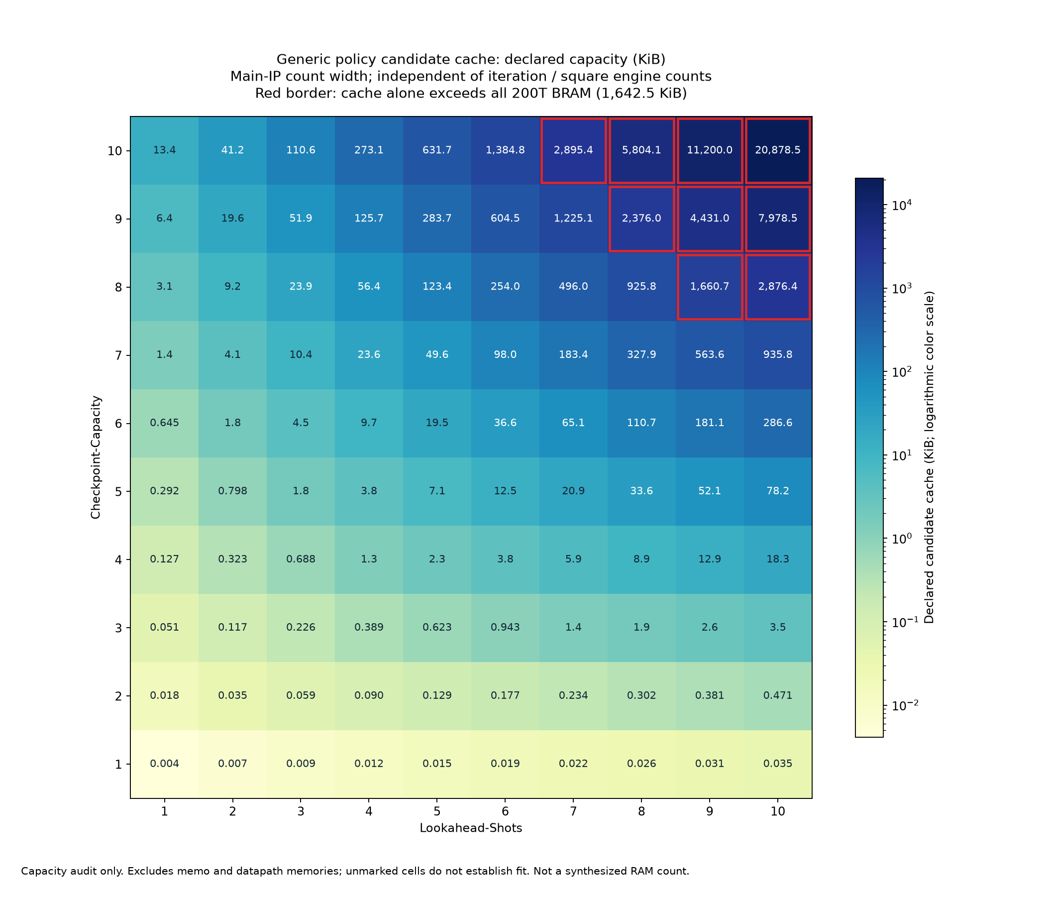
hardware_bram/results/2026-10-29_policy_cache_capacity/candidate_cache_heatmap.png
