Git-Junsang/Quantum-Grover/documents/papers/1. 양자컴퓨터 기초이론/양자컴퓨터 기초이론 2. 그로버 알고리즘.pdf

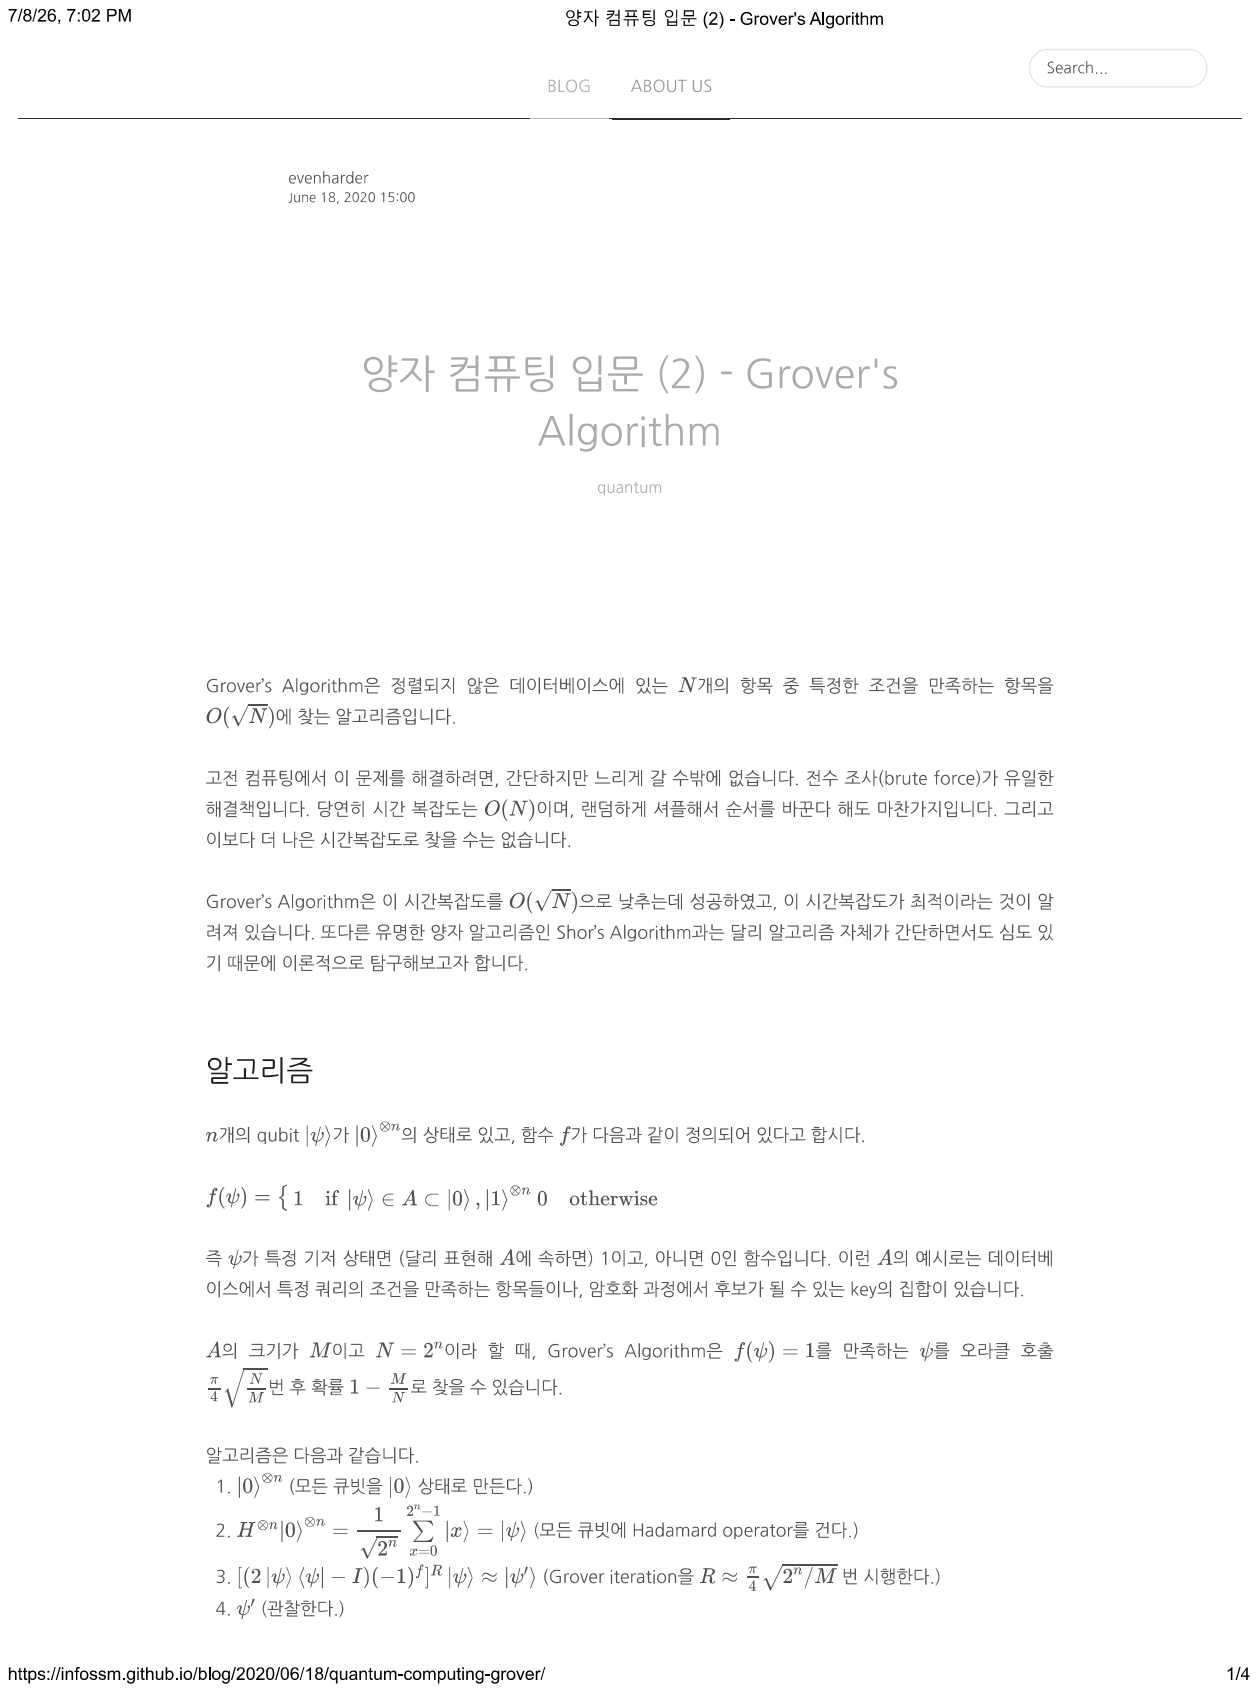
[picture p14: page 1]

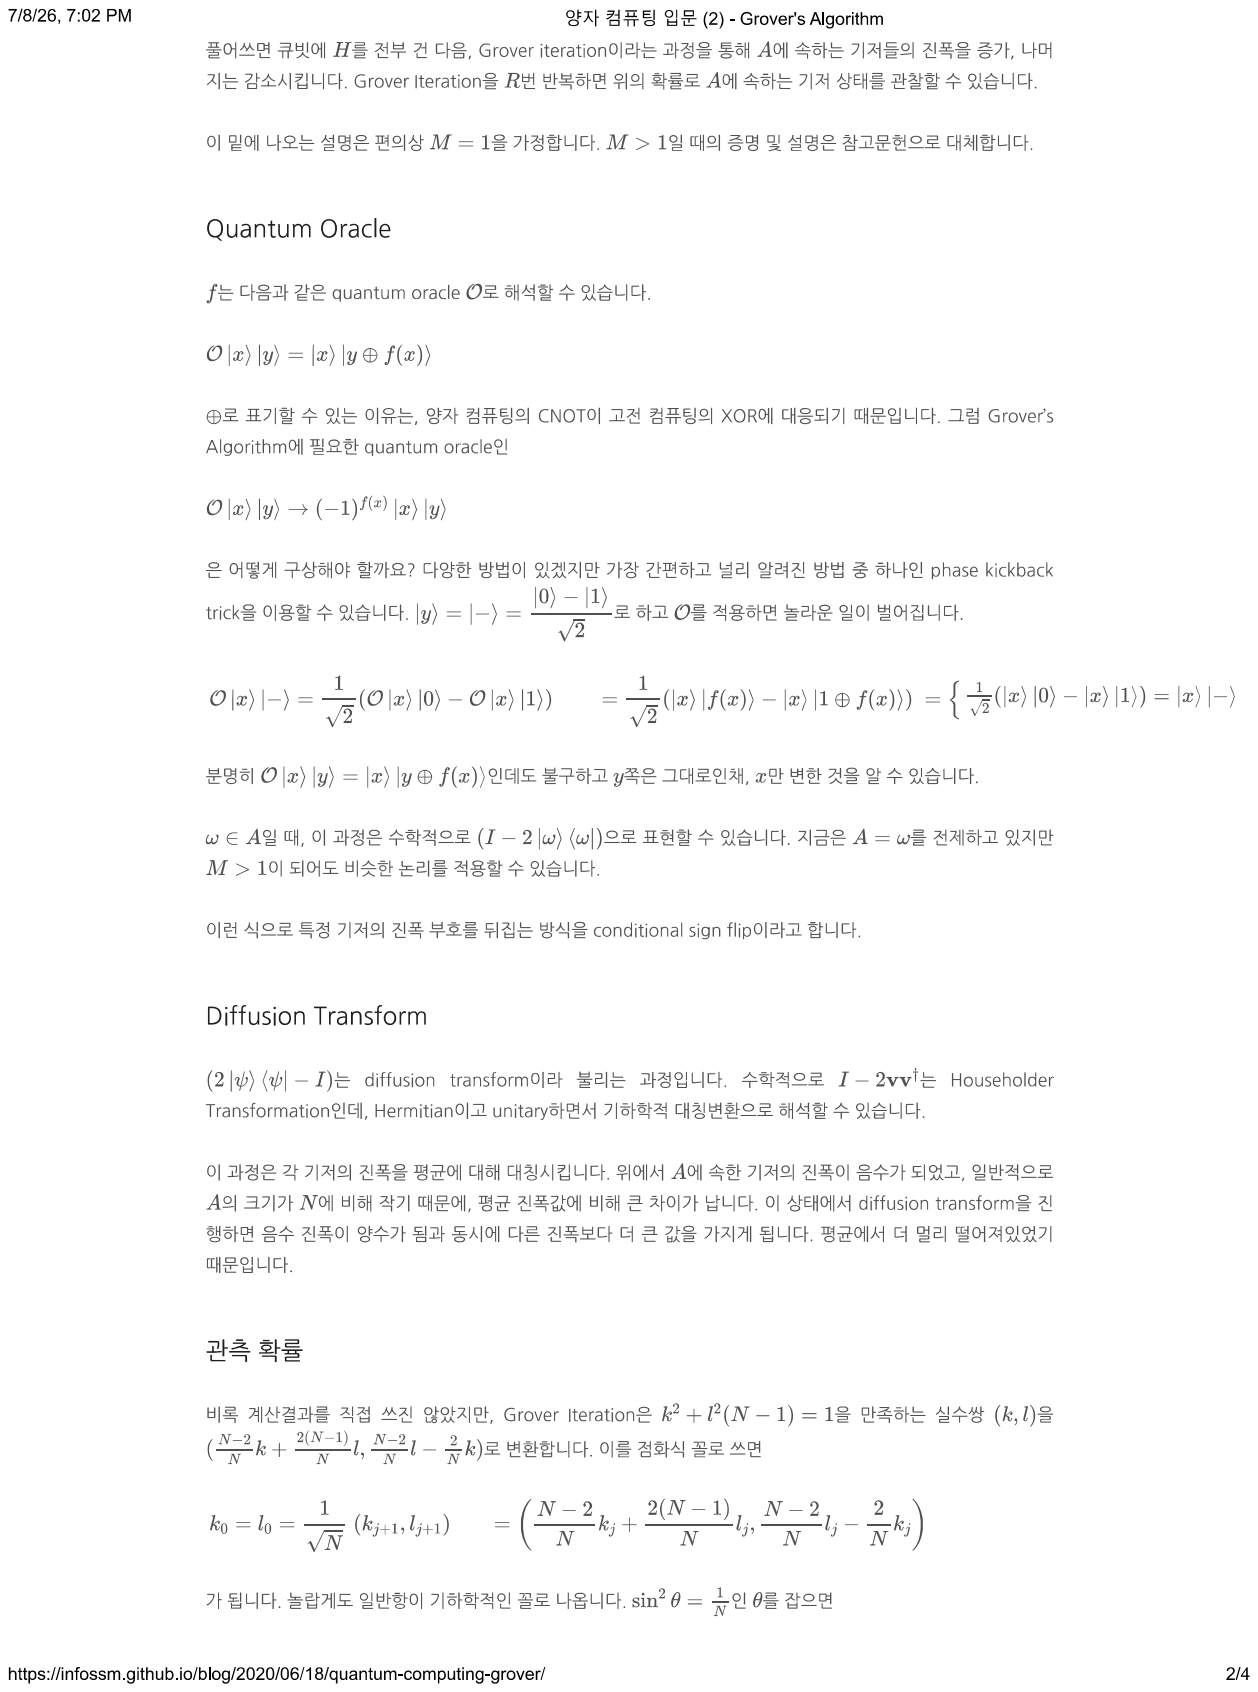
[picture p15: page 2]

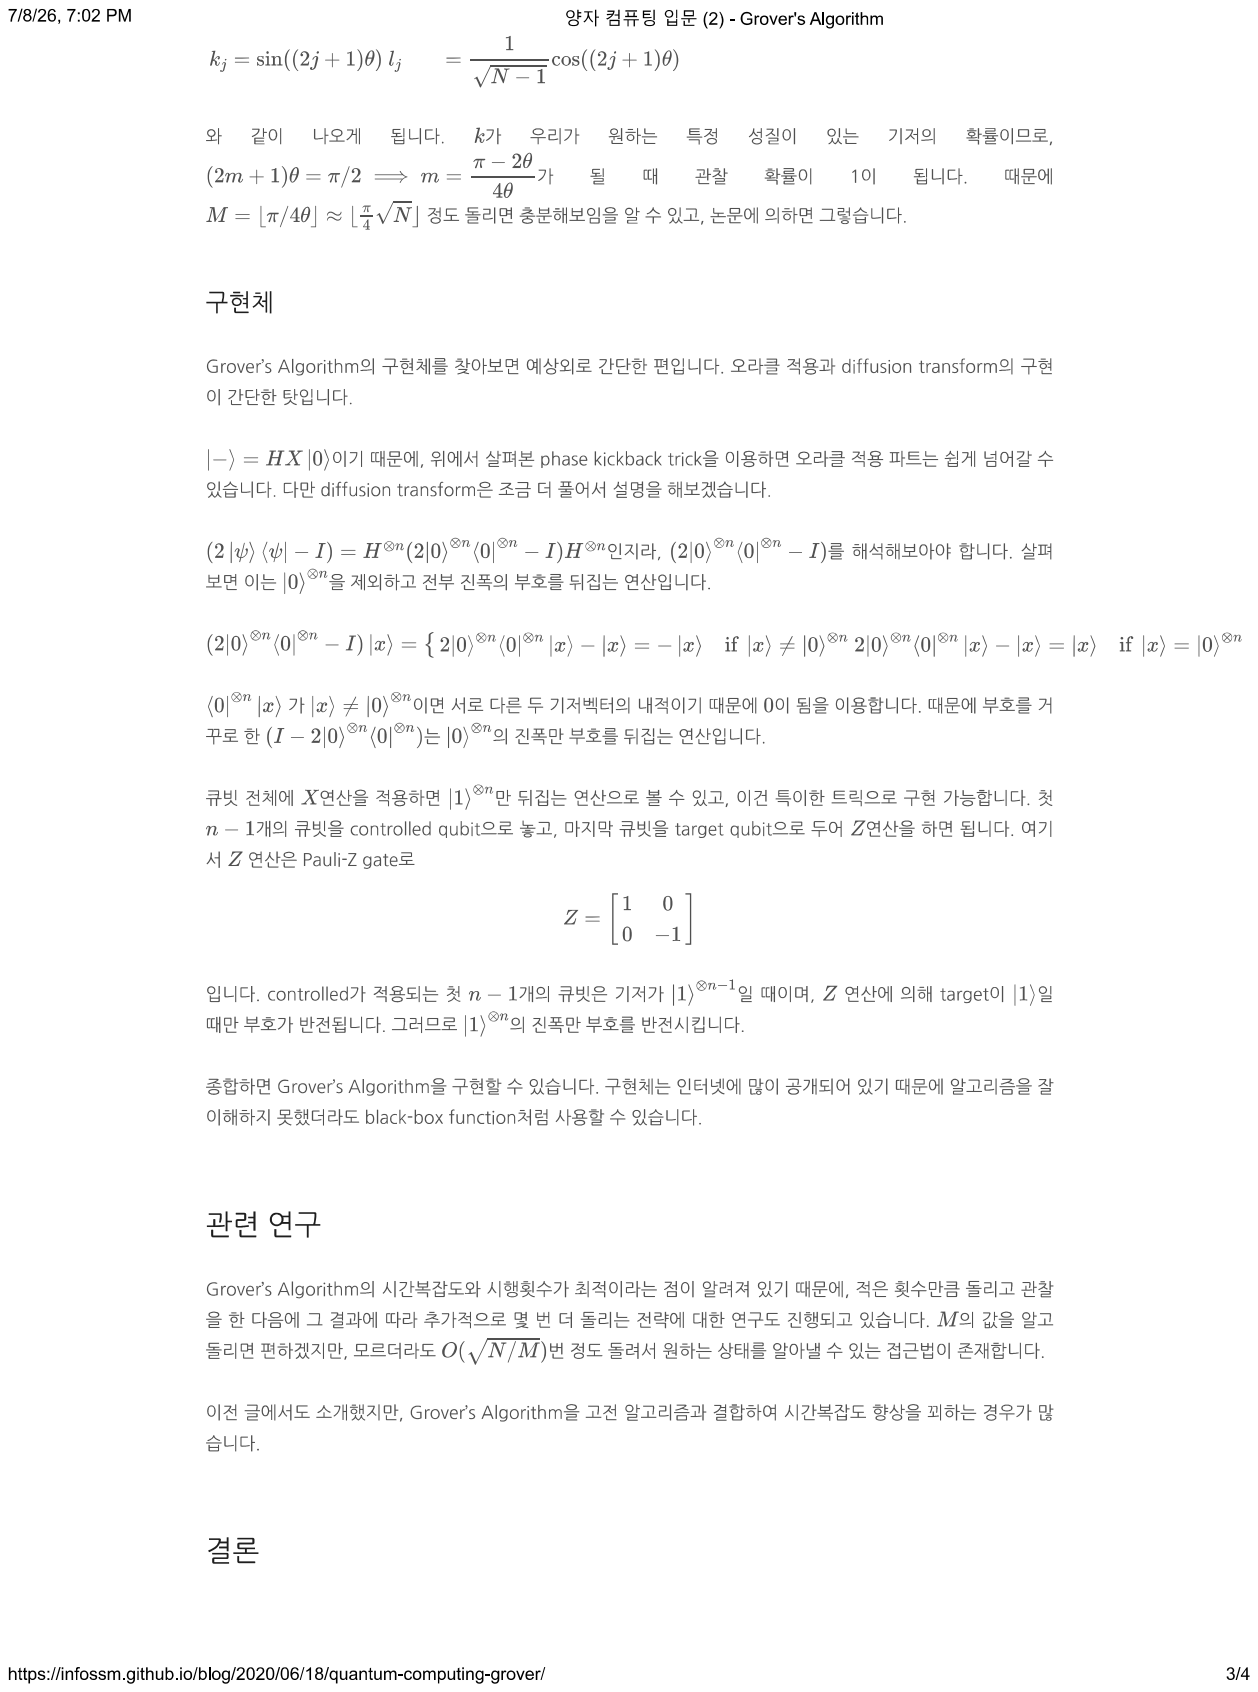
[picture p16: page 3]

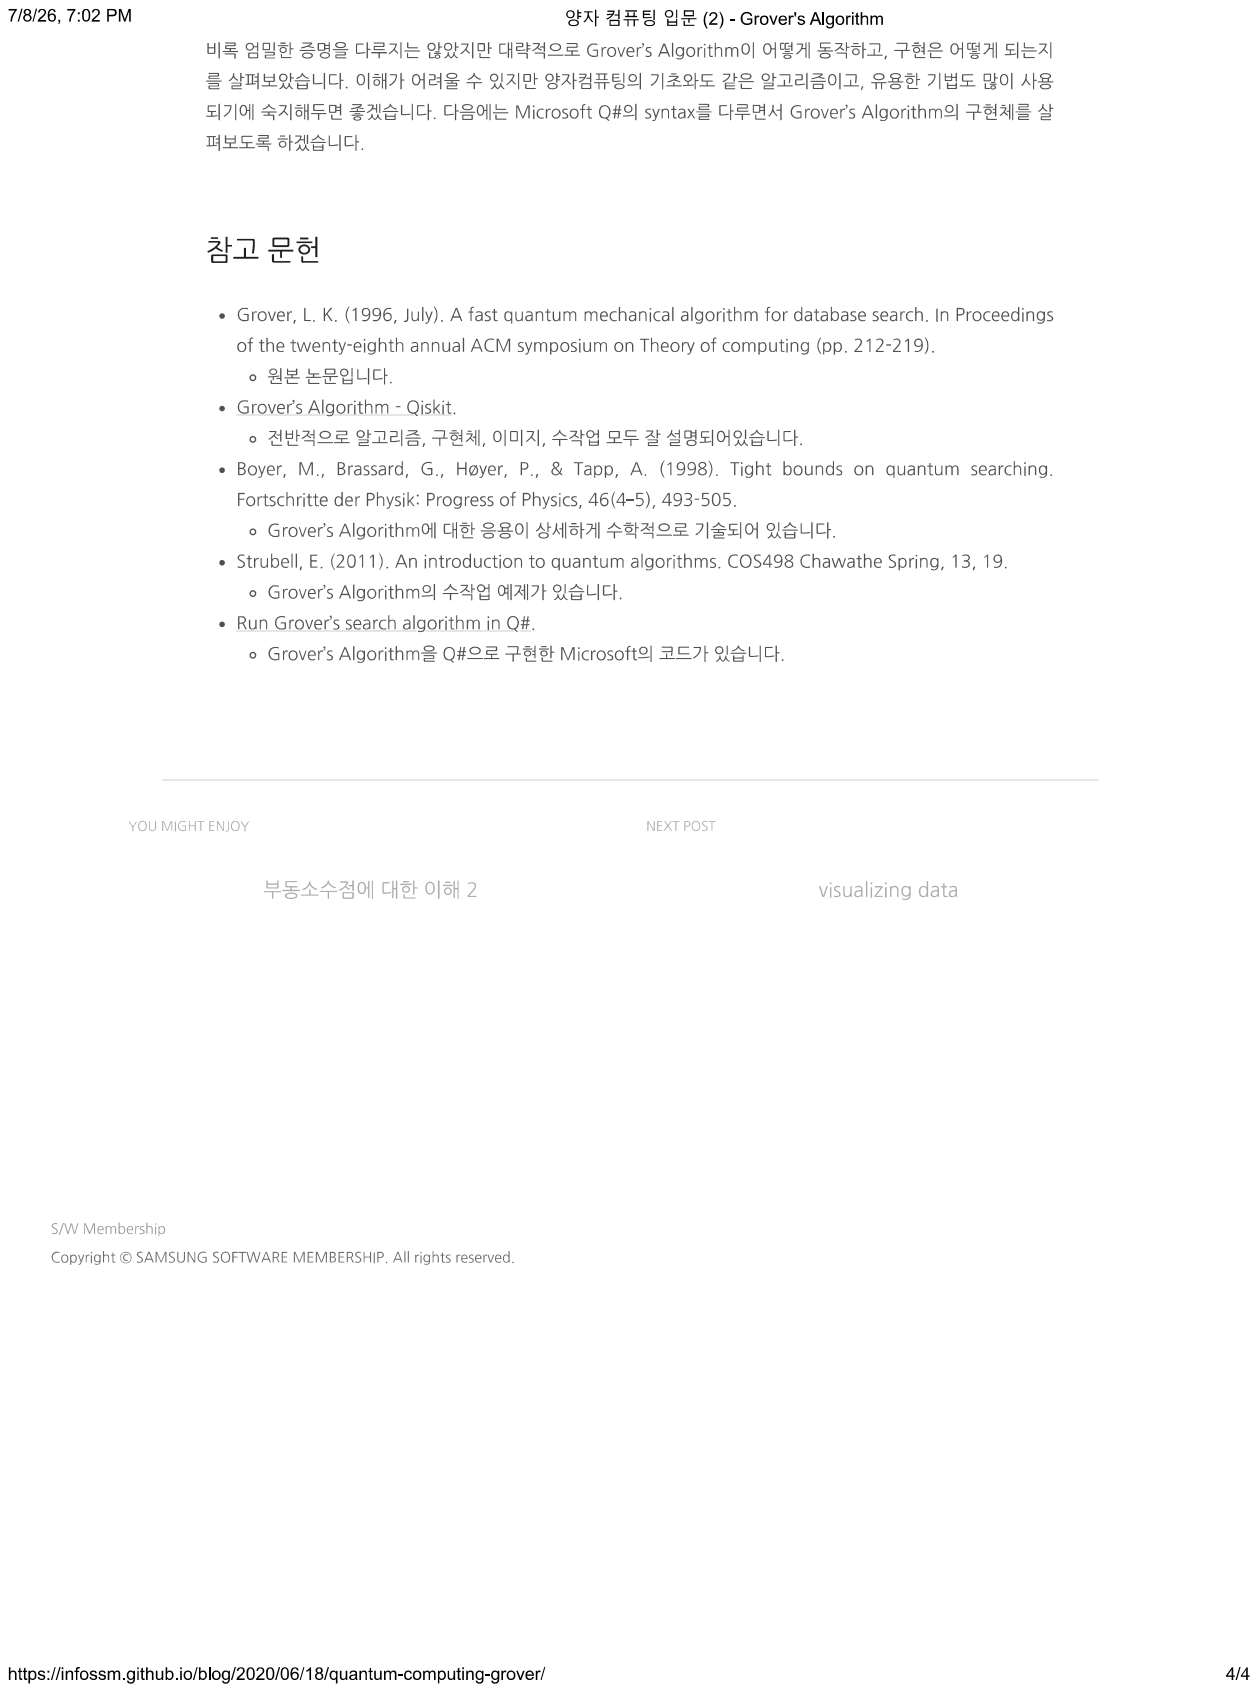
[picture p17: page 4]
