Git-Junsang/Quantum-Grover/Quantum-Grover/hardware_bram/configurations/final_200mhz/src/grover_measurement.v

//==============================================================================
// grover_measurement.v -- BBHT/Grover Main IP + E4 Measurement M2
//
// File-level consolidation is preserved; module hierarchy is unchanged.
// v0.7f retains the v0.7e Born-square DSP-input and 32-lane square
// reduction tree for routed 100-MHz timing closure. Exact Born arithmetic,
// rejection/CDF semantics, lane ordering, and PRNG order are preserved.
// Consolidated from: grover_born_square32.v, grover_born_reject64.v, grover_born_sampler.v, grover_verify.v, grover_measure_verify.v
//==============================================================================


//------------------------------------------------------------------------------
// BEGIN preserved module source: grover_born_square32.v
//------------------------------------------------------------------------------
//==============================================================================
// grover_born_square32.v -- BBHT/Grover Main IP v0.7e
//
// 32-lane exact Born-square pipeline with routed-timing closure.
//
// Routed v0.7d timing showed two independent critical paths inside this block:
//   (1) amp_mem BRAM -> 23x23 DSP square -> sq1/PREG
//       ~10.4 ns data path
//   (2) sq1/PREG -> full 32-lane reduction tree -> row_sum register
//       ~11.2 ns data path, design WNS ~ -1.199 ns
//
// v0.7e adds TWO latency-only timing boundaries:
//   Stage A : amp_mem data -> amp0 input REG
//   Stage B : amp0 -> 23x23 DSP square -> sq1 REG/PREG
//   Stage C : reduction 32->16->8 -> part2 REG
//   Stage D : reduction 8->4->2->1 -> row_sum REG
//
// The reduction tree uses only the exact mathematically-required width at each
// level (47/48/49/50/51 bits). No truncation, rounding, normalization, lane
// reordering, or probability change is introduced.
//
// out_sq/out_row/out_valid are delayed with the same transaction so the external
// sampler contract stays unchanged. Throughput remains one row per clock after
// pipeline fill. The sampler FSM does NOT need a fixed-cycle edit because it
// already waits on sq_valid for both BUILD completion and selected-row reread.
//==============================================================================
`timescale 1ns/1ps
`include "grover_param.vh"

module grover_born_square32 (
    input  wire                                  clk,
    input  wire                                  rstn,
    input  wire                                  in_valid,
    input  wire [`GP_ROW_W-1:0]                  in_row,
    input  wire [`GP_P*`GP_AMP_W-1:0]            in_amp,
    output wire                                  out_valid,
    output wire [`GP_ROW_W-1:0]                  out_row,
    output wire [`GP_P*`GP_SQUARE_W-1:0]         out_sq,
    output wire [`GP_ROW_SUM_W-1:0]              out_row_sum
);
    localparam integer P   = `GP_P;          // 32
    localparam integer AW  = `GP_AMP_W;      // 23
    localparam integer SQW = `GP_SQUARE_W;   // 46
    localparam integer RSW = `GP_ROW_SUM_W;  // 51

    // Exact reduction widths:
    //   32 leaves x 46b
    //   32->16 : 47b
    //   16-> 8 : 48b   <-- timing cut/register here
    //    8-> 4 : 49b
    //    4-> 2 : 50b
    //    2-> 1 : 51b
    localparam integer L1W = SQW + 1;
    localparam integer L2W = SQW + 2;
    localparam integer L3W = SQW + 3;
    localparam integer L4W = SQW + 4;
    localparam integer L5W = SQW + 5;

    // Pipeline valid/tag chain.
    reg v0, v1, v2, v3;
    reg [`GP_ROW_W-1:0] row0, row1, row2, row3;

    // Stage A: explicit registered DSP input transaction.
    // Vivado may legally absorb these lane registers into DSP48E1 AREG/BREG;
    // that is desirable and still preserves this clock boundary.
    reg [P*AW-1:0] amp0;

    // Stage B: exact per-lane squares. Vivado previously mapped this registered
    // result into DSP48E1 PREG, which is also desirable.
    reg [P*SQW-1:0] sq1;

    // Delay all lane squares so out_sq remains aligned with the final row sum.
    reg [P*SQW-1:0] sq2;
    reg [P*SQW-1:0] sq3;

    // Stage C timing cut: 8 exact partial sums after two reduction levels.
    reg [8*L2W-1:0] part2_reg;

    // Stage D output row sum.
    reg [RSW-1:0] row_sum3;

    // ------------------------------------------------------------------------
    // Front half of reduction tree: 32 -> 16 -> 8
    // ------------------------------------------------------------------------
    wire [16*L1W-1:0] level1_bus;
    wire [ 8*L2W-1:0] level2_bus;

    genvar i;
    generate
        for (i = 0; i < 16; i = i + 1) begin : g_red_l1
            wire [SQW-1:0] a;
            wire [SQW-1:0] b;
            assign a = sq1[(2*i  )*SQW +: SQW];
            assign b = sq1[(2*i+1)*SQW +: SQW];
            assign level1_bus[i*L1W +: L1W] =
                {1'b0, a} + {1'b0, b};
        end

        for (i = 0; i < 8; i = i + 1) begin : g_red_l2
            wire [L1W-1:0] a;
            wire [L1W-1:0] b;
            assign a = level1_bus[(2*i  )*L1W +: L1W];
            assign b = level1_bus[(2*i+1)*L1W +: L1W];
            assign level2_bus[i*L2W +: L2W] =
                {1'b0, a} + {1'b0, b};
        end
    endgenerate

    // ------------------------------------------------------------------------
    // Back half of reduction tree: 8 -> 4 -> 2 -> 1
    // ------------------------------------------------------------------------
    wire [4*L3W-1:0] level3_bus;
    wire [2*L4W-1:0] level4_bus;
    wire [  L5W-1:0] level5_sum;

    generate
        for (i = 0; i < 4; i = i + 1) begin : g_red_l3
            wire [L2W-1:0] a;
            wire [L2W-1:0] b;
            assign a = part2_reg[(2*i  )*L2W +: L2W];
            assign b = part2_reg[(2*i+1)*L2W +: L2W];
            assign level3_bus[i*L3W +: L3W] =
                {1'b0, a} + {1'b0, b};
        end

        for (i = 0; i < 2; i = i + 1) begin : g_red_l4
            wire [L3W-1:0] a;
            wire [L3W-1:0] b;
            assign a = level3_bus[(2*i  )*L3W +: L3W];
            assign b = level3_bus[(2*i+1)*L3W +: L3W];
            assign level4_bus[i*L4W +: L4W] =
                {1'b0, a} + {1'b0, b};
        end
    endgenerate

    assign level5_sum =
        {1'b0, level4_bus[0*L4W +: L4W]} +
        {1'b0, level4_bus[1*L4W +: L4W]};

    integer k;
    reg signed [AW-1:0]  amp_k;
    reg signed [SQW-1:0] prod_k;

    always @(posedge clk) begin
        if (!rstn) begin
            v0        <= 1'b0;
            v1        <= 1'b0;
            v2        <= 1'b0;
            v3        <= 1'b0;
            row0      <= {`GP_ROW_W{1'b0}};
            row1      <= {`GP_ROW_W{1'b0}};
            row2      <= {`GP_ROW_W{1'b0}};
            row3      <= {`GP_ROW_W{1'b0}};
            amp0      <= {(P*AW){1'b0}};
            sq1       <= {(P*SQW){1'b0}};
            sq2       <= {(P*SQW){1'b0}};
            sq3       <= {(P*SQW){1'b0}};
            part2_reg <= {(8*L2W){1'b0}};
            row_sum3  <= {RSW{1'b0}};
        end else begin
            // Stage A: register BRAM output transaction before the DSPs.
            v0 <= in_valid;
            if (in_valid) begin
                row0 <= in_row;
                amp0 <= in_amp;
            end

            // Stage B: 32 exact 23x23 squares, registered at DSP output/PREG.
            v1 <= v0;
            if (v0) begin
                row1 <= row0;
                for (k = 0; k < P; k = k + 1) begin
                    amp_k  = $signed(amp0[k*AW +: AW]);
                    prod_k = amp_k * amp_k;
                    sq1[k*SQW +: SQW] <= prod_k;
                end
            end

            // Stage C: first two reduction levels, then explicit timing cut.
            v2 <= v1;
            if (v1) begin
                row2      <= row1;
                sq2       <= sq1;
                part2_reg <= level2_bus;
            end

            // Stage D: remaining three reduction levels and aligned lane output.
            v3 <= v2;
            if (v2) begin
                row3     <= row2;
                sq3      <= sq2;
                row_sum3 <= level5_sum;
            end
        end
    end

    assign out_valid   = v3;
    assign out_row     = row3;
    assign out_sq      = sq3;
    assign out_row_sum = row_sum3;
endmodule
//------------------------------------------------------------------------------
// END preserved module source: grover_born_square32.v
//------------------------------------------------------------------------------
// END preserved module source: grover_born_square32.v
//------------------------------------------------------------------------------

//==============================================================================
// grover_born_square32_p -- grover_born_square32 for 200 MHz
//
// Same exact squares and the same exact reduction widths
// (46 -> 47 -> 48 -> 49 -> 50 -> 51 bits, unsigned, adjacent pairs), so
// out_row_sum is bit-identical.  Register boundaries:
//
//   in -> [amp0] -> square -> [m1] -> [sq1] -> L1 [] L2 [] L3 [] L4 [] L5 []
//
// amp0 / m1 / sq1 are the DSP48E1 A/B, M and P registers of the two-DSP
// 23x23 multiplier.  The data flops have no clock enable; in_valid only
// travels down the valid pipe.
//
// The lane squares for the selected-row reread are taken from sq1 with their
// own valid (sq_valid) instead of being delayed to line up with the row sum;
// the reread does not use the row sum, and the five-level delay line would
// have cost 7,360 flops.
//==============================================================================
module grover_born_square32_p (
    input  wire                                  clk,
    input  wire                                  rstn,
    input  wire                                  in_valid,
    input  wire [`GP_ROW_W-1:0]                  in_row,
    input  wire [`GP_P*`GP_AMP_W-1:0]            in_amp,
    output wire                                  sq_valid,
    output wire [`GP_P*`GP_SQUARE_W-1:0]         out_sq,
    output wire                                  out_valid,
    output wire [`GP_ROW_W-1:0]                  out_row,
    output wire [`GP_ROW_SUM_W-1:0]              out_row_sum
);
    localparam integer P   = `GP_P;
    localparam integer AW  = `GP_AMP_W;
    localparam integer SQW = `GP_SQUARE_W;
    localparam integer RSW = `GP_ROW_SUM_W;

    // Valid / row tag: amp0, m1, sq1, L1, L2, L3, L4, L5 = 8 stages.
    reg [7:0] v;
    reg [`GP_ROW_W-1:0] row [0:7];
    integer s;
    always @(posedge clk) begin
        if (!rstn) v <= 8'd0;
        else       v <= {v[6:0], in_valid};
    end
    always @(posedge clk) begin
        row[0] <= in_row;
        for (s = 1; s < 8; s = s + 1) row[s] <= row[s-1];
    end

    reg [P*AW-1:0]  amp0;
    reg [P*SQW-1:0] m1;
    reg [P*SQW-1:0] sq1;
    reg [SQW:0]   l1 [0:15];
    reg [SQW+1:0] l2 [0:7];
    reg [SQW+2:0] l3 [0:3];
    reg [SQW+3:0] l4 [0:1];
    reg [SQW+4:0] l5;

    integer k;
    reg signed [AW-1:0]  amp_k;
    reg signed [SQW-1:0] prod_k;
    always @(posedge clk) begin
        amp0 <= in_amp;
        for (k = 0; k < P; k = k + 1) begin
            amp_k  = $signed(amp0[k*AW +: AW]);
            prod_k = amp_k * amp_k;
            m1[k*SQW +: SQW] <= prod_k;
        end
        sq1 <= m1;
        for (k = 0; k < 16; k = k + 1)
            l1[k] <= {1'b0, sq1[(2*k)*SQW +: SQW]} + {1'b0, sq1[(2*k+1)*SQW +: SQW]};
        for (k = 0; k < 8; k = k + 1) l2[k] <= {1'b0, l1[2*k]} + {1'b0, l1[2*k+1]};
        for (k = 0; k < 4; k = k + 1) l3[k] <= {1'b0, l2[2*k]} + {1'b0, l2[2*k+1]};
        for (k = 0; k < 2; k = k + 1) l4[k] <= {1'b0, l3[2*k]} + {1'b0, l3[2*k+1]};
        l5 <= {1'b0, l4[0]} + {1'b0, l4[1]};
    end

    assign sq_valid    = v[2];
    assign out_sq      = sq1;
    assign out_valid   = v[7];
    assign out_row     = row[7];
    assign out_row_sum = l5;
endmodule

//------------------------------------------------------------------------------
// BEGIN preserved module source: grover_born_reject64.v
//------------------------------------------------------------------------------
//==============================================================================
// grover_born_reject64.v -- v0.7 registered Born rejection mapper
//
// Purpose
//   This block is the actual timing-closed rejection datapath used by
//   grover_born_sampler.  It is no longer a disconnected reference-only module.
//
// Exact algorithmic contract
//   W = 0 : zero_weight=1
//   W = 1 : direct_one=1, threshold is handled by caller as r=0 with NO draw
//   W > 1 : k = bit_length(W-1)
//           candidate = low-k bits of rnd64
//           accept iff candidate < W
//
// Timing-closure structure
//   load_weight edge:
//       total_weight -> (W-1) -> bit_length -> k_bits REG
//
//   map_candidate edge:
//       registered k_bits + rnd64 -> exact low-k selector -> candidate REG
//
//   following cycle:
//       registered candidate < stable total_weight -> accept
//
// This replaces the pre-v0.7 arithmetic dynamic mask
//     (64'h1 << k) - 1
// with the bit-exact low-k selector.  It is a 100-MHz timing retime only;
// random mapping, rejection distribution, and SW-Golden-visible values do not
// change.  The sampler controls exactly when the two register boundaries fire.
//==============================================================================
`timescale 1ns/1ps
`include "grover_param.vh"

module grover_born_reject64 (
    input  wire                                  clk,
    input  wire                                  rstn,

    // Pulse in the sampler's S_CHECK_W cycle. W is stable for all retries.
    input  wire                                  load_weight,

    // Pulse after the sampler has collected one complete HI->LO rnd64 pair.
    input  wire                                  map_candidate,

    input  wire [`GP_TOTAL_WEIGHT_W-1:0]         total_weight,
    input  wire [63:0]                           rnd64,

    output reg  [5:0]                            k_bits,
    output reg  [`GP_TOTAL_WEIGHT_W-1:0]         candidate,
    output wire                                  accept,
    output wire                                  direct_one,
    output wire                                  zero_weight
);
    localparam integer TW = `GP_TOTAL_WEIGHT_W;

    reg [5:0]    k_comb;
    reg [TW-1:0] candidate_comb;
    reg [TW-1:0] w_minus1_r;
    integer k_i;
    integer map_i;

    // 200 MHz: stage A is split over two edges and runs every cycle.
    //   edge 1: w_minus1_r = (W > 1) ? W-1 : 0        (60-bit decrement)
    //   edge 2: k_bits     = bit_length(w_minus1_r)    (priority encoder)
    // total_weight is fixed from S_CHECK_W until the measurement ends and
    // k_bits is first used on the S_RND_MAP edge, three edges after
    // S_CHECK_W, so the value seen there is the same k as before.  For
    // W <= 1, bit_length(0) = 0 as before.  load_weight is no longer used.
    always @* begin
        k_comb = 6'd0;
        for (k_i = 0; k_i < TW; k_i = k_i + 1) begin
            if (w_minus1_r[k_i])
                k_comb = k_i + 1;
        end
    end

    // Stage B: exact low-k selection. No arithmetic dynamic-mask carry chain.
    always @* begin
        candidate_comb = {TW{1'b0}};
        for (map_i = 0; map_i < TW; map_i = map_i + 1) begin
            if (map_i < k_bits)
                candidate_comb[map_i] = rnd64[map_i];
        end
    end

    always @(posedge clk) begin
        if (!rstn) begin
            w_minus1_r <= {TW{1'b0}};
            k_bits     <= 6'd0;
            candidate  <= {TW{1'b0}};
        end else begin
            w_minus1_r <= (total_weight > {{(TW-1){1'b0}},1'b1}) ?
                          (total_weight - {{(TW-1){1'b0}},1'b1}) : {TW{1'b0}};
            k_bits     <= k_comb;

            if (map_candidate)
                candidate <= candidate_comb;
        end
    end

    wire _unused_load_weight = load_weight;

    assign zero_weight = (total_weight == {TW{1'b0}});
    assign direct_one  = (total_weight == {{(TW-1){1'b0}},1'b1});

    // W=1 is architecturally accepted without a random draw by the caller.
    // Keeping direct_one in accept preserves the standalone module contract.
    assign accept = direct_one ||
                    ((total_weight > {{(TW-1){1'b0}},1'b1}) &&
                     (candidate < total_weight));
endmodule
//------------------------------------------------------------------------------
// END preserved module source: grover_born_reject64.v
//------------------------------------------------------------------------------

//==============================================================================
// grover_row_weight_mem_m1_2w -- E4 measurement M1 helper
//
// Two writes/cycle for consecutive even/odd rows, one sequential read/cycle for
// the unchanged baseline ROW_SCAN.  The 512x51 logical array is banked by row
// parity into 2x(256x51).  Exact row-weight contents and scan semantics are
// unchanged; only BUILD write bandwidth is doubled.
//==============================================================================
module grover_row_weight_mem_m1_2w (
    input  wire                          clk,
    input  wire                          rd_en,
    input  wire [`GP_ROW_W-1:0]          rd_row,
    output wire [`GP_ROW_SUM_W-1:0]      rd_weight,

    input  wire                          wr0_en,
    input  wire [`GP_ROW_W-1:0]          wr0_row,
    input  wire [`GP_ROW_SUM_W-1:0]      wr0_weight,
    input  wire                          wr1_en,
    input  wire [`GP_ROW_W-1:0]          wr1_row,
    input  wire [`GP_ROW_SUM_W-1:0]      wr1_weight
);
    localparam integer RSW = `GP_ROW_SUM_W;
    localparam integer BW  = `GP_ROW_W - 1;

    (* ram_style = "block" *) reg [RSW-1:0] mem_even [0:(`GP_ROWS/2)-1];
    (* ram_style = "block" *) reg [RSW-1:0] mem_odd  [0:(`GP_ROWS/2)-1];

    reg [RSW-1:0] rd_even_q;
    reg [RSW-1:0] rd_odd_q;
    reg           rd_bank_d;

    wire wr_even_en = (wr0_en && !wr0_row[0]) || (wr1_en && !wr1_row[0]);
    wire wr_odd_en  = (wr0_en &&  wr0_row[0]) || (wr1_en &&  wr1_row[0]);

    wire [BW-1:0] wr_even_addr = (wr0_en && !wr0_row[0]) ?
                                      wr0_row[`GP_ROW_W-1:1] :
                                      wr1_row[`GP_ROW_W-1:1];
    wire [BW-1:0] wr_odd_addr  = (wr0_en &&  wr0_row[0]) ?
                                      wr0_row[`GP_ROW_W-1:1] :
                                      wr1_row[`GP_ROW_W-1:1];

    wire [RSW-1:0] wr_even_data = (wr0_en && !wr0_row[0]) ?
                                      wr0_weight : wr1_weight;
    wire [RSW-1:0] wr_odd_data  = (wr0_en &&  wr0_row[0]) ?
                                      wr0_weight : wr1_weight;

    always @(posedge clk) begin
        if (rd_en) begin
            rd_even_q <= mem_even[rd_row[`GP_ROW_W-1:1]];
            rd_odd_q  <= mem_odd [rd_row[`GP_ROW_W-1:1]];
            rd_bank_d <= rd_row[0];
        end

        if (wr_even_en)
            mem_even[wr_even_addr] <= wr_even_data;
        if (wr_odd_en)
            mem_odd[wr_odd_addr] <= wr_odd_data;
    end

    assign rd_weight = rd_bank_d ? rd_odd_q : rd_even_q;
endmodule

//------------------------------------------------------------------------------
// BEGIN preserved module source: grover_born_sampler.v
//------------------------------------------------------------------------------
//==============================================================================
// grover_born_sampler.v -- Row->Lane Born + E4 M1/M2 hierarchical measurement
//
// Baseline flow:
//   1) Scan all 512 amplitude rows read-only.
//      32x |amp|^2 -> row_sum -> row_weight[512], total W.
//   2) W=0 : terminal zero_weight_error.
//      W=1 : threshold r=0 directly, no random draw.
//      W>1 : consume two LFSR_MEAS draws (hi->lo), apply dynamic-width
//            rejection; reject consumes a new complete pair.
//   3) E4 M2 hierarchical scan: BUILD also records the exact global CDF at
//      each 32-row group boundary (16 groups total). Measurement first finds
//      the FIRST group endpoint > r, then scans only that group in the existing
//      row_weight memory. Legacy mode keeps the full 512-row scan.
//      local_r = r - cumulative_before_selected_row.
//   4) Read only the selected amplitude row, square its 32 lanes, and choose
//      the FIRST lane cumulative sum > local_r.
//   5) candidate = {selected_row, selected_lane}.
//
// This block never writes amp_mem.  The external integration must connect the
// read port only and keep amp_mem write enable low during measurement.
//==============================================================================
`timescale 1ns/1ps
`include "grover_param.vh"

//==============================================================================
// grover_sub60_cs -- {borrow, a - b} for 60-bit unsigned a, b (carry-select)
//
// Same result as {1'b0,a} - {1'b0,b}: borrow = (b > a), diff = (a - b) mod
// 2^60.  The low 30 bits and both possible high halves (borrow-in 0 and 1)
// are computed side by side and the low borrow picks one, so the longest
// carry chain is 31 bits instead of 61.
//
// The two high candidates are written as two different additions
// ({1'b0,A} + {1'b1,~B} with and without +1, the +1 carried in through an
// extra LSB) so synthesis cannot derive one from the other by a second
// chain (it did for "x - 1"), and keep stops it from merging them.
//==============================================================================
module grover_sub60_cs (
    input  wire [59:0] a,
    input  wire [59:0] b,
    output wire [59:0] diff,
    output wire        borrow
);
    wire [30:0] lo = {1'b0, a[29:0]} - {1'b0, b[29:0]};
    // {1'b0,A} - {1'b0,B} - cin = {1'b0,A} + {1'b1,~B} + (1 - cin)  (mod 2^31)
    (* keep = "true" *) wire [31:0] hi0_x = {1'b0, a[59:30], 1'b1} + {1'b1, ~b[59:30], 1'b1};
    (* keep = "true" *) wire [30:0] hi1   = {1'b0, a[59:30]} + {1'b1, ~b[59:30]};
    wire [30:0] hi0 = hi0_x[31:1];
    wire [30:0] hi = lo[30] ? hi1 : hi0;
    assign diff   = {hi[29:0], lo[29:0]};
    assign borrow = hi[30];
endmodule

//==============================================================================
// grover_add60_cs -- (a + b) mod 2^60, carry-select (low 30 bits and both
// possible high halves side by side).  Same sum as a + b.
//==============================================================================
module grover_add60_cs (
    input  wire [59:0] a,
    input  wire [59:0] b,
    output wire [59:0] sum
);
    wire [30:0] lo = {1'b0, a[29:0]} + {1'b0, b[29:0]};
    // a + b + 1 as its own addition: the +1 enters through an extra LSB.
    (* keep = "true" *) wire [29:0] hi0   = a[59:30] + b[59:30];
    (* keep = "true" *) wire [30:0] hi1_x = {a[59:30], 1'b1} + {b[59:30], 1'b1};
    wire [29:0] hi1 = hi1_x[30:1];
    assign sum = {lo[30] ? hi1 : hi0, lo[29:0]};
endmodule
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
