Git-Junsang/Quantum-Grover/(commit log)

2026-09-06 PASS2 융합으로 측정 512행 스캔 제거 (K4/H4 대비 사이클 -9.99%)
    Born 측정은 S_BUILD 에서 amp_mem 512행을 다시 읽어 row_weight 를 만들었다.
    그런데 PASS2 가 새 psi_j 의 한 행(32 x 23비트)을 amp_mem 에 쓰는 그 사이클에
    이미 그 32개 진폭이 데이터패스에 있다. 거기서 바로 제곱·합산하면 512행
    재스캔이 통째로 사라진다.
    src_v3 는 src_v2 의 포크이고 바뀐 것은 측정 경로뿐이다.
    grover_iteration.v row_out_is_pass2 출력 추가
    lpsoc_bbht_grover_main_ip.v grover_born_square32 를 한 벌 더 두고
    PASS2 쓰기와 같이 row_weight 를 만든다
    grover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
2026-09-08 hardware_dram 시뮬레이션 인프라 구축 (동작 수준 DRAM 모델 + 3자 궤적 대조)
    RTL 초안만 있고 검증 수단이 없던 hardware_dram 에 동작 수준 DRAM 모델과
    단위/통합 테스트를 붙였다. amp_store(store/restore 왕복), prep_seq(체크포인트
    K/H 를 대신하는 시퀀서), Main IP 통합(단일탐색 8케이스 + enum 거절)까지
    verilator 회귀로 돈다. equiv 타겟은 같은 자극을 hardware_bram(Normal, K4/H4)
    에도 걸어 valid/idx/trial_count/L_BBHT 가 세 갈래 모두 일치하는지 본다 --
    DRAM 갈래가 보드 검증 v0.9.8 과 같은 계산을 한다는 근거다.
    회귀 과정에서 잡은 실물 결함 세 가지:
    grover_d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
2026-09-08 hardware_dram 250쌍 벤치 -- 보드 실측과 같은 워크로드로 K4/H4 대조
    앞서 만든 equiv 는 손으로 고른 8케이스뿐이라 "DRAM 갈래가 K4/H4 를 이기냐
    지냐"를 결론 낼 표본이 못 됐다. tb_dram_bench250.v 는 보드 실측
    (2026-09-04_k4h4_single_operator_final)이 쓴 것과 같은 워크로드를 그대로
    돌린다 -- 정답 개수 M in {1,4,16,64,256} x 시드 50쌍 = 250, predicate EQ
    threshold 12345. dram 은 250케이스, hardware_bram 은 CHECKPOINT_ENABLE=1
    로 한 번만 빌드해 burst_enable 을 케이스마다 0/1 로 바꿔 Normal/K4H4 를
    같은 빌드에서 얻는다 (실물 칩이 런타임 CSR 로 고르는 것과 같은 방식).
    결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
2026-09-09 저장소 전체 동기화 -- 실물 Main IP·보드 실측·서버 벤치까지 반입
    그동안은 커밋이 직접 손댄 파일만 올라가 있어서 (HEAD 211개) 저장소만
    받아서는 회귀도 빌드도 돌지 않았습니다. 이번 커밋으로 작업 트리 전체를
    맞춥니다. 471개 파일이 바뀌고 추적 파일은 543개가 됩니다.
    무엇이 왜 들어왔는지 아래에 적어 둡니다.
    1. 디렉터리 재편
    ----------------
    - documents/design/ -> documents/design_references/
    설계 문서와 골든 모델 분석 보고서를 한곳에 모았습니다. 다이어그램은
    design_references/diagrams/ 하나만 하위 폴더로 둡니다.
    - documents/papers_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
    [baseline_h4_raw.csv, baseline_h8_raw.csv, bbht_attempts.csv, bbht_fpga_results_template.csv, bbht_raw.csv, bbht_summary.csv, dataset_target_1.csv, dataset_target_16.csv]
2026-09-09 정본을 K3/H3-E4-M2 로 교체 -- 보드 소스·실측·6단계 ablation 반입
    서버 재현 패키지(v1.0_20260909)에서 최종 RTL 과 근거를 가져와 hardware_bram
    정본을 K4/H4 에서 K3/H3-E4-M2 로 바꿉니다.
    소스
    - src_v2(K4/H4 freeze)·src_v3(PASS2 융합 포크) 삭제
    - src/ 를 보드 정본 17개로 교체. 2026-09-07 비트스트림과 sha256 17/17 일치
    - 우리 통신 계층은 src_comm/ 으로 이동. 어댑터를 새 Main IP 에 맞춰 갱신
    (CKPT_K=3, POLICY_H_FUTURE=3, INTRA_ENGINES=4)
    회귀
    - check_ports 를 stub/real/final/dram 네 갈래로 확장. final 은 보드 정본을
    인수인계 계약과 직접 대조하며, 매크로 폭을 grover_pa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
    [by_target.csv, expected_semantics.csv, main_ip_5config.csv, main_ip_6stage.csv, observations.csv, paired.csv, per_run.csv, per_run_k4h4.csv]
2026-09-09 CSR 실행 모드를 CKPT_* 로 개명, v3 비트스트림 묶음 삭제
    이름에 K·H 값을 박아 두면 빌드가 바뀔 때마다 이름이 틀려집니다 -- K4/H8 에서
    K4/H4 를 거쳐 지금은 K3/H3 인데 모드 이름만 K4H8 로 남아 있었습니다.
    - CSR 정본 JSON 의 K4H8_SINGLE·K4H8_ENUM 을 CKPT_SINGLE·CKPT_ENUM 으로.
    헤더 넷과 CSR 규격 문서 재생성
    - 골든 모델 mode 인자 "K4H8" -> "CKPT". 내부 식별자도 같이 맞춤
    (audit_normal_ckpt_attempt_pair, ckpt_physical_iterations,
    출력 파일 expected_ckpt_semantic.json)
    - 옛 이름은 계속 받습니다. RUN_MODE_ALIASES 와 _MODE_ALIASES 가 K4H8_* 과
    "K4H8" 을 새 이름으로 옮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
2026-09-09 250쌍 벤치를 보드 M2 실측과 워크로드별로 대조하도록 고침
    bench250_report.py 가 2026-09-04 K4/H4 보드 합계를 하드코딩해 놓고 있어,
    정본이 K3/H3-E4-M2 로 바뀐 뒤로는 맞을 수 없는 값을 기준으로 삼고
    있었습니다. 같은 코어인 2026-09-08 M2 실측 CSV 를 직접 읽어 겹치는
    250 워크로드를 한 건씩 대조하도록 바꿉니다.
    정본 코어로 돌린 결과 (results/2026-09-10_bench250_final_core/)
    - 궤적 불변식 250/250. plan_fifo_mismatch 0
    - 보드 M2 실측과 result_index·trial_count·L_BBHT·actual_iter 250/250 일치
    - cycle_count 230/250 정확히 일치, 합계 +0.28%. 어긋난 20건은 대부분
    ±3,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
    [per_workload.csv]
2026-09-13 하위 구조를 hardware_dram 에 맞추고 재현 패키지 zip 을 풀어 반입
    hardware_bram
    - tb_driver/tb_bench250/tb_bench500.cpp 를 sim/ 에서 testbench/ 로 (dram 과 같은 자리)
    - 재현 패키지 zip 을 풀어 ablation 공통소스·top 8벌·TB·러너를 src_ablation/,
    testbench/, sim/ 으로. make anchor|publication|kh 추가 (anchor 6단계 사이클 정확 일치)
    - synth/run_resource.sh 가 패키지 트리 없이 돌도록 경로 변경
    - standalone 판은 최종판에 쓰지 않아 반입하지 않음. XDC 만 자원 합성용으로 남김
    - 2026-09-01 실측 묶음의 bench_app.zip 을 제자리에 풀기
    - 미커밋이던 500 워크로드 벤치와 최상단 bbh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
    [bram.csv, dataset_target_1.csv, dataset_target_16.csv, dataset_target_256.csv, dataset_target_4.csv, dataset_target_64.csv, dram_fast.csv, dram_model.csv]
2026-09-13 src_comm 을 src 로 합침
    - 우리 통신 계층(wrapper·mmio·loader·어댑터·user region)과 최상단 bbht_bram_top 을
    src/ 로 옮기고 src_comm/ 을 없앰
    - 보드에 구운 정본 통신 계층(wrapper·mmio·loader·upgrade user region)은 src/ 에서
    빠짐. 태그 board-k3h3-e4-m2 에 그대로 있음
    - RVX 가 뽑아 준 user region 템플릿(.generated)은 rvx/ 로
    - make final 과 check_ports 의 final 갈래, install_to_platform.sh 의 LAYER 를 없앰
    - 문서는 다음 커밋에서 최신판 기준으로 한꺼번에 갱신
2026-09-13 src_ablation 코어를 src 로 합치고 최신판만 남김
    - Main IP 를 6단계 ablation 공통소스 판으로 (bbht_grover_main_ip.v,
    grover_measurement.v). MEAS_M1/M2 스위치 기본값이 1 이라 보드 구성과 동작이
    같음. 나머지 Main IP 11개는 이미 바이트 동일
    - 어댑터와 bbht_bram_top 이 MEAS_M1_ENABLE / MEAS_M2_ENABLE 을 명시적으로 넘김
    - standalone 틀에 딸린 src_ablation/(구성별 top 8벌, UART 브리지, 데이터셋
    생성기, XDC)과 ablation TB·러너, run_resource.sh 를 main 에서 뺌.
    전부 태그 board-k3h3-e4-m2 에 있음
    - CLAUDE.md, README, 설계 문서, 근거 evidence 를 최신판 배치 기준으로 갱신.
    태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
2026-09-13 software folder reordered
    [baseline_h4_raw.csv, baseline_h8_raw.csv, bbht_attempts.csv, bbht_fpga_results_template.csv, bbht_raw.csv, bbht_summary.csv, checkpoint_model_fpga_iteration_delta.csv, common500_all_backend_results.csv]
2026-09-14 documents 정합성 수정
2026-09-16 CSR 정본과 포트 계약을 복구하고 벤치 워크로드 생성기를 새로 씀
    2026-09-13 software 재편에서 빠진 생성물 때문에 hardware_bram/sim 의
    clean 을 뺀 전 타깃과 install_to_platform.sh, 펌웨어 빌드가 멈춰 있었다.
    복구처는 79b7410 (main 의 정규 조상).
    CSR 정본·생성기·생성 헤더는 software/csr/ 를 되살리는 대신
    software/contract/ 로 합쳤다. 재편의 역할 중심 배치에 맞고(contract 는
    이미 포트 계약과 그 대조기의 자리), 디렉터리 깊이가 같아 gen_csr.py 의
    HERE/OUT_DIR/DOC_DIR 를 고칠 필요가 없다. RTL 은 -I 로 풀리므로 한 줄도
    건드리지 않았다.
    gen_csr.py 에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
    [port_contract.tsv]
2026-09-16 bbht_console 에 시뮬 전용 스크립트 모드를 넣음
    RVX 의 시뮬 printf 모듈(ncsim_printf.v:217)이 uart_tx 를 1 로 묶어 둔다.
    보낼 쪽이 없으니 read_line() 의 rx_data_ready 폴링이 영원히 안 풀리고,
    그래서 SoC RTL 시뮬에서 콘솔 앱이 첫 명령도 못 받고 멈춘다. 문서가
    "read_line 에서 멈춘다"고만 적어 두었던 것의 원인이다.
    BBHT_CONSOLE_SCRIPT 를 정의하면 명령을 컴파일 시점 배열에서 한 줄씩
    읽는다. UART 경로 코드는 그대로 두었다 - 정의하지 않은 빌드는
    디스어셈블이 수정 전과 동일한 것을 확인했다.
    에코를 "> CMD" 형태로 내보내므로 시뮬 트랜스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
    [main.c]
2026-09-16 문서를 복구된 상태에 맞춤
    CLAUDE.md 2절: CSR 정본이 software/contract/bbht_grover_csr.json 하나이고
    파생 넷은 생성물, 생성 대상이 아닌 두 곳은 --check 가 대조한다는 것으로 고침.
    "보드 RTL 17개 sha256" 주장의 인용처를 바로잡았다. 주장 자체는 맞다 -
    results/2026-09-09_repro_package_v1.0/sha256_final_rtl.txt 가 17개를 전부
    담고 있고 태그와 17/17 일치하는 것을 확인했다. 그런데 CLAUDE.md 가 걸어 둔
    meta/source_sha256.txt 는 7줄뿐인 부분 기록이라, 그쪽만 보고 "전부 대조했다"
    고 하면 근거가 모자란다. 두 파일의 관계를 명시하고 링크를 매니페스트로
    바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
2026-09-16 우리 통신 계층 판으로 비트스트림까지 다시 구현
    보드에서 한 번도 확인하지 않았던 두 차이 - 통신 계층이 우리 판으로 교체된
    것과 user region 이 가속기 클럭을 clk_accel 대신 gclk_accel 로 무는 것 -
    를 구현 단계까지 확인했다. 보드에는 굽지 않았다. 이 머신에 보드가 없다.
    2026-09-07 보드 이 빌드
    Vivado 2024.2 2026.1
    WNS (100 MHz) +0.126 ns +0.196 ns
    TNS / failing 0 / 0 0 / 0
    LUT 45,284 45,116
    FF 45,223 45,210
    BRAM tile 116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
    [summary.csv]
2026-09-16 SoC RTL 시뮬에서 실제 CPU 가 우리 통신 계층을 구동해 보드 사이클을 재현
    앞선 검증은 전부 테스트벤치가 통신 계층을 직접 두드렸다. 이번에는 RVX
    플랫폼 전체(ORCA RISC-V · micro NoC · APB/AHB NI · 통신 계층 · Main IP)를
    Questa 로 돌리고, 보드에 구운 것과 sha256 이 같은 bbht_paper_bench.elf
    (f01c49a7) 를 그 위에서 실행했다. 우리 통신 계층을 실제 CPU 가 NoC 를
    거쳐 구동한 첫 근거다.
    3,000초 제한에 걸려 261쌍을 돌았다 (M=1·4 전부, M=16 61시드).
    대 bench500 (verilator) mode0 5축 262/262, mode1 5축 261/261
    사이클 합 둘 다 오차 0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
    [per_run.csv]
2026-09-16 bbht_console 을 SoC RTL 시뮬에서 실제로 스크립트 모드로 돌려 호스트 왕복을 확인
    "OK 직후 멈춤, 원인 미확인" 은 시험 절차의 잘못이었다. make bbht_console.sim 이
    시뮬 직전에 앱을 다시 빌드하면서 명령줄로 넘긴 -DBBHT_CONSOLE_SCRIPT 가 빠져
    UART 판이 입력을 기다린 것이다. 앱 폴더 rvx_each.mh 로 RTL 시뮬 빌드에만 정의를
    넣도록 고쳤다. 보드 빌드 ELF 는 바이트 동일하다.
    - 스크립트를 보드 500런 M=4 시드 0 워크로드로 바꾸고 ERR 경로와 ENUM 을 넣음
    - tb_console_seq.cpp / make console-seq: 같은 순서의 verilator 기준값
    - soc_console_check.py: 트랜스크립트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
    [verilator_seq.csv]
2026-09-17 Host+Communicationn+K3H3 Main IP FPGA 실측 완료
2026-09-22 docs: 기술 레퍼런스 문체와 구조 개선
2026-10-06 hardware폴더 구조 변경. model별 폴더를 둠. software qiskit, c++ 그로버 알고리즘 구현 및 테스트 결과 반영
    [arty-100t.cfg, bram_checkpoint_result.csv, bram_nocheckpoint_result.csv, dataset_target_1.csv, dataset_target_16.csv, dataset_target_256.csv, dataset_target_4.csv, dataset_target_64.csv]
2026-10-07 모델 다섯 개에 bbht_paper_bench 앱 추가
    K4H4_E1 · K3H3_E1 · K4H4_E4 · K3H3_E4 · K3H3_E4_M1 의 RVX 설치 스크립트가
    bbht_console 만 올리던 것을 bbht_paper_bench 까지 올리도록 바꿨습니다.
    모델 사이 보드 측정을 최종 모델(K3H3_E4_M2)의 500런 실측을 낸 앱과
    같은 앱으로 맞추기 위해서입니다.
    앱은 CONTROL 의 체크포인트 비트만 켜고 끄고 K · H · E · M 은 비트스트림이
    정하므로, 앱 소스는 바꾸지 않았습니다(main.c sha256 이 여섯 플랫폼 모두
    저장소 원본과 같음). 200T(100T 예산) 비트스트림은 그대로 두고 앱 hex 만
    새로 빌드했습니다.
2026-10-07 6단계 여섯 모델 구현 리포트와 RTL bench500 결과 추가
    현행 hardware_bram/src/ 를 모델 어댑터만 달리 물려 여섯 모델
    (K4H4_E1 · K3H3_E1 · K4H4_E4 · K3H3_E4 · K3H3_E4_M1 · K3H3_E4_M2)을 다시 냈습니다.
    - Arty 100T 실제 구현(굽지 않음, M2 는 2026-09-16 빌드 사용): 다섯 모두 타이밍 통과
    - AX7A200B 용 100T 자원 예산 구현: 여섯 모두 타이밍 통과, Available 이 100T 와 같음.
    원격 보드에서 모델 사이 측정을 할 비트스트림이고, 앱 hex 해시를 함께 남김
    - RTL bench500(보드 앱과 같은 순서, 500 워크로드 x 두 모드): 궤적 500/500,
    물리 반복과 Normal-E1 사이클이 6단계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
2026-10-07 보드 측정 준비: 모델별 bench500 보고, 보드 대조 스크립트, Normal_E1 100T 구현
    - bench500_report.py 가 MODEL 을 받아 그 모델의 6단계 단계와 대조합니다. 전에는 모든
    모델을 최종 모델과만 맞대 K4H4 모델이 틀린 FAIL 로 끝났습니다. 보드 500런 · 250쌍
    대조는 최종 모델에서만 합니다. 2026-10-07 의 여섯 CSV 를 다시 읽어 모두 통과
    - sim/board_vs_bench500.py: 보드 paper_bench 결과(UART 로그 또는 raw CSV)를 그 모델의
    bench500 과 워크로드마다 맞댑니다. 2026-09-08 보드 M2 500런과 사이클까지 500/500
    - Normal_E1 을 Arty 100T 로 구현(굽지 않음, WNS +0.094 ns). 체크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
2026-10-08 200T 보드에서 6단계 여섯 모델 500런 실측, 보드 측정 스크립트 추가
    원격 보드 AX7A200B 한 장에 6단계 여섯 빌드(100T 자원 예산 구현)를 차례로 굽고
    bbht_paper_bench 로 500 워크로드 x 두 모드를 쟀습니다. 여섯 모두 논리 넷과
    사이클이 RTL bench500 과 1,000/1,000 같고, 앱 판정도 모두 PASS 입니다.
    Normal-E1 -> K3/H3-E4-M2 실경과 배수는 7.659x 로 100T 정본 7.626x 와 거의 같습니다.
    - 모델별 측정: vivado/.../2026-10-08_ax7a200b_board_500run (UART 원본, per_run,
    bench500 대조, 해시)
    - 모델별 굽기 묶음: bitstream/2026-10-08_ax7a200b (비트스트림, 앱 hex, 상대경로 OCD 묶음)
    -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
2026-10-08 Normal_E1 빌드 bench500: 체크포인트 빌드 mode0 보다 반복 · 샷마다 2사이클 적음
    체크포인트를 뺀 E1 빌드를 bench500 으로 돌려, 6단계 · 보드의 Normal-E1(K4H4_E1 mode0)과
    맞댔습니다. 논리 넷은 500/500 같고 사이클은 워크로드마다 정확히 2 x (물리 반복 + 샷)
    적어 합계 -77,654 (-0.18%) 입니다. 측정 모듈의 진폭 읽기 지연(1 대 2)과 맞는 차이입니다.
2026-10-08 네 술어: 여섯 모델 RTL Predicate500 통과, 최종 모델 200T 보드 4,000/4,000
    - 기댓값에 K4/H4 정책 물리 반복 열(actual_iter_k4h4)을 더했습니다. 기준모델의 K4H4 모드로
    계산하고, 기존 열은 바이트 단위로 그대로입니다. EQ 합 9,058 이 6단계 K4/H4 와 같습니다
    - bbht_predicate500.py · predicate500_report.py 에 6단계 모델 플랫폼과 K4/H4 갈래 등록,
    sim/Makefile 이 MODEL 로 갈래를 고름
    - 여섯 모델 RTL Predicate500: 네 술어 x 500 x 두 모드가 기준모델과 24,000/24,000
    - board_run.sh 에 predicate500 방식 추가(콘솔 적재 후 원격에서 호스트 도구 실행)
    - 최종 모델 200T 보드 Pre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
2026-10-08 200T 보드에서 여섯 모델 네 술어 Predicate500, 기준모델과 24,000/24,000
    6단계 여섯 빌드를 원격 보드 AX7A200B 에서 네 술어 x 500 x 두 모드로 쟀습니다
    (최종 모델은 앞서, 나머지 다섯은 2026-10-08 21:10~23:30).
    - 여섯 모두 결과 · 궤적 · 물리 반복 · 술어 판정이 기준모델과 4,000/4,000
    - Normal 사이클은 여섯 모두 RTL Predicate500 과 2,000/2,000 같음
    - 체크포인트 사이클은 1,828~1,853/2,000 이 같고, 어긋난 실행은 대부분 memo 청소 한 번
    (K3/H3 +-3,279, K4/H4 +-4,372 사이클). 보드는 네 술어를 이어 돌고 RTL 은 술어마다
    따로 도는 차이
    - 네 술어 합 Normal-E1 ->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
2026-10-08 기술문서 24장: 6단계 모델과 구현 방식별 비교
    여섯 빌드를 같은 200T 보드에서 잰 결과를 한 장에 모으고, 왜 여섯 단계로 나눴는지
    (한 번에 한 요인, 병목이 옮겨 간 순서, M 은 E4 위에서만 가능, 누적 사다리의 한계와
    mode0 보완)를 정리했습니다. 검증 절차 일곱 단계, Arty 100T 구현, RTL bench500,
    보드 EQ 500 · 네 술어, 단계별 손익, 100T 정본 대조, 인용 경계를 담았습니다.
    새로 드러난 두 가지를 적었습니다.
    - K/H 축소는 E1 에서 손해(+137k 사이클), E4 에서 이득(-349k). 늘어난 반복 하나의 값이
    E1 약 1,091 · E4 약 279 사이클이라 사다리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
2026-10-12 SW 기준선 측정: 200T 보드 ORCA · 서버 x86, FPGA 와 궤적 2,000/2,000
    같은 C 기준선 세 모델(naive · 최적화 Normal · 최적화 K3H3)을 200T 보드의 ORCA(50 MHz)와
    서버 x86 코어 하나에서 네 술어 2,000개로 재어, 같은 보드의 K3/H3-E4-M2 와 같은 모드끼리 맞댔습니다.
    - 세 곳 모두 결과 · 시도 · L · 실제 반복이 FPGA 와 2,000/2,000 같음 (② 실제 반복 37,659 까지)
    - ORCA ③ 9,512 초 · ② 3,512 초, FPGA 대비 실경과 19,861x · 15,889x
    - 서버 ③ 0.552 초 · ② 0.297 초, FPGA 대비 1.15x · 1.34x. M=64 · 256 은 서버가 더 빠름
    - ORCA ① 은 반복 1회 19.2분이라 단가로 추정(약 4.58년)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
2026-10-12 docs, 디렉토리 개편
2026-10-27 정책 탐색: seed-first full-bound exact DFS (EXACT_PRUNE=5/6), K3H3_E4_M3_S6 모델
    grover_policy.v 에 full-horizon admissible lower bound + seed-first exact DFS 를
    EXACT_PRUNE=5 로 추가. 프레임마다 SCAN(전 자식 bound) -> seed 정확 평가 ->
    canonical walk 에서 bound 가지치기. bound 는 값 정렬 rank 마스크로 계산해
    요청 하나를 레지스터 한 단에서 비트 연산만으로 처리한다.
    EXACT_PRUNE=6 은 legal action 이 하나뿐인 결정의 하위 탐색을 생략한다
    (선택 결과 동일, 그때 root_cost 는 하한). 기존 모드 0~4 동작은 그대로.
    검증 (합성 안 함):
    - 정책 단독 K3/K4 x H1..8, 모드 5/6: exhaustive 정책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
2026-10-27 기록(진행 중): seed-first 정책 RTL 검증, M2/M3 K/H 비교, S6 Arty 1차 구현
    완성 아님. Arty 100T 2차 구현과 prune0 K/H 전 범위 측정이 남아 있다.
    - grover_policy.v: EXACT_PRUNE=5/6 탐색 제어 블록을 memo hit/miss 분기 앞으로 이동.
    1차 구현의 실패 경로 88개 중 68개(memo BRAM -> 제어 CE)를 없애기 위함.
    정책 단독 34회, regress-real, S6 bench500 이 사이클 단위로 이동 전과 같음.
    - results/2026-10-27_policy_seed_first: 정책 단독 RTL(16셀 x 모드 0/5/6, 7,403/7,403),
    통합 회귀, OOC 타이밍
    - results/2026-10-27_kh_sweep_m2_m3: M3/M2 x K3/K4 x H1..8 통합 bench500,
    stall/전체 사이클 모델, 40셀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
2026-10-28 진행 상태 저장: policy 최적화와 parameterized Main IP 연결
    Save the current policy solver optimizations, generalized Scheduler/Planner/
    Executor integration, parallel iteration and square-engine paths, and the
    existing directory/document reference migrations used by this implementation.
    Record steps 1-6 and their directed integration evidence: two-workload prefixes,
    344 checkpoint vectors, 400 predictor contexts, wide FIFO and recovery checks.
    Full Common500 on the generalized RTL, generalized full-SoC verification,
    200T implementation and board verification remain pending.
    The separate frozen baseline passed Common500 and 90 SoC checks. Its first
    three Vivado attempts were kil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
2026-10-29 RTL 일반화 상한 확장과 policy 검증·결과 정리
    - Checkpoint-Capacity/Lookahead-Shots 1~10, iteration engines 1~20, square engines 1~11 지원
    - 가변 BUILD와 banked row weight를 연결하고 16x32 선택·정밀도·PRNG 계약 유지
    - 최대/기존 구성 full Common500, 홀수 및 독립 병렬도, mismatch/epoch 복구 검증
    - 기존 최적화 policy와 40개 heatmap, 중간 실험 archive 및 보존 검증 기록 포함
    - 유망 전체 구성 선정 후 확장용 memory 복제·padding·cache를 줄이는 계획 문서화
    - policy/checkpoint 예산을 남긴 연산부 최적화 후 후보별 policy parameter 탐색 순서 기록
    확장 구성의 200T fitting, routing t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
2026-10-29 results 정리: 10-26~10-28 과정 묶음 20개를 archive로 이동
    - 최상위 실험 묶음 32개 중 20개를 archive/의 topic directory로 이동해 12개만 남김
    (design_space · implementation_pipeline 신설, policy_search · policy_optimization ·
    policy_unpipeline에 추가)
    - 최상위에는 2026-09 benchmark, 실험 18 Six-Stage Ablation, 실험 34~37 묶음만 유지
    - 실험 보고서 21~35 · index · evidence.md의 link와 helper 네 개의 기본 경로, 묶음 안
    verify_soc.py의 repo root 계산을 새 위치에 맞춤
    - policy_rank_timing 4차 implementation 결과(WNS -14.718 ns, setup 미통과)를 evidence에 기록하고
    종료된 background 실행 기록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
2026-10-29 실험 38: iteration engines x square engines sweep과 200T resource 판정
    - tb_bench500.cpp 에 BENCH_PER_M 층화 표본 추가 (기본 동작 불변),
    generalize_main.py --per-m 과 dse.validate_bench 의 표본 위치 검사
    - 20 workloads 표본이 full Common500 의 같은 행과 byte 동일함을 두 구성에서 확인,
    Common500 Normal 합계 예측 오차 0.18% 이하
    - 1~20 x 1~11 의 220칸 전부를 Normal mode 로 simulation, 실패 0건.
    shot 당 cycle 이 512 / engine 수(올림)의 식으로 220칸 모두 설명됨
    - 기존 200T build 의 모듈 단가와 RTL memory 구조로 200T 판정을 대략 계산:
    지금 RTL 77칸, dataset bank 분할 91칸, 칸별 최대 Ch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
2026-10-29 범용 RTL 상한 E10M9와 amplitude memory · policy cache의 BRAM 형태 정리
    - iteration engines 상한 20 -> 10, square engines 상한 11 -> 9 (200T 경계 후보 전부 포함).
    $fatal 메시지와 BUILD 검증 testbench가 상한 macro를 따르게 함
    - grover_ckpt_mem_parallel: bank마다 그 cycle의 read/write port 하나를 앞에서 고르고
    memory에는 read 1 · write 1만 연결. Vivado OOC에서 BRAM으로 추론됨
    (E9M7 K3H3: amplitude 99 BRAM, 이전 구조는 register로 풀려 synthesis가 끝나지 않음)
    - policy 후보 cache를 주소 mod SCAN_LANES의 bank로 분할해 bank당 write 1 · read 1
    - kh_sweep.generate_stream에 BBHT budget 576 / shot cap 100의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
2026-10-29 진행 중: Vivado 메모리 상한과 synthesis 보정 도구
    - engine_sweep.synth_one: Vivado 를 RLIMIT_AS 10 GiB 로 띄움(사용자 지시, helper 프로세스도 물려받음).
    Vivado 두 개와 Verilator sweep 을 같이 돌리다 메모리 부족으로 끊긴 적이 있어 한 번에 하나만 돌림
    - synth_calibration.py(작업 중): OOC synthesis 점마다 계층별 블록(policy, dataset 복제, amplitude,
    datapath, 제어, measurement, 나머지) 사용량과 policy cache · memo 의 BRAM · LUTRAM 을 모으고,
    Checkpoint-Capacity / Lookahead-Shots 별 policy cache 표를 만듦. 연산부 식은 bank 구조 반영 전이라 임시
    지금까지의 synthesis 관찰(E/M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
2026-10-29 진행 중: Checkpoint-Capacity x Lookahead-Shots sweep 과 reference stream 수정
    - checkpoint_sweep.py: 지정한 iteration engines / square engines 에서 Checkpoint-Capacity 1~10 x
    Lookahead-Shots 1~10 을 RTL 로 재고 칸별 iteration 수 · policy cycle · stall · 총 cycle 표와
    heatmap(작은 값 빨강, panel 별 색 범위)을 그림. --per-m 으로 표본 크기, --engines 로 E/M 선택
    - 결과 2026-10-29_checkpoint_sweep: workloads20(E9M7, 20 workloads)과 workloads100 의 E9M7 · E8M8
    (100 workloads). 나머지 E/M 은 측정 중
    - kh_sweep.generate_stream: BBHT budget 576 / shot cap 100 의 episode 재시작 반영(RTL 요청 예측기와
    Lookahead 창이 달라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
2026-10-29 진행 중: 100 workloads K/H sweep 의 E10M4 · E9M6 · E8M9 결과
    원래 경계 후보 다섯 E/M(E9M7, E8M8, E10M4, E9M6, E8M9)이 모두 끝남. 다섯 모두 실패 0, 100칸.
    총 cycle 최소: E9M7 455,776 / E8M8 465,750 / E9M6 473,477 / E10M4 519,727 (100 workloads 합).
    K/H 분포는 다섯 E/M 이 거의 같음(최소 K8H9~K8H10 부근, K6H8 +0.07~0.12%).
    E9M7 anchor_kh.svg 는 K3H10 재측정 뒤 다시 그린 것. 이후 E/M(E8M4 등)은 merge 된 새 RTL 로 측정.
